lpgn/Carbon-Mini/BOM/screws.pdf

Sheet1

ITEM NO. | PART NUMBER | QTY
49 | Hexagon Flange Nut ISO - 4161 - M5 - N | 100
6 | Hexagon Thin Nut ISO - 4035 - M3 - N | 600
15 | Hexagon Thin Nut ISO - 4035 - M5 - N | 200
30 | ISO 4027 - M2 x 3-N | 100
52 | ISO 4762 – M3 x 12 --- 12N | 100
45 | ISO 7045 - M2 x 10 - Z --- 10N | 100
58 | ISO 7045 - M3 x 10 - Z --- 10N | 200
78 | ISO 7045 - M3 x 16 - Z --- 16N | 200
38 | ISO 7045 - M3 x 20 - Z --- 20N | 100
5 | ISO 7045 - M3 x 25 - Z --- 25N | 200
47 | ISO 7045 - M3 x 6 - Z --- 6N | 100
67 | ISO 7045 - M3 x 8 - Z --- 8N | 100
26 | ISO 7045 - M4 x 12 - Z --- 12N | 100
14 | ISO 7045 - M5 x 10 - Z --- 10N | 100
13 | ISO 7045 - M5 x 12 - Z --- 12N | 100
16 | ISO 7045 - M5 x 20 - Z --- 20N | 100
10 | ISO 7046-1 - M3 x 10 - Z --- 10N | 200
4 | ISO 7046-1 - M3 x 12 - Z --- 12N | 100
25 | ISO 7046-1 - M3 x 8 - Z --- 8N | 200
18 | ISO 7046-1 - M5 x 12 - Z --- 12N | 100
8 | ISO 7380 - M3 x 10 --- 10N | 100
42 | washer (M3 – 0.8mm – 7mm) 10673 type snl_iso | 100
24 | washer (M4 – 0.75mm – 9mm) | 100
