lpgn/Carbon-Mini/BOM/Complete Bom.ods

Sheet: BOM_review
 | ORDER | DESCRIPTION | QTY |  | ORDER | DESCRIPTION | QTY |  | DESCRIPTION | QTY
BAG F |  |  |  | BAG X3 |  |  |  | BAG Y1
 |  | Carbon fiber Z frame's connecting bar | 1 |  | 2 | X-axis Track slider unit (with embedded 3 nuts,172mm) | 1 | BAG Y1A
 | 1 | Carbon fiber main Z frame | 1 | BAG X3 A |  |  |  |  | Carbon fiber Y-axis support | 1
BAG F1 |  |  |  |  | 1 | Round head M3 x 8mm | 3 | BAG Y1B
 |  | M3 nuts | 2 |  |  |  |  |  | Stepper Motor (42HD0401-24 34mm) + 45.5mm wire + Molex 4P | 1
 |  | Round head M3 x 12mm | 2 |  |  |  |  |  | Mini End-stop 45.5mm black thin wire + Molex 3P | 1
BAG F2 |  |  |  |  | 1 | M3 Nut | 3 |  | M2 x 10mm | 2
 | 1 | Carbon fiber Small foot with double face tape and cushion | 4 | BAG X3 B |  |  |  |  | wire Black organizer 38mm | 1
 | 2 | Carbon fiber foot | 2 |  | 3 | Zip ties | 4 |  | zip ties Small | 1
 | 3 | L shaped connector | 4 |  | 4 | MXL Belt (455mm) | 1 |  | Timing Gear 15 tooth MXL | 1
 | 3 | L shaped connector (needs to be drilled to 6mm) | 1 |  | 5 | Round head M3 x 12mm | 1 | BAG Y1C
 | 4 | M5 nuts | 7 |  | 5 | Plastic 5mm washer | 1 |  | Bearings | 4
 | 4 | Round head M5 x 10mm | 1 |  | 6 | M3 Nut | 2 |  | M3 washers | 4
 | 4 | Round head M5 x 12mm | 6 |  | 7 | Printed Extruder's adapter (Rail to tracks) thinken 1mm | 1 |  | Round head M3 x 20mm | 2
BAG F3 |  |  |  |  | 8 | Flat head M3 x 8mm | 4 | BAG Y1D
 | 5 | Precision height Adjuster | 3 | BAG X3 C |  |  |  |  | Round head M3 x 40mm (NUT SCREWED GLUED 25.8) | 2
 | 5 | Magnet - (12x3.79mm) | 3 |  | 9 | Short Track with Slider unit (auto calibration) | 1 |  | M3 nuts | 2
 | 5 | washer 6mm inside | 1 |  | 10 | Round head M3 x 6mm | 2 |  | M3 washers | 2
BAG F4 |  |  |  |  | 11 | Binder clip spring | 1 | BAG Y1E
 |  | Steeper Motor 34mm with 135mm screw 260mm wire Molex P4 | 1 | 1 - BAG E2 – independent |  |  |  |  | Printed Y motor Bracket | 1
 |  | wire Black organizer 255mm | 1 |  |  | Teflon tube 575 mm | 1 |  | M3 nuts | 4
BAG F4 A |  |  |  |  |  |  |  |  | Flat head M3 x10mm | 4
 |  | Printed Z Motor mount NEED TO CHANGE FILE | 1 |  |  |  |  | BAG Y1F
 |  | M3 nuts | 2 |  |  | wire Black organizer 550mm | 1 |  | Printed Magnet spacer | 2
 |  | Round head M3 x 30mm | 2 |  |  | Mini End-stop 58mm black thin wire + Molex 3P | 1 |  | Magnet + (12x3.79mm) | 3
 |  | Flat head M3 x 8mm | 4 |  |  | Assembled hot end unit (with resistor and thermistor) | 1 |  | Flat head M3 x12mm | 1
BAG X1 |  |  |  |  |  | Carbon fiber Hot-end bracket | 1 |  | Flat head M3 x10mm | 2
 | 5 | Carbon fiber X Bridge | 1 |  |  | Round head M3 x 20mm | 2 |  | M3 nuts | 3
BAG X1 A |  |  |  |  |  | Round head M2 x 10mm | 2 | BAG Y2
 | 6 | Round head M3 x 12mm (screwed to the carbon fiber bar and z track) | 2 |  |  | Printed Fan duct mount (Hot-end) | 1 |  | Y-axis Track with slider unit 190mm | 2
 | 6 | Round head M3 x 8mm (screwed to the carbon fiber bar) | 4 |  |  | Big Fan 30mm (Hot-end) + 710 wire with molex 4P and 2p power connector | 1 |  | Acrylic bed | 1
 | 6 | Z-axis Track slider unit (with embedded 3x M3 nuts) | 2 |  |  | Small Fan 26mm (Hot-end) + 650 wire with molex 2P | 2 | BAG Y2 A (OLD B)
 | 2 | Round head M3 x 8mm | 6 |  |  | Round head M2 x 12mm | 8 |  | Round head M3 x 6mm | 8
 | 3 | Round head M3 x 10mm | 2 |  |  | Round head M2 x 20mm | 4 |  | Round head M3 x 6mm | 6
 | 3 | M3 Washers .83mm | 2 |  |  | Small zip tie | 2 | BAG Y4 B (OLD C)
 | 4.5 | Coper nut for motor treaded bar |  | BAG E4 (Extruder Cold end) |  |  |  |  | MXL Belt (300mm) | 1
 | 4 | Printed attachment (X Bridge to Z threaded flange)edit file to compensate washer | 1 |  | 1 | Stepper Motor (42HD0401-24 34mm) + 35mm wire + Molex 4P | 1 |  | Round head M3 x 16mm | 3
 | 1 | Round head M3 x 24mm (attaches the Printed attachment to z special nut) | 3 |  | 2 | Carbon fiber extruder motor spacer | 1 |  | Round head M3 x 20mm | 1
 | 1 | M3 nut | 3 |  | 3 | Extruder Gear | 1 |  | M3 Nut | 4
BAG X2 |  |  |  |  | 4 | Printed Extruder Bracket | 1 |  | spacer 5mm white | 1
 |  | Stepper Motor (42HD0401-24 34mm) + 355mm wire + Molex 4P | 1 | BAG E4 A |  |  |  |  | Printed Belt atachment | 2
BAG X2 A |  |  |  |  | 4 | Teflon quick release adapter | 2 |  | Carbon Fiber Belt atachment | 2
 |  | Printed X Motor attachment | 1 |  | 5 | Flat head M3x 16mm | 1 | BAG P1
 |  | M3 nut | 1 |  | 6 | Bearing for Filament ATTACHED TO LEVER | 1 |  | M3 nut | 4
 |  | Flat head M3 x 8mm | 1 |  | 6 | Printed Extruder Lever (IMPROVE SPACE FOR BEARING) | 1 |  | M3 x 12 --- 12N | 4
 |  | Flat head M3 x 10mm | 1 |  | 6 | M4 Washers | 2 |  | Printer board | 1
 |  | Round head M3 x 8mm (small) | 1 |  | 6 | Round head M4 x 12mm | 1 |  | Plastic 5mm washer | 4
 |  | Timing Gear 15 tooth MXL | 1 |  | 6 | Teflon tube 25mm | 1 |  | Printed printrboard case | 1
BAG X2 B |  |  |  |  | 6 | Teflon quick release adapter | 2 |  | Display
 |  | Round head M3 x 25 - Z --- 25N | 2 |  | 7 | spring 30x15x7.5 | 1 |  | Display cable
 |  | Printed X-axis Bridge spacer | 1 |  | 8 | Round head M3 x 25mm | 1
 |  | Printed X-axis Bridge spacer for end-stop needs to change. To small | 1 |  | 9 | Round head M3 x 30mm | 3
 |  | Mini End-stop 34.5mm black thin wire + Molex 3P | 1
BAG X2 C
 |  | Round head M3 x 20mm | 1
 |  | M3 washer (Dia 7mm) small washer | 1
 |  | Bearings | 2
 |  | M3 nut | 1

Sheet: Parts_Bom
ITEM NO. | PART NUMBER | DESCRIPTION | QTY.
1 | Z Frame | Bag F | 1
2 | Steeper Motor 34mm (42HD0401-135L) | Bag F1 | 1
3 | Z Motor mount | Bag F1 | 1
7 | Z TRACK (MGN9 142.08mm) | Bag F2 | 2
9 | Magnet (12x3.79mm) | Bag F3 (1X) Bag F6 (2X) Bag Y3 (2x) Bag B1 (5x) Bag B2 (4x) | 14
11 | L shaped connector | Bag F4 | 4
12 | Small foot | Bag F4 | 2
17 | Hinge 20x20l | Bag Y4 (1x) | 1
20 | Knurl Adjuster | Bag F6 | 2
21 | Extruder Gear | Bag F7 | 1
22 | Tube (bushings) | Bag F7 | 1
23 | Bearing for Filament (U694) | Bag F7 | 1
27 | Extruder Lever (mirrored) | Bag F7 | 1
28 | Extruder Bracket (mirrored) | Bag F7 | 1
29 | Extruder Stepper Motor (needs reference)2 | Bag F7 | 1
31 | Bed Support | Bag Y | 1
32 | Stepper Motor (42HD0401-24 34mm) | Bag Y1 (1x) Bag X1 (1x) | 2
33 | Timing Gear 15 tooth MXL | Bag Y1 (1x) Bag X1 (1x) | 2
34 | Y Belt (MXL 6mm) Length: ? Mm | Bag Y1 | 1
35 | Y motor Bracket | Bag Y1 | 1
46 | Rail MGN9 | Bag Y3 (2x) Bag X4 (x1) | 5
50 | Printrboard | Bag P1 | 1
51 | Plastic 5mm washer | Bag P1 (4x) Bag B1 (1x) | 5
53 | Y Track (MGN9 190mm) | Bag Y3 (2x) | 2
54 | Y Tracks connection | Bag B1 | 2
57 | BED SPACER | Bag B1 | 2
60 | Glass-bed | Bag B2 | 1
61 | Extruder's adapter (Rail to tracks) | Bag E1 | 1
62 | Rail (MGN9) (for extruder with tracks) | Bag E1 | 1
63 | spring | Bag E1 | 1
64 | Extruder stopper2 | Bag E1 | 1
66 | Auto-calibration Track (MGN9 39mm) | Bag E1 | 1
69 | Hot-end bracket | Bag E1 | 1
70 | End-stop (HT-010-1A-250VAC) | Bag E1 (1x) Bag (1x) Y2 Bag X1 (1x) | 3
73 | Heat Breaker (Hot-end) | Bag E2 | 1
74 | Heat-sink (Hot-end) | Bag E2 | 1
75 | Heat Block (hot-end) | Bag E2 | 1
76 | Nozzle (0.4) (Hot-end) | Bag E2 | 1
79 | FAN for Heat Sink (Hot-end) | Bag E3 | 1
80 | Fan duct hacked (Hot-end) | Bag E3 | 1
81 | Small Fan Mockup (hot-end) | Bag E3 | 2
82 | X Bridge | Bag X | 1
85 | X Motor attachment mirrored | Bag X1 | 1
86 | X Bridge spacer for end-stop | Bag X1 | 1
89 | X Bridge spacer | Bag X1 | 1
90 | X Belt (MXL 6mm) Length: ? Mm | Bag X1 | 1
92 | X Track (MGN9 172mm) | Bag X4 | 1
93 | socket head cap screw_iso2 | Bag X2 | 3
94 | F603HZZ_SOLID_1 | Bag X3 (2x) Bag Y1 (4x) | 6
99 | Threaded Rod Female Special Nut | Bag X4 | 1
100 | Z nut attachment to X Bridge | Bag X4 | 1
 |  |  | 93

Sheet: Screws
ITEM NO. | PART NUMBER | DESCRIPTION | QTY. | times kits (15)
49 | Hexagon Flange Nut ISO - 4161 - M5 - N | Bag Y4 | 2 | 30 | 100
6 | Hexagon Thin Nut ISO - 4035 - M3 - N | Bag F1 (2x) Bag F2 (6x) Bag F3 (1x) Bag Y1 (4x) Bag B1 (13x) Bag X1 (1x) Bag X2 (4x) Bag X3 (1x) Bag X4 (1x) Bag P1 (4x) Bag E1 (2x) | 39 | 585 | 600
15 | Hexagon Thin Nut ISO - 4035 - M5 - N | Bag F4 (6X) Bag F5 (2X) | 8 | 120 | 200
30 | ISO 4027 - M2 x 3-N | Bag F7 | 1 | 15 | 100
52 | ISO 4762 M3 x 12 --- 12N | Bag P1 (4x) Bag B1 (1x) | 5 | 75 | 100
45 | ISO 7045 - M2 x 10 - Z --- 10N | Bag Y2 (2x) Bag E1 (2x) | 4 | 60 | 100
58 | ISO 7045 - M3 x 10 - Z --- 10N | Bag B1 (8x) Bag X4 (3x) Bag X1 (x1) Bag E2 (1x) | 13 | 195 | 200
78 | ISO 7045 - M3 x 16 - Z --- 16N | Bag E3 | 12 | 180 | 200
38 | ISO 7045 - M3 x 20 - Z --- 20N | Bag Y1 (2x) Bag E1 (2x) Bag X3 (1x) | 5 | 75 | 100
5 | ISO 7045 - M3 x 25 - Z --- 25N | Bag F1 (2x) Bag F7 (3X) Bag X1 (2x) Bag Y1 (2) | 7 | 105 | 200
47 | ISO 7045 - M3 x 6 - Z --- 6N | Bag Y3 | 6 | 90 | 100
67 | ISO 7045 - M3 x 8 - Z --- 8N | Bag X1 (1x) Bag E1 (4x) | 5 | 75 | 100
26 | ISO 7045 - M4 x 12 - Z --- 12N | Bag F7 (1x) Bag X1 (1x) Bag X4 (8) | 1 | 15 | 100
14 | ISO 7045 - M5 x 10 - Z --- 10N | Bag F4 | 4 | 60 | 100
13 | ISO 7045 - M5 x 12 - Z --- 12N | Bag F4 | 2 | 30 | 100
16 | ISO 7045 - M5 x 20 - Z --- 20N | Bag F4 | 2 | 30 | 100
10 | ISO 7046-1 - M3 x 10 - Z --- 10N | Bag F3 (1X) Bag Y1 (4x) Bag Y3 (2x) Bag B1 (x1) | 7 | 105 | 200
4 | ISO 7046-1 - M3 x 12 - Z --- 12N | Bag F1 (6x) Bag F6 (2x) | 6 | 90 | 100
25 | ISO 7046-1 - M3 x 8 - Z --- 8N | Bag F7 (1x) Bag E1 (4x) Bag B1 (4x) | 9 | 135 | 200
18 | ISO 7046-1 - M5 x 12 - Z --- 12N | Bag F5 (2x) Bag Y4 (2x) | 2 | 30 | 100
8 | ISO 7380 - M3 x 10 --- 10N | Bag F2 | 6 | 90 | 100
42 | washer (M3 .8mm Dia 7mm) 10673 type snl_iso | Bag Y1 (2x) Bag X3 (1x) | 3 | 45 | 100
24 | washer m4 .75mm diam 9mm | Bag F7 | 2 | 30 | 100
 |  |  | 151

Sheet: Sheet4
BAG B1 |  |  |  | BAG F3 |  |  | BAG Y3
6 | Hexagon Thin Nut ISO - 4035 - M3 - N |  | 13 | 9 | Magnet (12x3.79mm) | 1 | 47 | ISO 7045 - M3 x 6 - Z --- 6N | 6
52 | ISO 4762 M3 x 12 --- 12N |  | 1 | 6 | Hexagon Thin Nut ISO - 4035 - M3 - N | 1 | 10 | ISO 7046-1 - M3 x 10 - Z --- 10N | 2
25 | ISO 7046-1 - M3 x 8 - Z --- 8N |  | 4 | 10 | ISO 7046-1 - M3 x 10 - Z --- 10N | 1 | 9 | Magnet (12x3.79mm) | 2
58 | ISO 7045 - M3 x 10 - Z --- 10N |  | 8 | BAG F4 |  |  | 46 | Rail MGN9 | 2
10 | ISO 7046-1 - M3 x 10 - Z --- 10N |  | 1 | 11 | L shaped connector | 4 | 53 | Y Track (MGN9 190mm) | 2
54 | Y Tracks connection |  | 2 | 12 | Small foot | 2 | BAG Y4
57 | BED SPACER |  | 2 | 14 | ISO 7045 - M5 x 10 - Z --- 10N | 4 | 17 | Hinge 20x20l | 1
51 | Plastic 5mm washer |  | 1 | 13 | ISO 7045 - M5 x 12 - Z --- 12N | 2 | 49 | Hexagon Flange Nut ISO - 4161 - M5 - N | 2
9 | Magnet (12x3.79mm) |  | 5 | 16 | ISO 7045 - M5 x 20 - Z --- 20N | 2 | 18 | ISO 7046-1 - M5 x 12 - Z --- 12N | 2
BAG B2 |  |  |  | 15 | Hexagon Thin Nut ISO - 4035 - M5 - N | 6
60 | Glass-bed |  | 1 | BAG F5 |  |  | BAG P1
9 | Magnet (12x3.79mm) |  | 4 | 15 | Hexagon Thin Nut ISO - 4035 - M5 - N | 2 | 6 | Hexagon Thin Nut ISO - 4035 - M3 - N | 4
BAG E1 |  |  |  | 18 | ISO 7046-1 - M5 x 12 - Z --- 12N | 2 | 52 | ISO 4762 M3 x 12 --- 12N | 4
6 | Hexagon Thin Nut ISO - 4035 - M3 - N |  | 2 | BAG F6 |  |  | 50 | Printrboard | 1
45 | ISO 7045 - M2 x 10 - Z --- 10N |  | 2 | 20 | Knurl Adjuster | 2 | 51 | Plastic 5mm washer | 4
38 | ISO 7045 - M3 x 20 - Z --- 20N |  | 4 | 9 | Magnet (12x3.79mm) | 2
67 | ISO 7045 - M3 x 8 - Z --- 8N |  | 4 | 4 | ISO 7046-1 - M3 x 12 - Z --- 12N | 2 | BAG X1
25 | ISO 7046-1 - M3 x 8 - Z --- 8N |  | 4 |  |  |  | 82 | X Bridge | 1
61 | Extruder's adapter (Rail to tracks) |  | 1 | BAG F7
62 | Rail (MGN9) (for extruder with tracks) |  | 1 | 21 | Extruder Gear | 1 | BAG X1
63 | spring |  | 1 | 22 | Tube (bushings) | 1 | 6 | Hexagon Thin Nut ISO - 4035 - M3 - N | 1
64 | Extruder stopper2 |  | 1 | 23 | Bearing for Filament (U694) | 1 | 58 | ISO 7045 - M3 x 10 - Z --- 10N | 1
66 | Auto-calibration Track (MGN9 39mm) |  | 1 | 27 | Extruder Lever (mirrored) | 1 | 67 | ISO 7045 - M3 x 8 - Z --- 8N | 1
69 | Hot-end bracket |  | 1 | 28 | Extruder Bracket (mirrored) | 1 | 26 | ISO 7045 - M4 x 12 - Z --- 12N | 1
70 | End-stop (HT-010-1A-250VAC) |  | 1 | 29 | Extruder Stepper Motor (needs reference)2 | 1 | 5 | ISO 7045 - M3 x 25 - Z --- 25N | 2
BAG E2 |  |  |  | 30 | ISO 4027 - M2 x 3-N | 1 | 85 | X Motor attachment mirrored | 1
58 | ISO 7045 - M3 x 10 - Z --- 10N |  | 1 | 24 | washer m4 .75mm diam 9mm | 2 | 86 | X Bridge spacer for end-stop | 1
73 | Heat Breaker (Hot-end) |  | 1 | 26 | ISO 7045 - M4 x 12 - Z --- 12N | 1 | 89 | X Bridge spacer | 1
74 | Heat-sink (Hot-end) |  | 1 | 25 | ISO 7046-1 - M3 x 8 - Z --- 8N | 1 | 90 | X Belt (MXL 6mm) Length: ? Mm | 1
75 | Heat Block (hot-end) | v | 1 | 5 | ISO 7045 - M3 x 25 - Z --- 25N | 3 | 32 | Stepper Motor (42HD0401-24 34mm) | 1
76 | Nozzle (0.4) (Hot-end) | v | 1 | BAG Y |  |  | 33 | Timing Gear 15 tooth MXL | 1
BAG E3 |  |  |  | 31 | Bed Support | 1 | 70 | End-stop (HT-010-1A-250VAC) | 1
78 | ISO 7045 - M3 x 16 - Z --- 16N | v | 6 | BAG Y1
79 | FAN for Heat Sink (Hot-end) | v | 1 | 34 | Y Belt (MXL 6mm) Length: ? Mm | 1 | BAG X2
80 | Fan duct hacked (Hot-end) | v | 1 | 35 | Y motor Bracket | 1 | 6 | Hexagon Thin Nut ISO - 4035 - M3 - N | 4
81 | Small Fan Mockup (hot-end) | v | 2 | 32 | Stepper Motor (42HD0401-24 34mm) | 1 | 93 | socket head cap screw_iso2 | 3
82 | Small zip tie |  | 1 | 33 | Timing Gear 15 tooth MXL | 1
BAG F |  |  |  | 94 | F603HZZ_SOLID_1 | 4 | BAG X3
1 | Z Frame |  | 1 | 5 | ISO 7045 - M3 x 25 - Z --- 25N | 2 | 6 | Hexagon Thin Nut ISO - 4035 - M3 - N | 1
BAG F1 |  |  |  | 38 | ISO 7045 - M3 x 20 - Z --- 20N | 2 | 38 | ISO 7045 - M3 x 20 - Z --- 20N | 1
2 | Steeper Motor 34mm (42HD0401-135L) |  | 1 | 42 | washer (M3 .8mm Dia 7mm) 10673 type snl_iso | 2 | 42 | washer (M3 .8mm Dia 7mm) 10673 type snl_iso | 1
3 | Z Motor mount |  | 1 | 6 | Hexagon Thin Nut ISO - 4035 - M3 - N | 4 | 94 | F603HZZ_SOLID_1 | 2
6 | Hexagon Thin Nut ISO - 4035 - M3 - N |  | 2 | 10 | ISO 7046-1 - M3 x 10 - Z --- 10N | 4
5 | ISO 7045 - M3 x 25 - Z --- 25N |  | 2 | BAG Y2 |  |  | BAG X4
4 | ISO 7046-1 - M3 x 12 - Z --- 12N |  | 6 | 70 | End-stop (HT-010-1A-250VAC) | 1 | 6 | Hexagon Thin Nut ISO - 4035 - M3 - N | 1
BAG F2 |  |  |  | 45 | ISO 7045 - M2 x 10 - Z --- 10N | 2 | 58 | ISO 7045 - M3 x 10 - Z --- 10N | 3
7 | Z TRACK (MGN9 142.08mm) |  | 2 |  |  |  | 26 | ISO 7045 - M4 x 12 - Z --- 12N | 8
8 | ISO 7380 - M3 x 10 --- 10N |  | 6 |  |  |  | 92 | X Track (MGN9 172mm) | 1
6 | Hexagon Thin Nut ISO - 4035 - M3 - N |  | 6 |  |  |  | 99 | Threaded Rod Female Special Nut | 1
 |  |  |  |  |  |  | 100 | Z nut attachment to X Bridge | 1
 |  |  |  |  |  |  | 46 | Rail MGN9 | 1

Sheet: to_buy
ITEM NO. | PART NUMBER | QTY
49 | Hexagon Flange Nut ISO - 4161 - M5 - N | 100
6 | Hexagon Thin Nut ISO - 4035 - M3 - N | 600
15 | Hexagon Thin Nut ISO - 4035 - M5 - N | 200
30 | ISO 4027 - M2 x 3-N | 100
52 | ISO 4762 – M3 x 12 --- 12N | 100
45 | ISO 7045 - M2 x 10 - Z --- 10N | 100
58 | ISO 7045 - M3 x 10 - Z --- 10N | 200
78 | ISO 7045 - M3 x 16 - Z --- 16N | 200
38 | ISO 7045 - M3 x 20 - Z --- 20N | 100
5 | ISO 7045 - M3 x 25 - Z --- 25N | 200
47 | ISO 7045 - M3 x 6 - Z --- 6N | 100
67 | ISO 7045 - M3 x 8 - Z --- 8N | 100
26 | ISO 7045 - M4 x 12 - Z --- 12N | 100
14 | ISO 7045 - M5 x 10 - Z --- 10N | 100
13 | ISO 7045 - M5 x 12 - Z --- 12N | 100
16 | ISO 7045 - M5 x 20 - Z --- 20N | 100
10 | ISO 7046-1 - M3 x 10 - Z --- 10N | 200
4 | ISO 7046-1 - M3 x 12 - Z --- 12N | 100
25 | ISO 7046-1 - M3 x 8 - Z --- 8N | 200
18 | ISO 7046-1 - M5 x 12 - Z --- 12N | 100
8 | ISO 7380 - M3 x 10 --- 10N | 100
42 | washer (M3 – 0.8mm – 7mm) 10673 type snl_iso | 100
24 | washer (M4 – 0.75mm – 9mm) | 100

Sheet: BOM_extra
Bag C
 | Z endstop (750mm) + molex 3P + 2 molex metal conector + 2 silver tubes + 2 smal heat shrink tube | 1
 | Fan 1 (750mm) + molex P2 + 2 molex metal conector + 2 silver tubes + 2 smal heat shrink tube | 1
 | Fan 2 (750mm) + 2 silver tubes + 2 smal heat shrink tube | 1
 | Thermistor (840mm) + molex 2P + 2 molex metal conector + 2 silver tubes + 2 smal heat shrink tube | 1
 | Heater (840mm) + molex 4P + 4 molex metal conector + 2 mediun heat shrink tube | 1
 | X endstop (520mm) + molex 3P + 2 molex metal conector + 2 silver tubes + 2 smal heat shrink tube | 1
 | Y endstop (650mm) + molex 3P + 2 molex metal conector + 2 silver tubes + 2 smal heat shrink tube | 1
60 | Glass-bed 160x160mm | 1
