lpgn/Carbon-Mini/Laser/diode.SLDASM

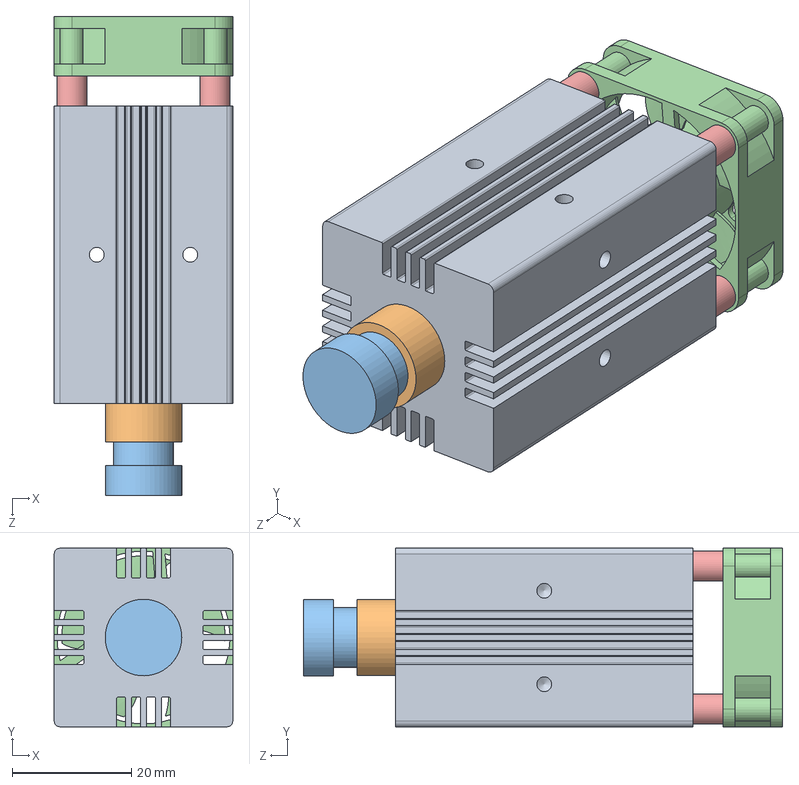
[picture p1: CAD file, 2021-10-29]
Laser/diode.SLDASM
30.0 x 30.0 x 80.4 mm
Heatsink
Diode
Lens
FAN for Heat Sink (Hotend)
Part2^diode x 4
