lpgn/Carbon-Mini/Panel/Panel 2/Panel.SLDASM

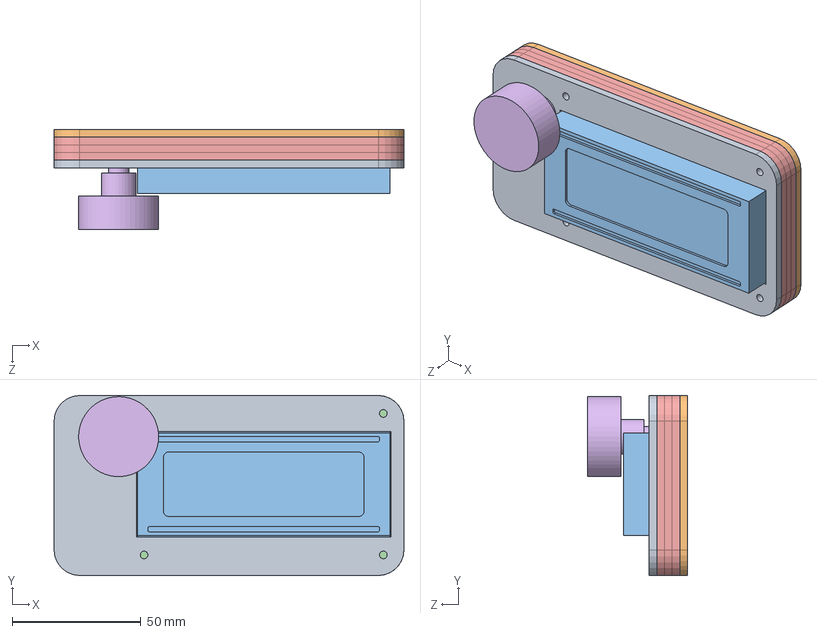
[picture p2: CAD file, 2021-10-29]
Panel/Panel 2/Panel.SLDASM
136.1 x 70.0 x 39.0 mm
Panel
Panel back
lcd
Part2^Panel
Part1^Panel x 3
Part3^Panel
