lpgn/Carbon-Mini/Panel/Panel/Panel.SLDASM

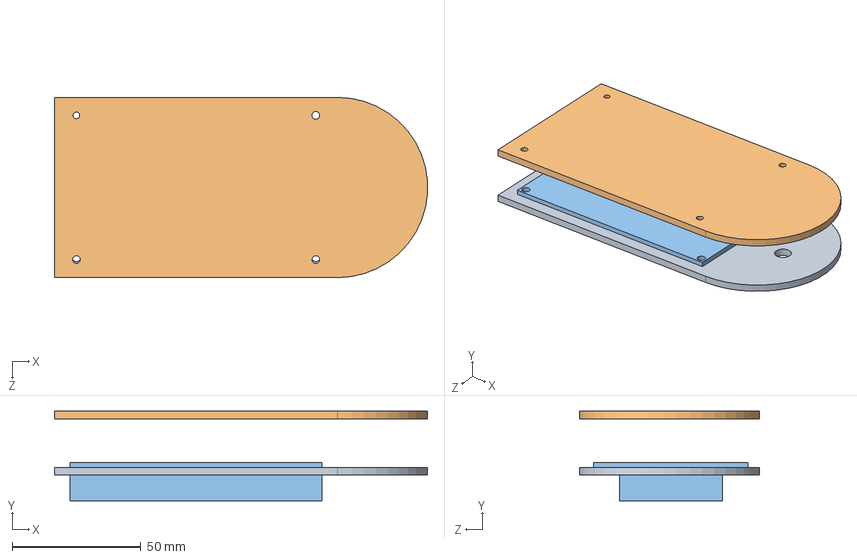
[picture p3: CAD file, 2021-10-29]
Panel/Panel/Panel.SLDASM
144.9 x 34.9 x 70.0 mm
Panel
Panel back
lcd
