lpgn/Carbon-Mini/TO CNC/X FRAME.SLDASM

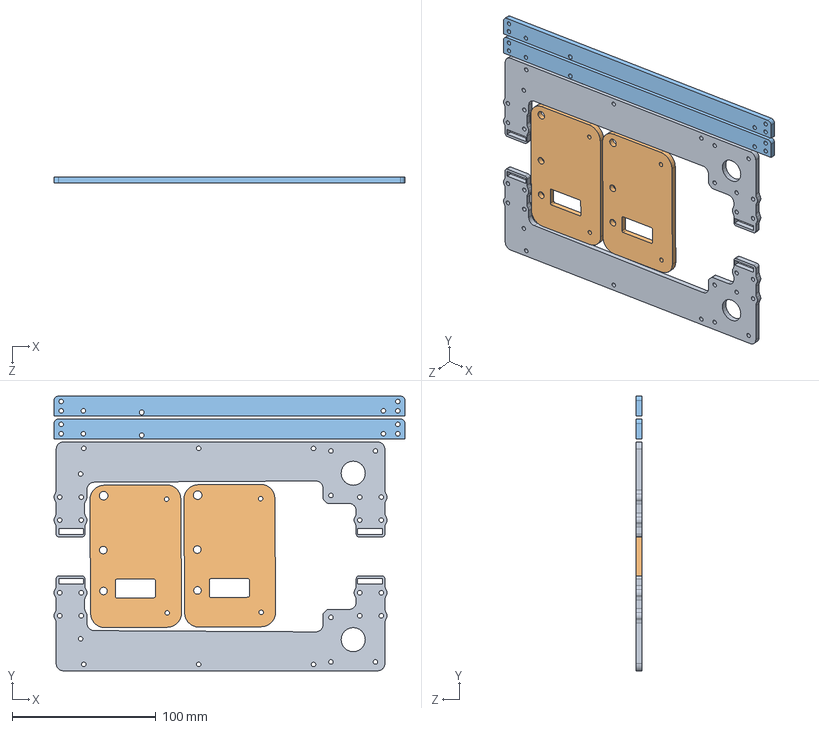
[picture p4: CAD file, 2021-10-29]
TO CNC/X FRAME.SLDASM
244.5 x 191.4 x 4.00 mm
X Bridge 4 x 2
Small foot2 x 2
Handle x 2
