lpgn/Carbon-Mini/TO CNC/To CNC Complete.SLDASM

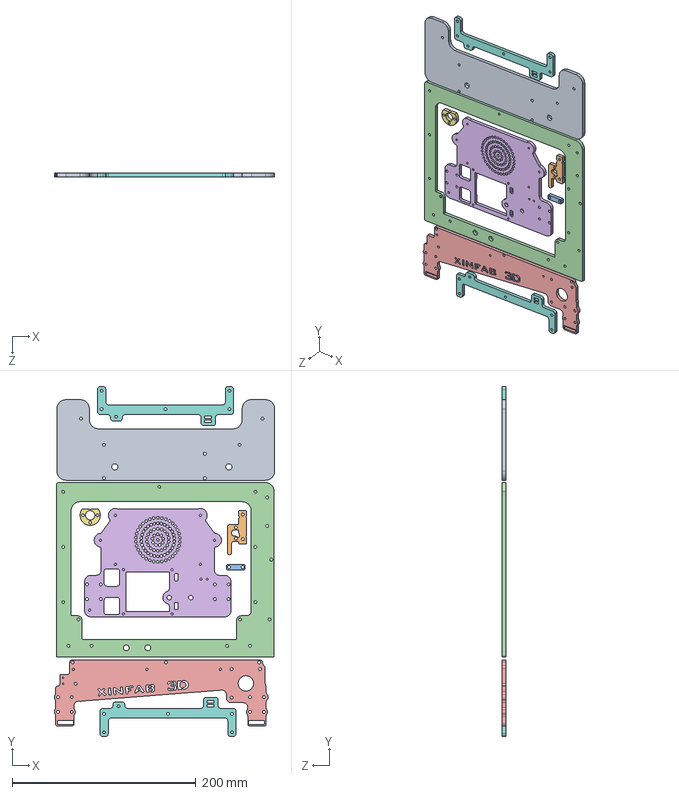
[picture p5: CAD file, 2021-10-29]
TO CNC/To CNC Complete.SLDASM
239.8 x 380.7 x 4.00 mm
FOOT
Extruder stopper2
Hotend bracket
Mini CF Main Frame external3
Mini CF X Bridge 4
Mini CF Y table support.SLDASM1
Mini CF Z nut atachment
TABLE2 x 2
