lpgn/Carbon-Mini/Bed Assembly/Bed Assembly unifyed.SLDASM

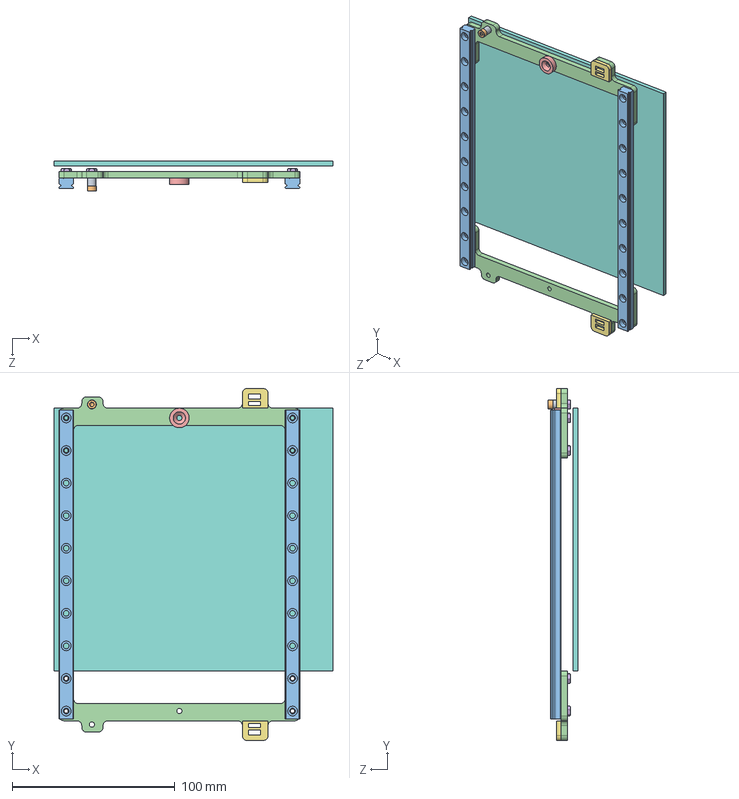
[picture p6: CAD file, 2021-10-29]
Bed Assembly/Bed Assembly unifyed.SLDASM
171.3 x 216.2 x 18.6 mm
Mini CF200x300WP1 TF4 Acrilyc 5mm washer^TF4 x axis
socket head cap screw_iso
Mini CF200x300WP1 TF4 Y Track x 2
TABLE2 x 2
Magnet (12x3.79mm)
hex thin nut chamfered gradeab_iso x 9
BED SPACER x 2
Copy of glassbed
