lpgn/Carbon-Mini/Xbridge/X Stepper Assembly.SLDASM

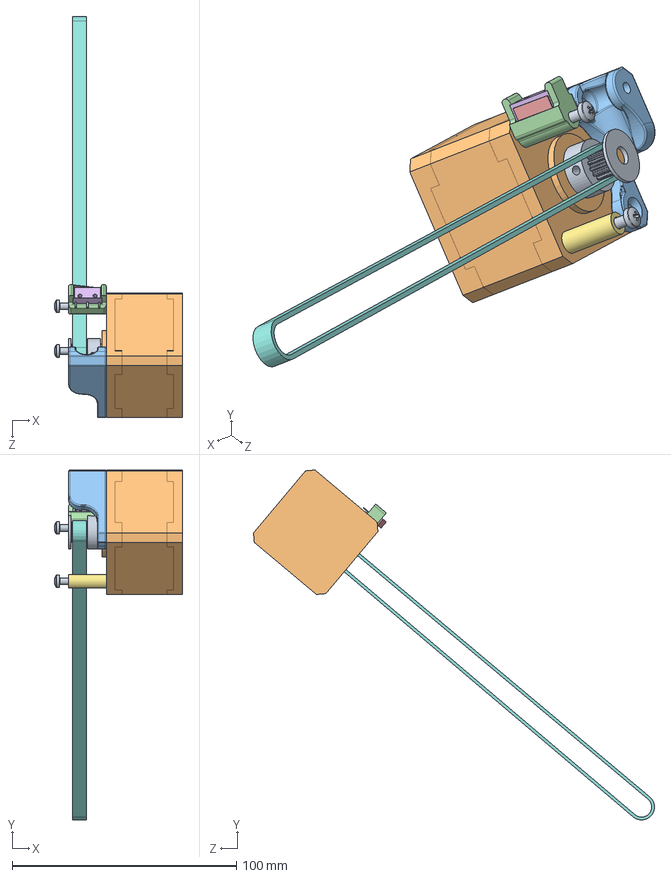
[picture p7: CAD file, 2021-10-29]
Xbridge/X Stepper Assembly.SLDASM
57.1 x 155.9 x 178.7 mm
Timing Gear 15 touth MXL MP
Steper Motor 34mm
X Motor atachment mirror3
X Bridge spacer for endstop
Endstop Actuator 1
Enstop Base 1
X Bridge spacer
X Belt (MXL)
pan head cross recess screw_iso1 x 2
