lpgn/Carbon-Mini/Extruder with tracks revised/Fan Duct Assembly-surface.SLDASM

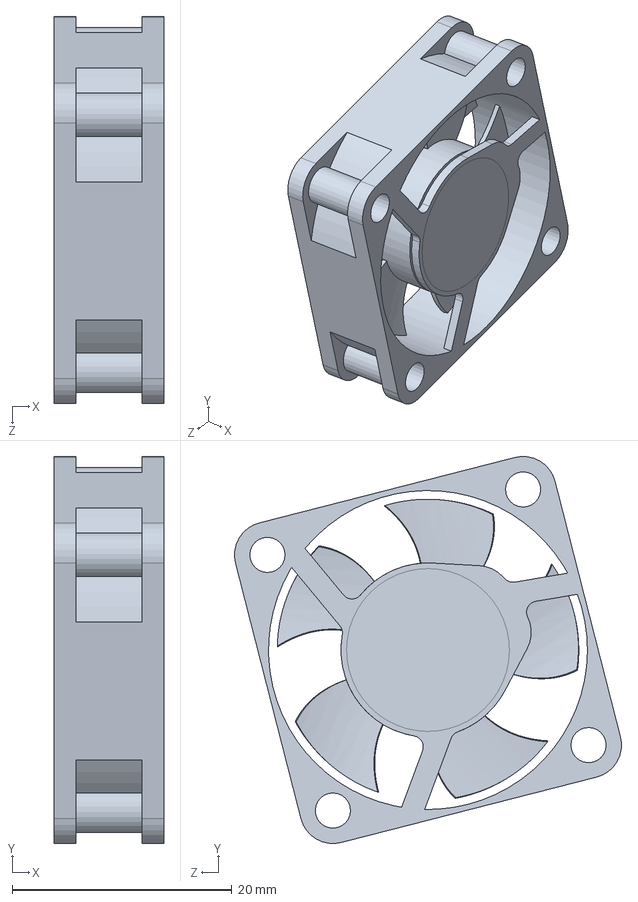
[picture p8: CAD file, 2021-10-29]
Extruder with tracks revised/Fan Duct Assembly-surface.SLDASM
10.0 x 35.2 x 35.2 mm
