lpgn/Carbon-Mini/Frame Assembly/Prescision tool/bed calibration device.SLDASM

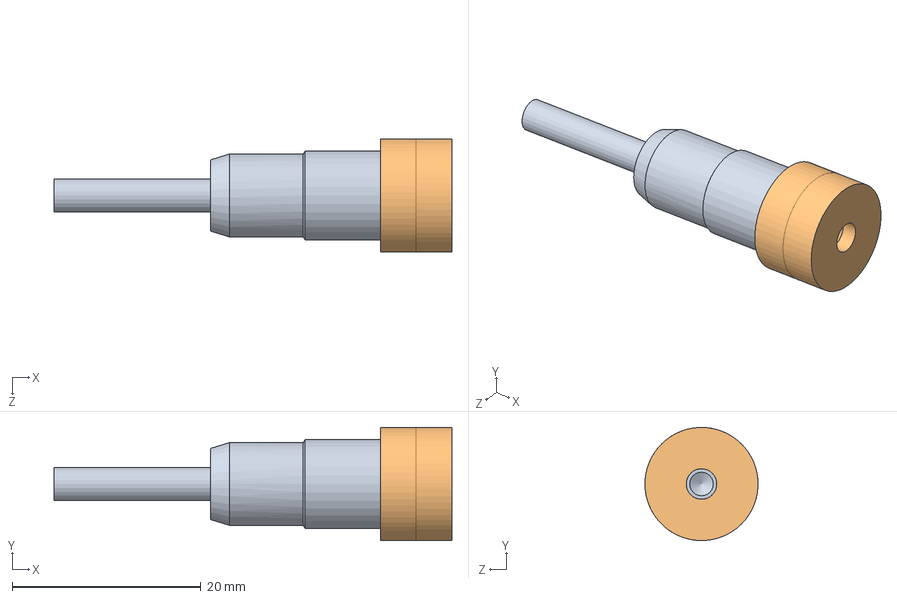
[picture p9: CAD file, 2021-10-29]
Frame Assembly/Prescision tool/bed calibration device.SLDASM
42.2 x 12.0 x 12.0 mm
metal knurl
Magnet (12x3.79mm) x 2
