lpgn/Carbon-Mini/TO CNC/Z AND Y FRAME PLUS SMALL ONES2.SLDASM

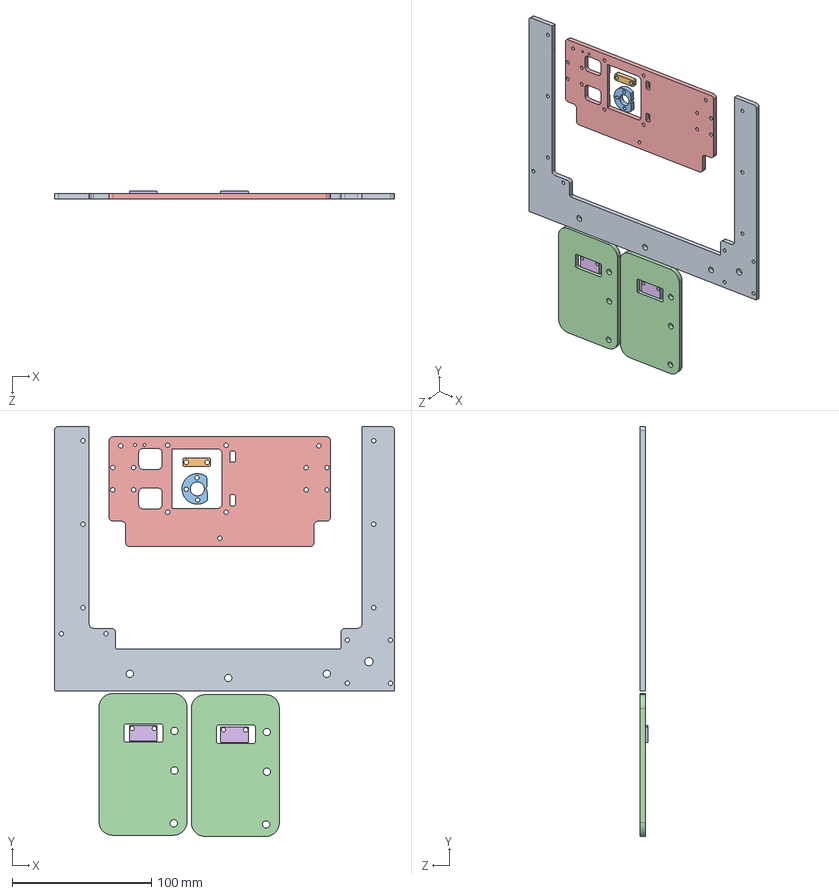
[picture p10: CAD file, 2021-10-29]
TO CNC/Z AND Y FRAME PLUS SMALL ONES2.SLDASM
244.5 x 294.7 x 6.00 mm
Z Frame
Hotend bracket
Z nut atachment to X Bridge
Small foot2 x 2
Bed Support2
BELT HOLDER x 2
