lpgn/Carbon-Mini/Extruder with tracks revised/new fast connect.SLDASM

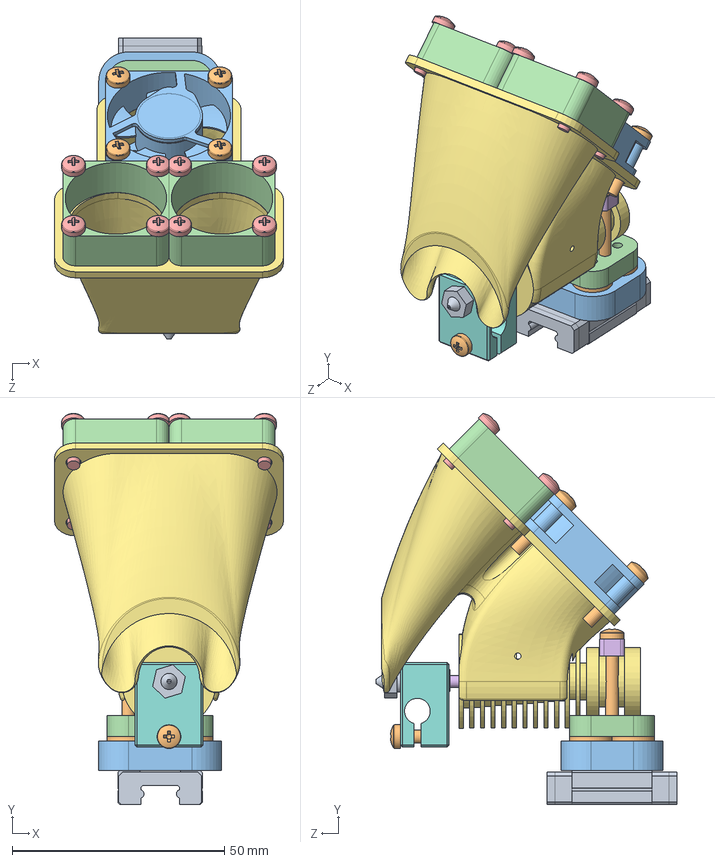
[picture p11: CAD file, 2021-10-29]
Extruder with tracks revised/new fast connect.SLDASM
54.0 x 92.1 x 70.9 mm
Rail (MGN9) (for extruder with tracks)
Magnet 10mm^new fast connect x 8
Part6^new fast connect
Part7^new fast connect
flat head screw_am1 x 4
Heat Breaker (Hotend)
Heatsink (Hotend)
Heat Block (hotend)
Nozzle (0.4) (Hotend)
pan head cross recess screw_iso1 x 7
FAN for Heat Sink (Hotend)
Small Fan Mockup (hotend) x 2
pan cross head_am1 x 8
Hotend bracket
officialE3DV6fanduct
hex nut style 1_am1 x 2
