lpgn/Carbon-Mini/Frame Assembly/Zmotor.sldasm

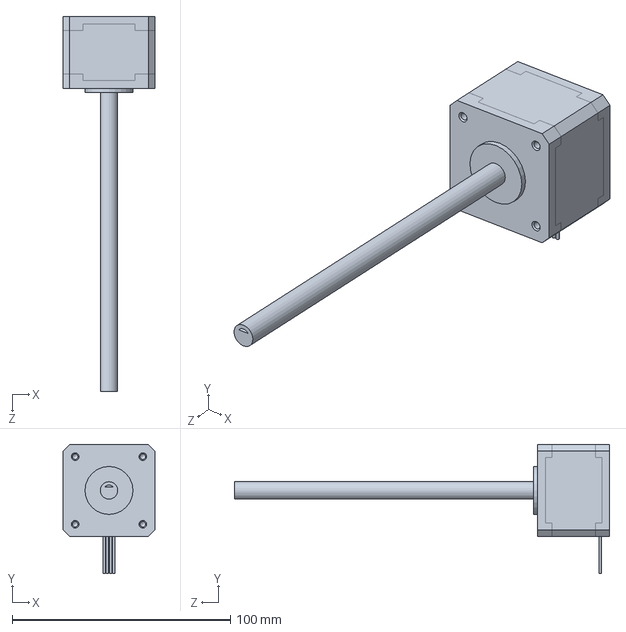
[picture p12: CAD file, 2021-10-29]
Frame Assembly/Zmotor.sldasm
42.1 x 59.1 x 172.0 mm
