lpgn/Carbon-Mini/Y table support Assembly/F603HZZ.SLDASM

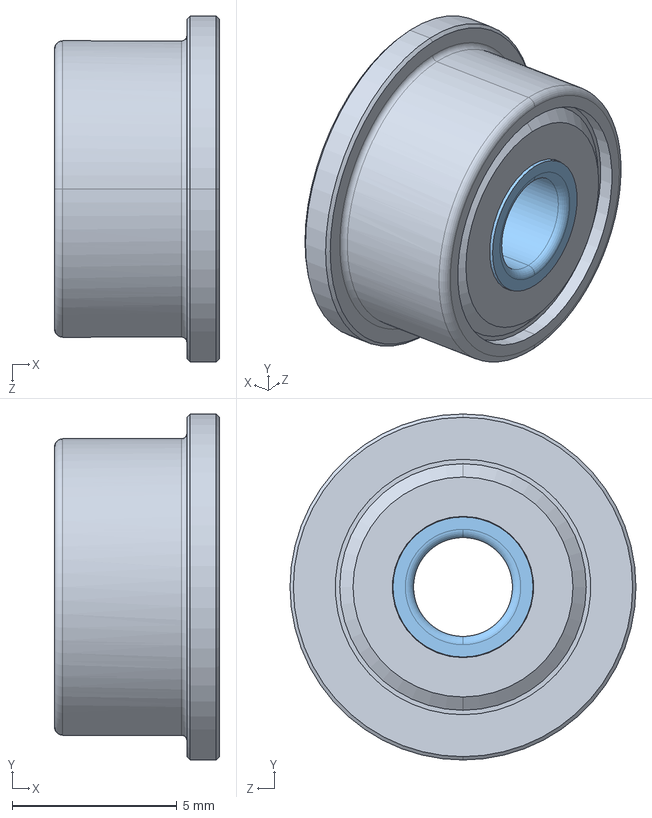
[picture p13: CAD file, 2021-10-29]
Y table support Assembly/F603HZZ.SLDASM
5.00 x 10.5 x 10.5 mm
F603HZZ_SOLID_1
F603HZZ_SOLID_2
F603HZZ_SOLID_3
