lpgn/Carbon-Mini/Extruder cold end/bearing assembly for cold end2.SLDASM

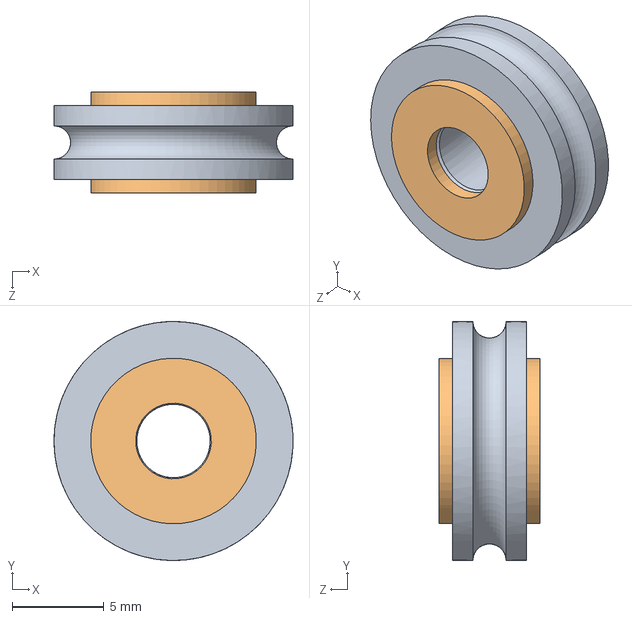
[picture p14: CAD file, 2021-10-29]
Extruder cold end/bearing assembly for cold end2.SLDASM
13.0 x 13.0 x 5.50 mm
Bearing for Filament (U694)
washer m4 .75mm x 2
