lpgn/Carbon-Mini/Y table support Assembly/Bearing assembly1-surface.sldasm

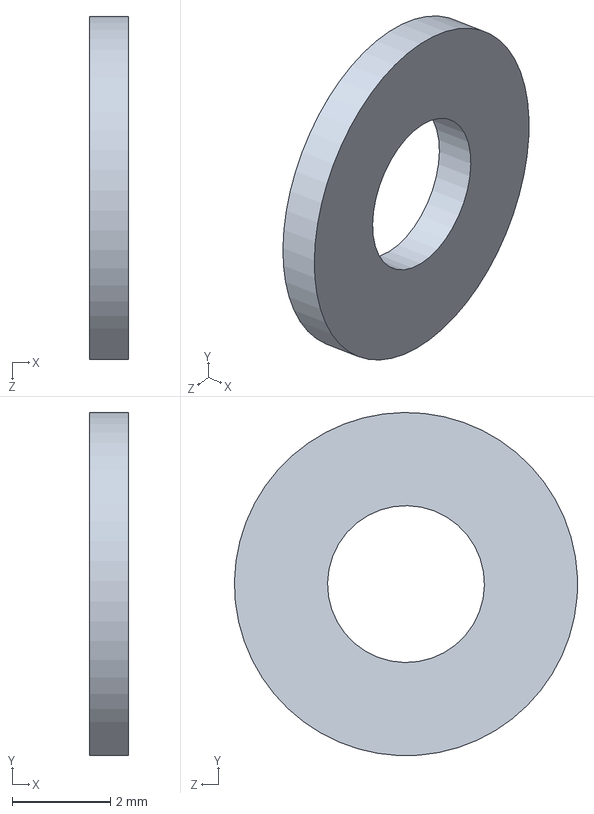
[picture p15: CAD file, 2021-10-29]
Y table support Assembly/Bearing assembly1-surface.sldasm
0.8 x 7.00 x 7.00 mm
