lpgn/Carbon-Mini/Panel/Panel 2/New Panel Box.SLDASM

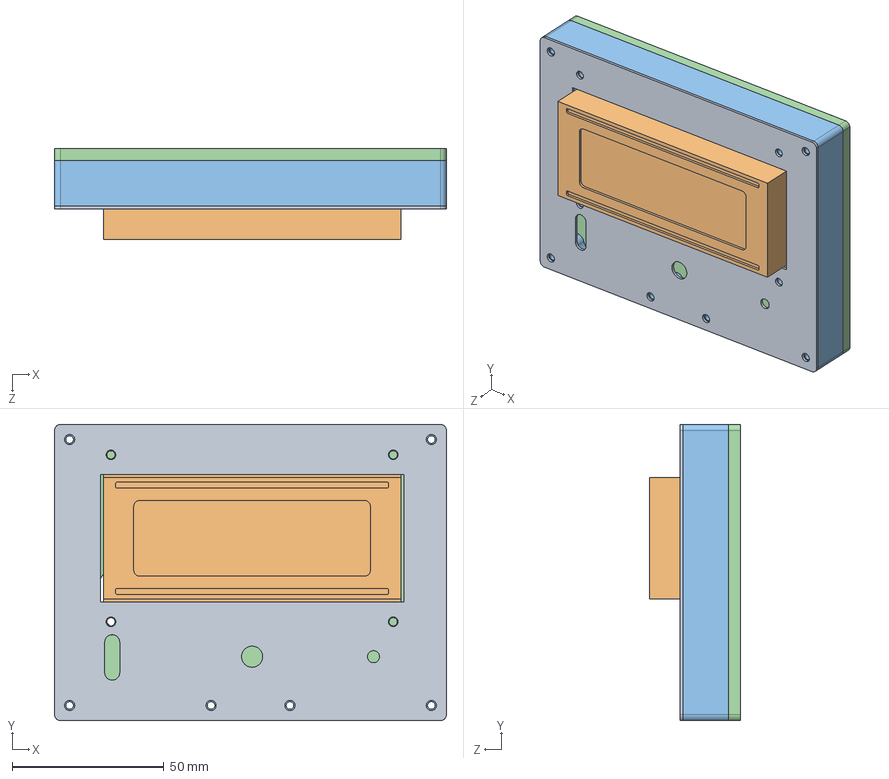
[picture p16: CAD file, 2021-10-29]
Panel/Panel 2/New Panel Box.SLDASM
129.2 x 97.6 x 30.0 mm
P0ANEL
lcd
panel case printed2
back cover
