lpgn/Carbon-Mini/TO CNC/BED THING.SLDASM

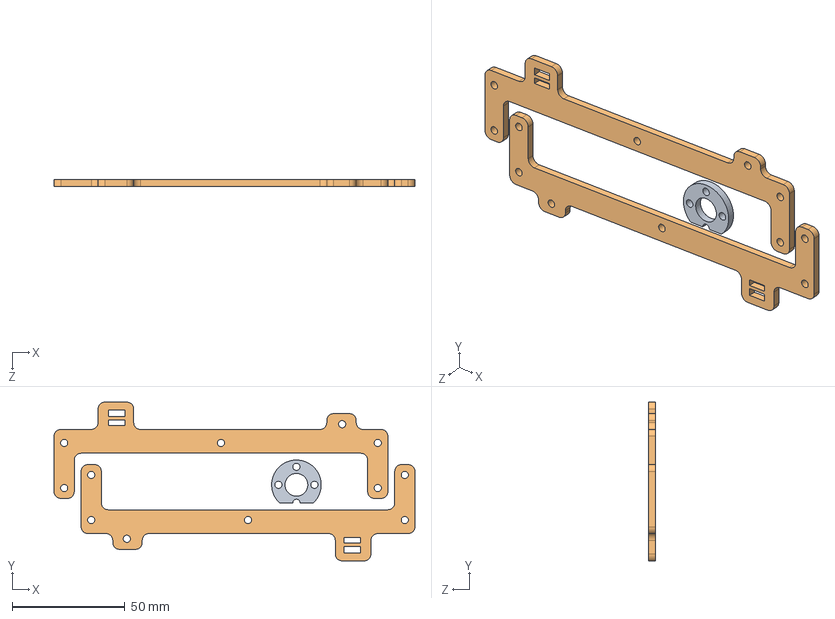
[picture p17: CAD file, 2021-10-29]
TO CNC/BED THING.SLDASM
160.0 x 70.4 x 3.00 mm
Mini CF Z nut atachment
TABLE2 x 2
