lpgn/Carbon-Mini/Extruder cold end/Modified extruder cold end.SLDASM

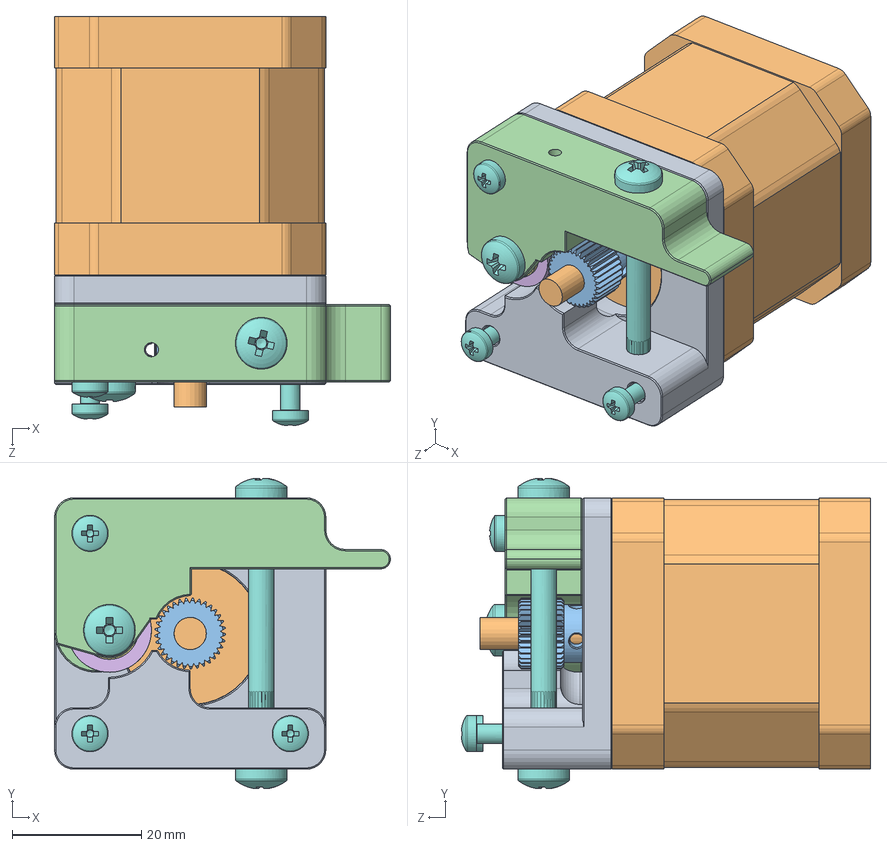
[picture p18: CAD file, 2021-10-29]
Extruder cold end/Modified extruder cold end.SLDASM
52.0 x 48.0 x 63.4 mm
motor_bracket
Stepper Motor - Extruder
gear
clip
bush
special_bearing
washer m4 .75mm x 2
pan head cross recess screw_iso x 6
countersunk flat head cross recess screw_iso x 2
