lpgn/Carbon-Mini/TO CNC/Z AND Y FRAME PLUS SMALL ONES.SLDASM

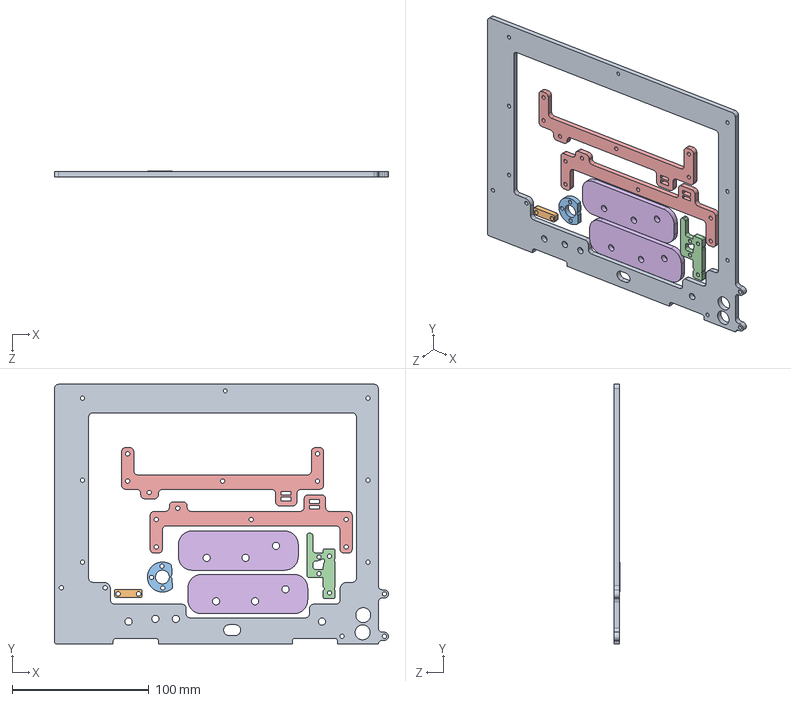
[picture p19: CAD file, 2021-10-29]
TO CNC/Z AND Y FRAME PLUS SMALL ONES.SLDASM
244.5 x 190.0 x 4.20 mm
Mini CF Main Frame external3
Copy (2) of Part4
Mini CF Z nut atachment
Extruder stopper2
TABLE2 x 2
Small foot x 2
