lpgn/Carbon-Mini/Y table support Assembly/Rail Assembly.SLDASM

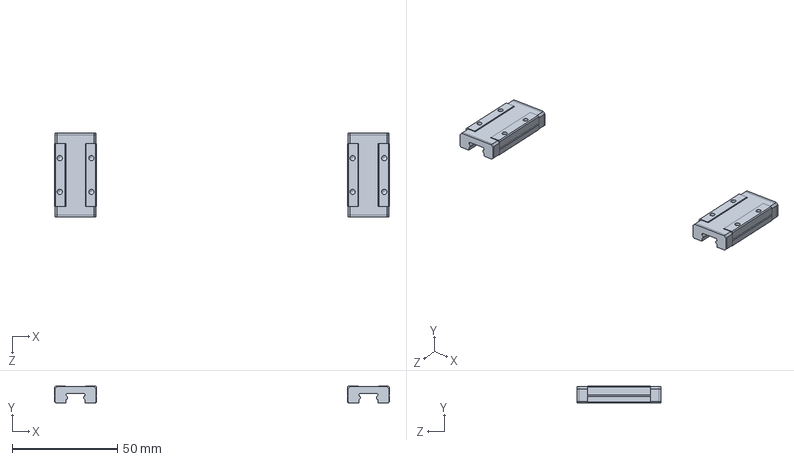
[picture p20: CAD file, 2021-10-29]
Y table support Assembly/Rail Assembly.SLDASM
159.0 x 8.00 x 39.9 mm
Rail MGN9 x 2
