lpgn/Carbon-Mini/TO CNC/FOOR AND X.SLDASM

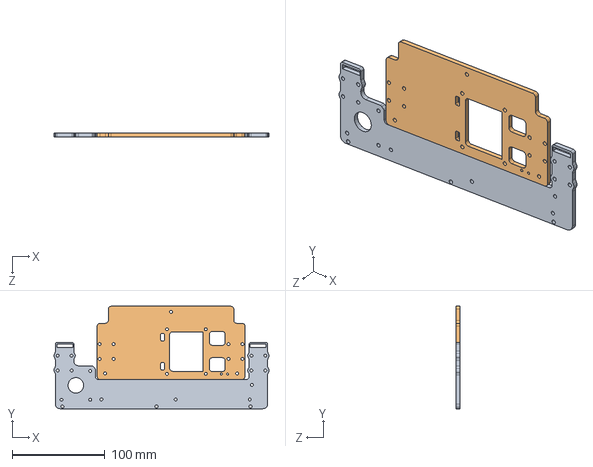
[picture p21: CAD file, 2021-10-29]
TO CNC/FOOR AND X.SLDASM
231.9 x 110.6 x 4.00 mm
X Bridge 4
Bed Support2
