lpgn/Carbon-Mini/Extruder with tracks revised/Fan Duct Assembly.SLDASM

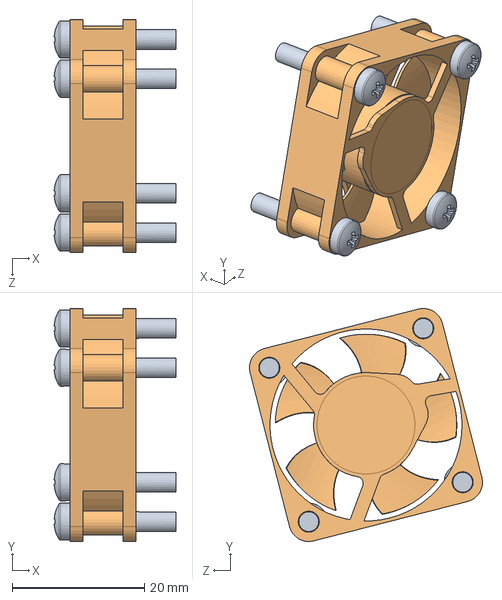
[picture p22: CAD file, 2021-10-29]
Extruder with tracks revised/Fan Duct Assembly.SLDASM
18.4 x 35.2 x 35.2 mm
pan head cross recess screw_iso1 x 4
FAN for Heat Sink (Hotend)
