lpgn/Carbon-Mini/TO CNC/Z AND Y FRAME PLUS SMALL ONES3 incomplete.SLDASM

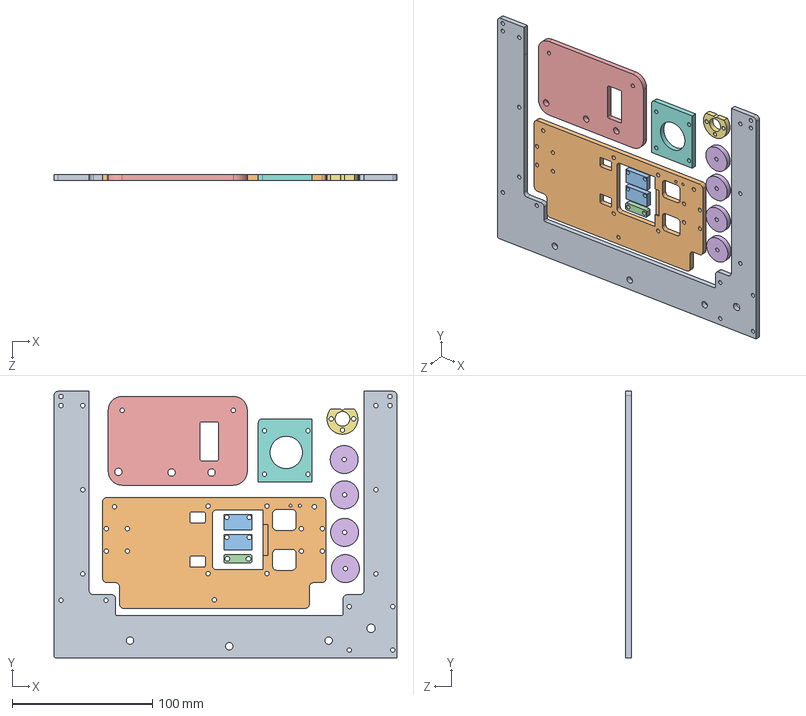
[picture p23: CAD file, 2021-10-29]
TO CNC/Z AND Y FRAME PLUS SMALL ONES3 incomplete.SLDASM
244.5 x 190.0 x 4.00 mm
Z Frame
Bed Support2
BELT HOLDER x 2
Hotend bracket
Small foot2
foot x 4
Z nut atachment to X Bridge
motor spacer
