lpgn/Carbon-Mini/Bed Assembly/Bed Assembly.SLDASM

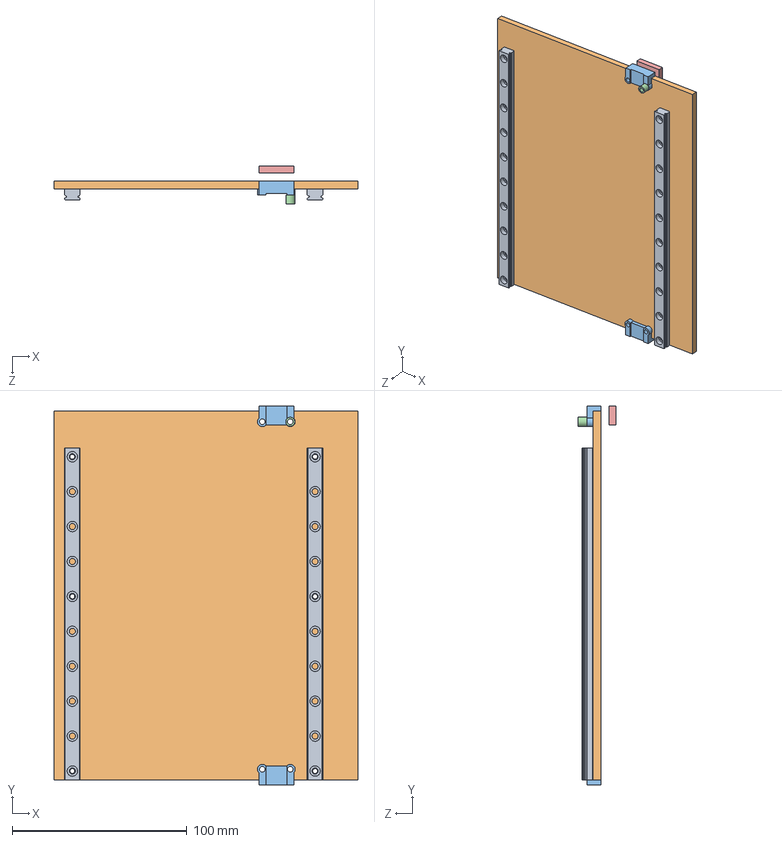
[picture p24: CAD file, 2021-10-29]
Bed Assembly/Bed Assembly.SLDASM
174.1 x 217.0 x 21.6 mm
Y Track (MGN9 190mm) x 2
Glassbed2
belt hoder2 x 2
Mini CF200x300WP1 TF4 Acrilyc 5mm washer^TF4 x axis
BELT HOLDER
