lpgn/Carbon-Mini/Panel/Panel 2/Panel1.SLDASM

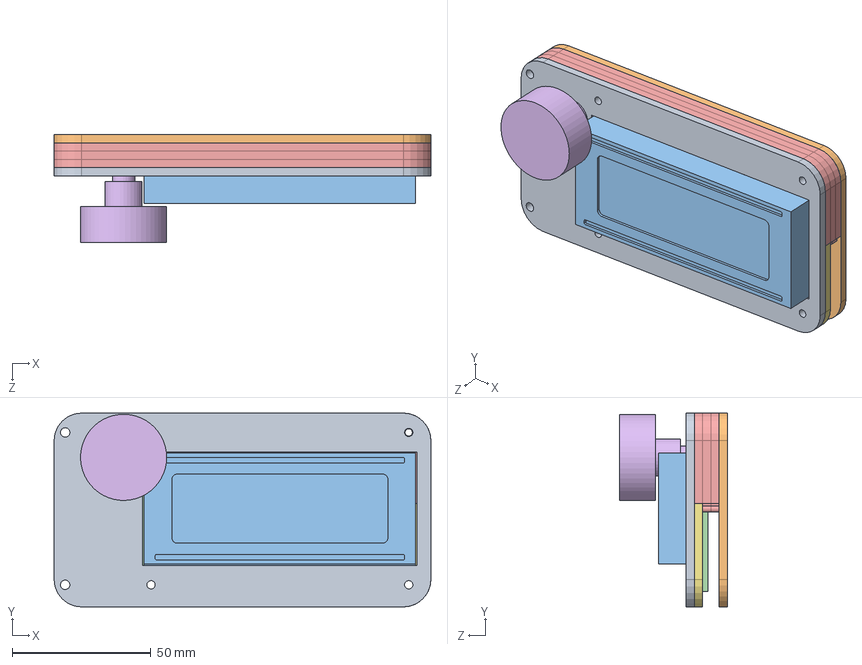
[picture p25: CAD file, 2021-10-29]
Panel/Panel 2/Panel1.SLDASM
136.1 x 70.0 x 39.0 mm
Panel
Panel back
lcd
Part2^Panel
Part1^Panel2 x 3
Part3^Panel1
Part1^Pane3
