lpgn/Carbon-Mini/Bed Assembly/Glassbed Assembly.SLDASM

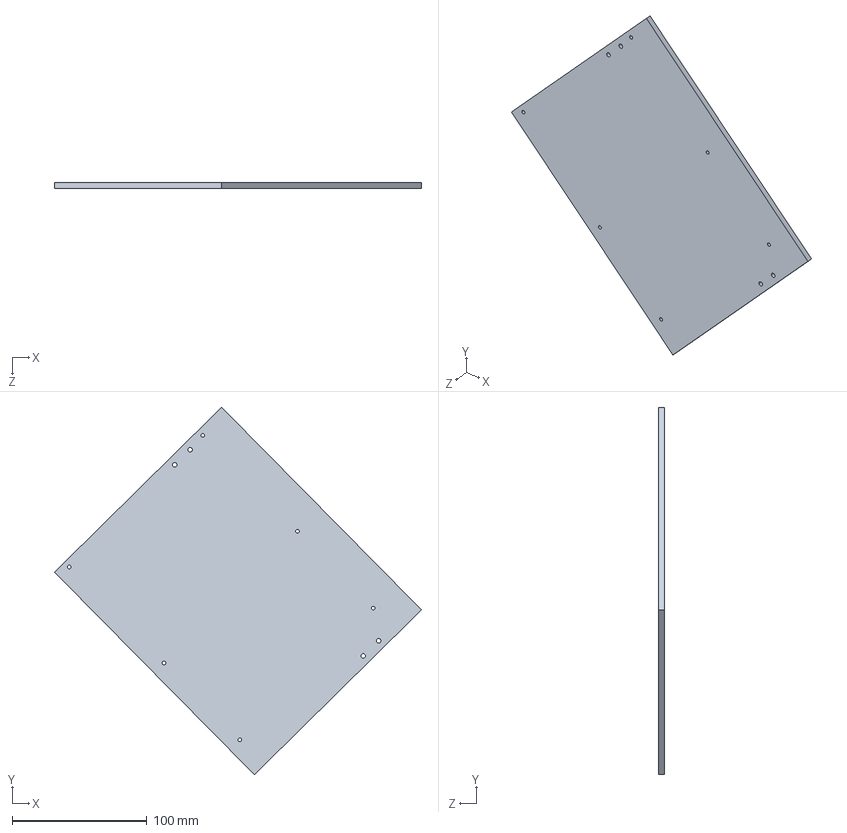
[picture p26: CAD file, 2021-10-29]
Bed Assembly/Glassbed Assembly.SLDASM
272.1 x 272.5 x 4.40 mm
