lpgn/Carbon-Mini/Frame Assembly/Frame assembly.sldasm

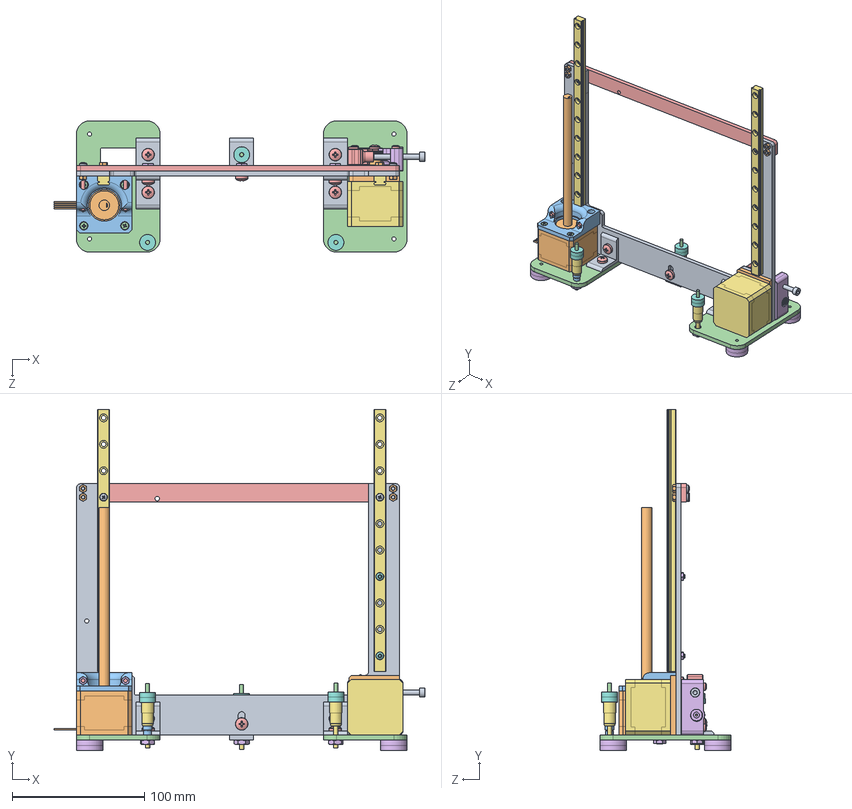
[picture p28: CAD file, 2021-10-29]
Frame Assembly/Frame assembly.sldasm
280.6 x 258.3 x 99.2 mm
Z Frame2
Steper Motor 34mm (42HD0401-135L)
Z Motor mount5
countersunk flat head cross recess screw_iso1 x 11
pan head cross recess screw_iso1 x 13
hex thin nut chamfered gradeab_iso1 x 15
Z TRACK (MGN9 Length 142.08mm) x 2
socket button head screw_iso1 x 3
L shaped conector x 5
Extruder Gear
Bearing for Filament (U694)
washer m4 .75mm x 2
Extruder Lever (mirrored) 4
Extruder Bracket (mirrored)hacked for no bolden
Extruder Steper Motor (needs reference)2
socket set screw cone point_iso1
socket head cap screw_iso1
motor spacer
metal intrnal measurement nut
Small foot2 x 2
Handle
circle foot x 8
metal knurl x 3
Magnet (12x3.79mm) x 6
pan cross head_am1 x 6
hex nut style 1_am1 x 6
