lpgn/Carbon-Mini/Extruder with tracks revised/Extruders Rail Assembly-surface.SLDASM

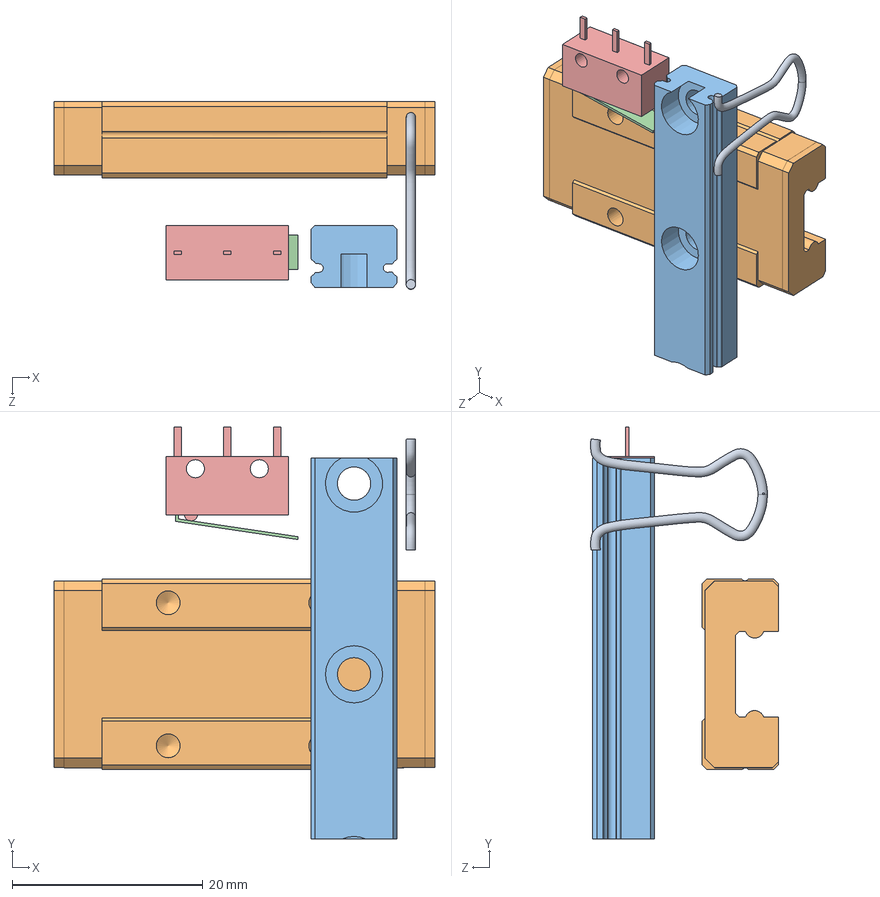
[picture p29: CAD file, 2021-10-29]
Extruder with tracks revised/Extruders Rail Assembly-surface.SLDASM
39.9 x 43.2 x 19.7 mm
spring
Rail (MGN-9) (for extruder)
Track Autocalibration
Endstop Actuator
Mini Enstop Base
