lpgn/Carbon-Mini/Frame Assembly/Knurl Adjuster's assembly2.SLDASM

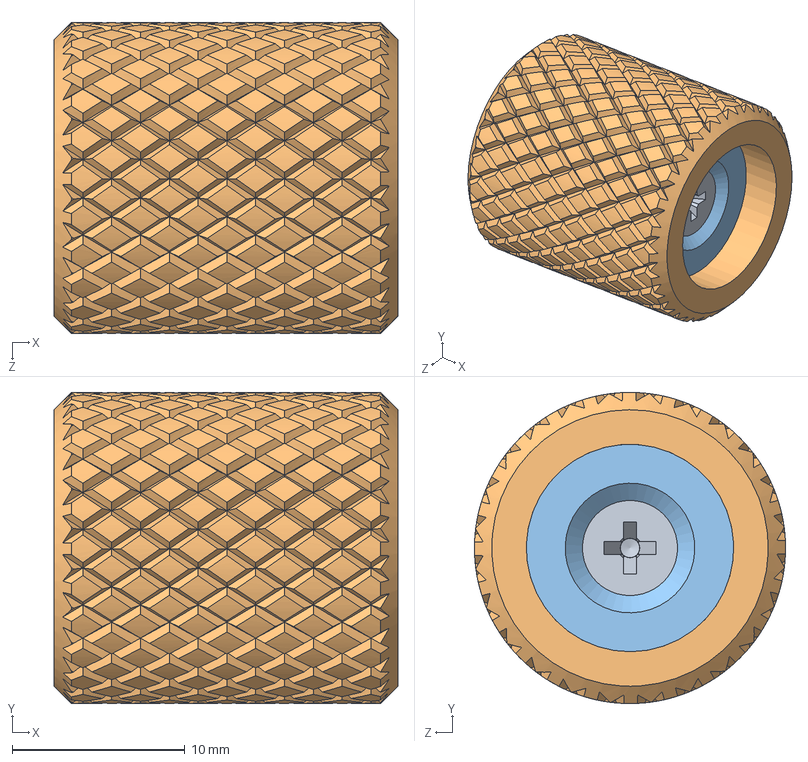
[picture p30: CAD file, 2021-10-29]
Frame Assembly/Knurl Adjuster's assembly2.SLDASM
19.9 x 18.0 x 18.0 mm
ISO 7046-1 - M3 x 10 - Z --- 10N
Knurl Adjuster
Magnet (12x3.79mm)
