lpgn/Carbon-Mini/Frame Assembly/Base Assembly.SLDASM

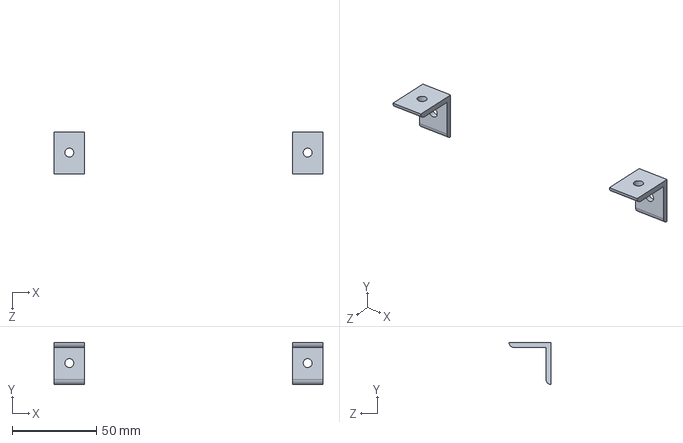
[picture p31: CAD file, 2021-10-29]
Frame Assembly/Base Assembly.SLDASM
159.8 x 25.0 x 25.0 mm
L shaped conector x 2
