lpgn/Carbon-Mini/Y table support Assembly/Endstop assembly.sldasm

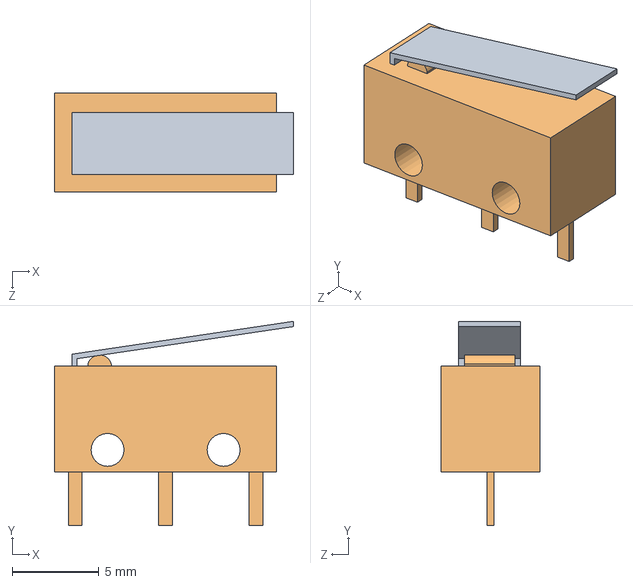
[picture p32: CAD file, 2021-10-29]
Y table support Assembly/Endstop assembly.sldasm
13.8 x 11.8 x 5.72 mm
Endstop Actuator (HT-010-1A-250VAC)
Enstop Base (HT-010-1A-250VAC)
