lpgn/Carbon-Mini/Xbridge/X Bridge assembly mirror2.SLDASM

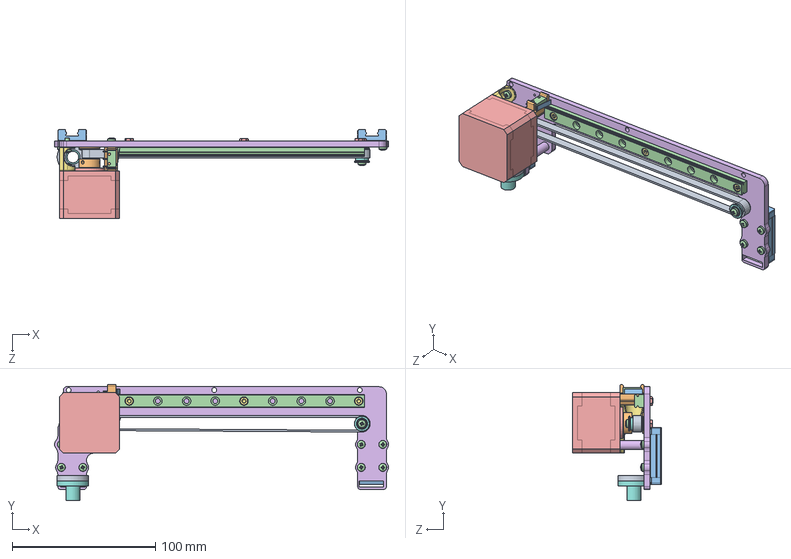
[picture p33: CAD file, 2021-10-29]
Xbridge/X Bridge assembly mirror2.SLDASM
232.8 x 80.9 x 61.7 mm
Mini CF X Belt (MXL)
Timing Gear 15 touth MXL
Rail MGN9 x 2
Mini CF TRACK
Steper Motor (42HD0401-24, 34mm)
Mini CF X Bridge spacer
ISO 4762 M3 x 10 --- 10N x 3
F603HZZ_SOLID_1 x 2
F603HZZ_SOLID_2 x 2
F603HZZ_SOLID_3 x 2
plain washer 10673 type snl_iso
ISO 7045 - M3 x 20 - Z --- 20N x 14
hex thin nut chamfered gradeab_iso x 4
Mini CF X Bridge 4
Mini CF X Motor atachment mirror
Mini CF Z Treaded Rod Female Special Nut
Mini CF Z nut atachment
Mini CF X Bridge spacer FOR ENDSTOP
Endstop Actuator (HT-010-1A-250VAC)
Enstop Base (HT-010-1A-250VAC)
