lpgn/Carbon-Mini/Extruder with tracks revised/new fast connect-surface.SLDASM

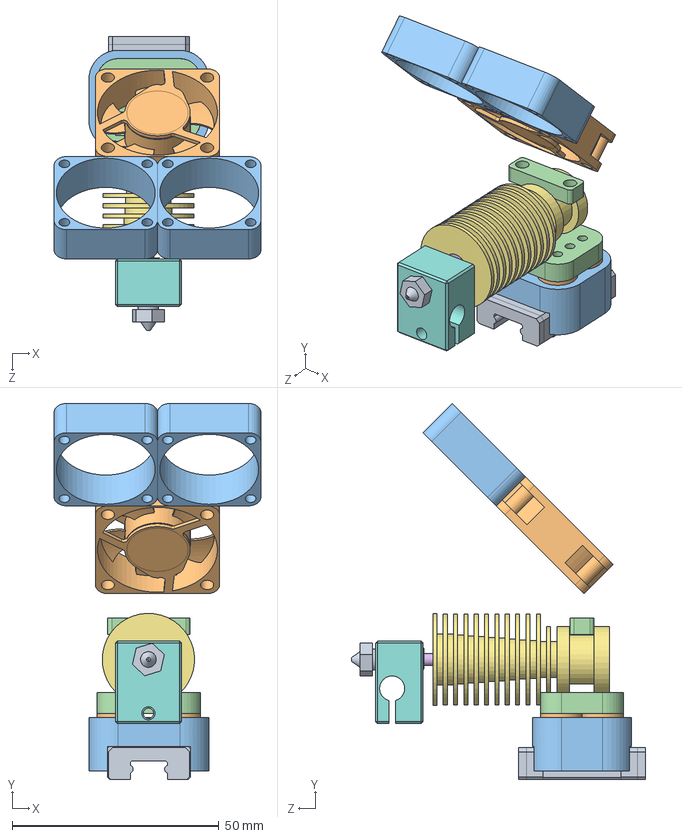
[picture p34: CAD file, 2021-10-29]
Extruder with tracks revised/new fast connect-surface.SLDASM
50.0 x 90.9 x 70.9 mm
Rail (MGN9) (for extruder with tracks)
Magnet 10mm^new fast connect x 8
Part6^new fast connect
Part7^new fast connect
flat head screw_am x 4
Heat Breaker (Hotend)
Heatsink (Hotend)
Heat Block (hotend)
Nozzle (0.4) (Hotend)
FAN for Heat Sink (Hotend)
Small Fan Mockup (hotend) x 2
Hotend bracket
