lpgn/Carbon-Mini/Extruder cold end/bearing assembly for cold end.SLDASM

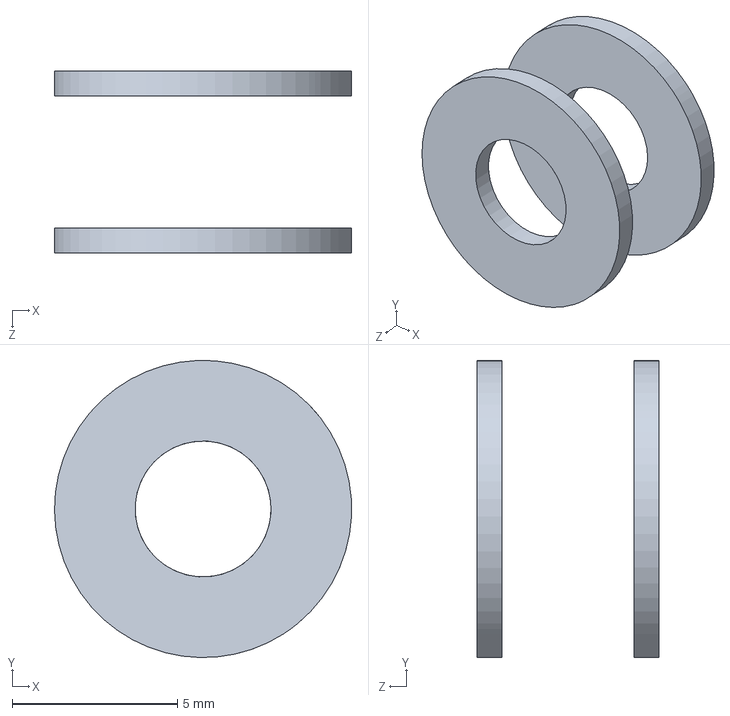
[picture p35: CAD file, 2021-10-29]
Extruder cold end/bearing assembly for cold end.SLDASM
8.99 x 9.00 x 5.50 mm
washer m4 .75mm x 2
