lpgn/Carbon-Mini/Frame Assembly/Zmotor2.SLDASM

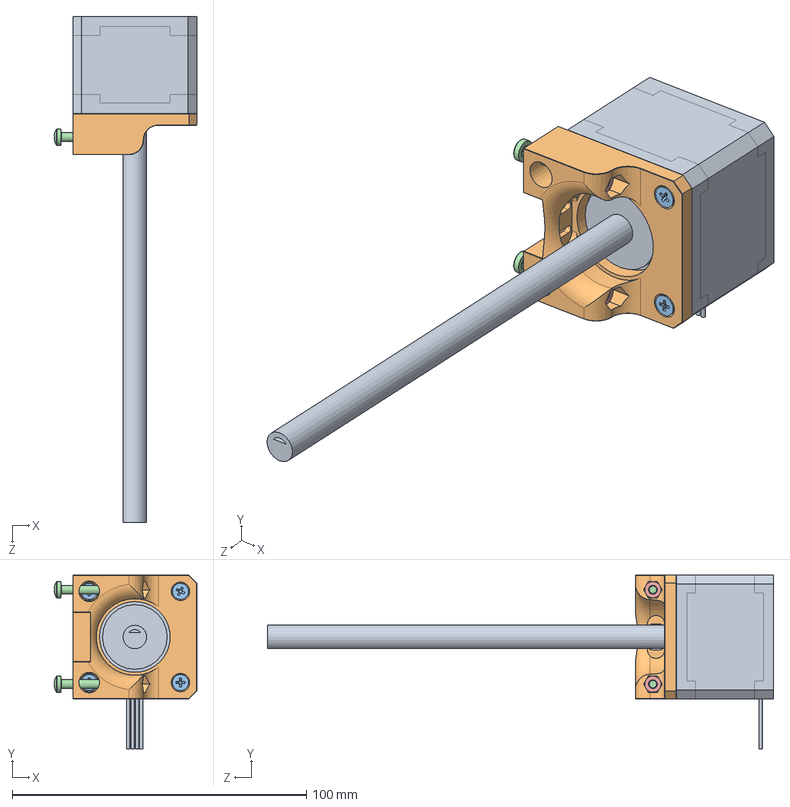
[picture p36: CAD file, 2021-10-29]
Frame Assembly/Zmotor2.SLDASM
48.5 x 59.1 x 172.0 mm
Steper Motor 34mm (42HD0401-135L)
Z Motor mount
ISO 7046-1 - M3 x 10 - Z --- 10N x 4
ISO 7045 - M3 x 20 - Z --- 20N x 2
hex thin nut chamfered gradeab_iso x 2
