lpgn/Carbon-Mini/Frame Assembly/Frame assembly-surface.sldasm

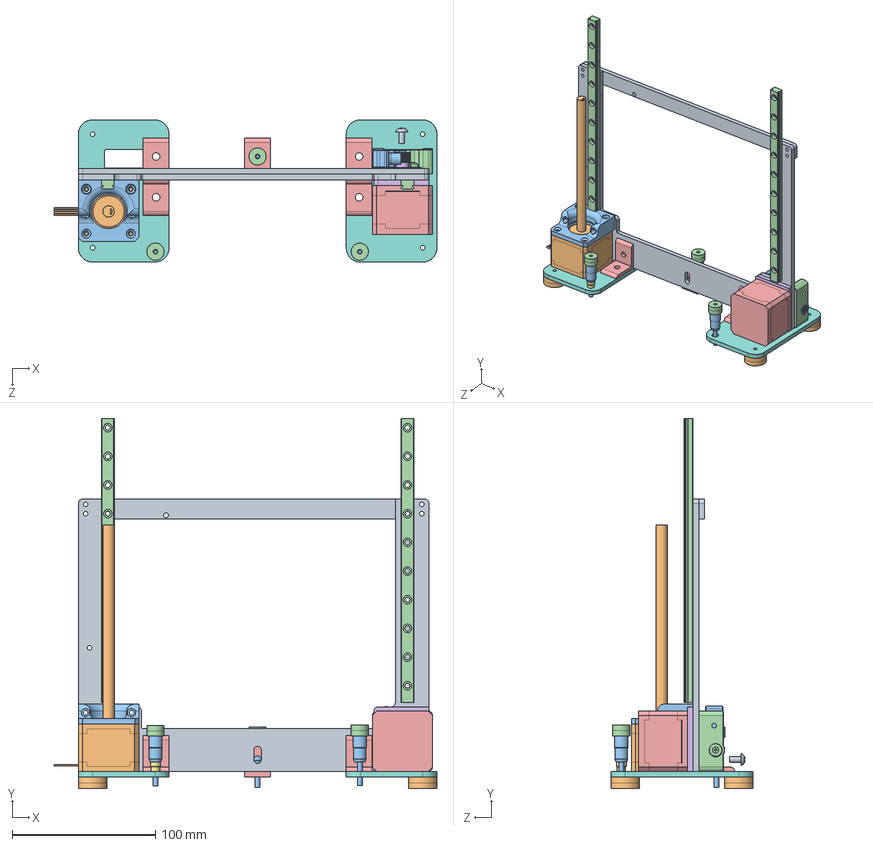
[picture p37: CAD file, 2021-10-29]
Frame Assembly/Frame assembly-surface.sldasm
267.1 x 258.3 x 99.2 mm
Z Frame2
Steper Motor 34mm (42HD0401-135L)
Z Motor mount5
Z TRACK (MGN9 Length 142.08mm) x 2
L shaped conector x 5
Extruder Gear
washer x 2
Bearing for Filament (U694)
screw
washer m4 .75mm x 2
Extruder Lever (mirrored) 4
Extruder Bracket (mirrored)hacked for no bolden
Extruder Steper Motor (needs reference)2
motor spacer
metal intrnal measurement nut
Small foot2 x 2
Handle
circle foot x 8
metal knurl x 3
Magnet (12x3.79mm) x 6
