lpgn/Carbon-Mini/Extruder with tracks revised/Extruder with tracks2.SLDASM

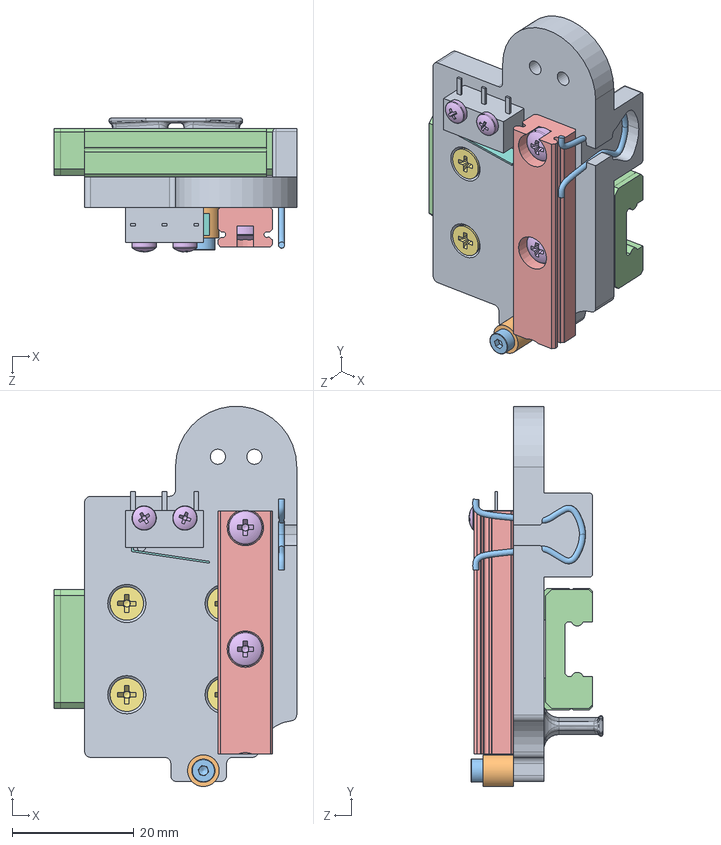
[picture p38: CAD file, 2021-10-29]
Extruder with tracks revised/Extruder with tracks2.SLDASM
39.9 x 62.5 x 22.0 mm
Rail to tracks Extruder's adapter3
hex thin nut chamfered gradeab_iso111 x 2
spring
Rail (MGN-9) (for extruder)
Track Autocalibration
pan head cross recess screw_iso1 x 4
countersunk flat head cross recess screw_iso1 x 4
Endstop Actuator
Mini Enstop Base
Acrilyc 5mm washer
socket head shoulder screw12_iso
