lpgn/Carbon-Mini/Extruder cold end/Modified extruder cold end mirror 2.SLDASM

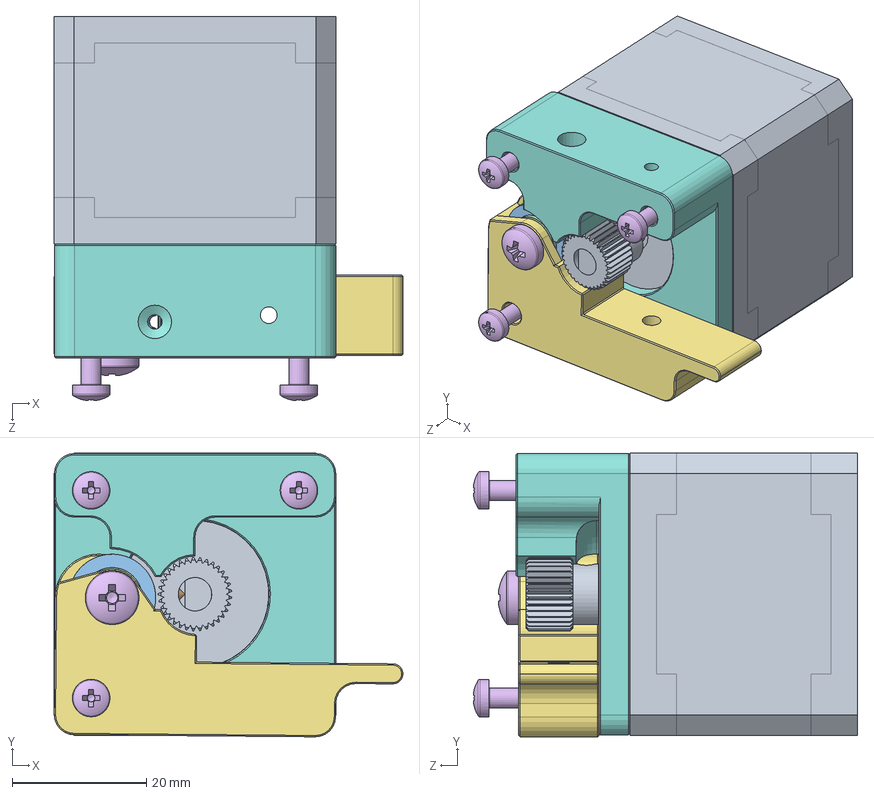
[picture p39: CAD file, 2021-10-29]
Extruder cold end/Modified extruder cold end mirror 2.SLDASM
52.1 x 42.3 x 57.4 mm
Extruder Gear
Tube (bushings)
Bearing for Filament (U694)
washer m4 .75mm x 2
ISO 7046-1 - M3 x 10 - Z --- 10N
ISO 7045 - M3 x 20 - Z --- 20N x 4
Extruder Lever (mirrored)
Extruder Bracket (mirrored)
Extruder Steper Motor (needs reference)
ISO 4027 - M2 x 3-N
