lpgn/Carbon-Mini/Y table support Assembly/Y table support assembly.SLDASM

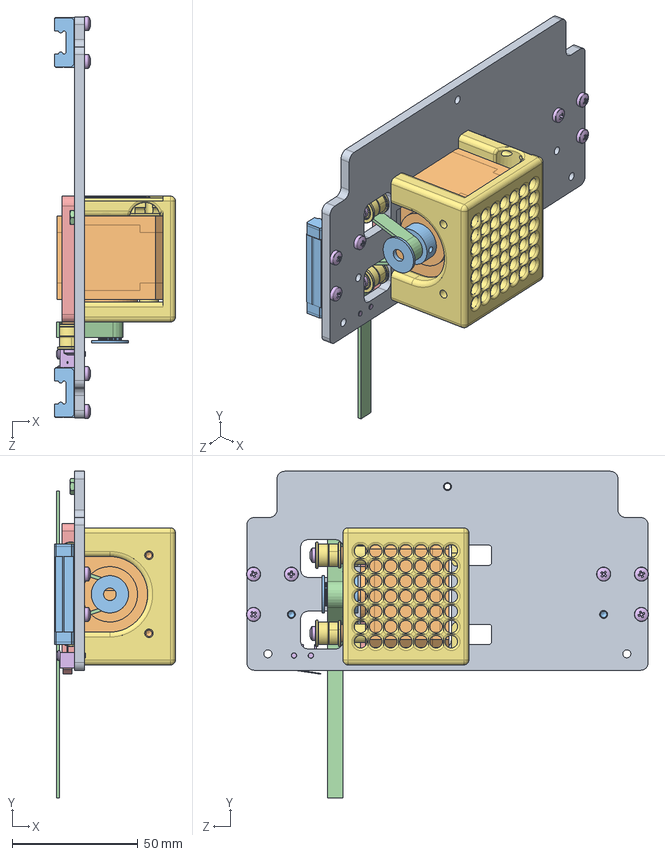
[picture p40: CAD file, 2021-10-29]
Y table support Assembly/Y table support assembly.SLDASM
48.0 x 129.6 x 159.6 mm
Bed Support2
Steper Motor (42HD0401-24, 34mm)
Timing Gear 15 touth MXL
Y Belt (MXL 6mm)
Y motor Bracket
pan head cross recess screw_iso1 x 10
Idler Bearing (F603HZZ) part 1 x 4
Idler Bearing (F603HZZ) part 2 x 4
Idler Bearing (F603HZZ) part 3 x 4
plain washer 10673 type snl_iso1 x 2
Rail MGN9 x 2
hex thin nut chamfered gradeab_iso1
Endstop Actuator (HT-010-1A-250VAC)
Enstop Base (HT-010-1A-250VAC)
motorYsupport^Y table support assembly
