lpgn/Carbon-Mini/Extruder cold end/Modified extruder cold end mirror.SLDASM

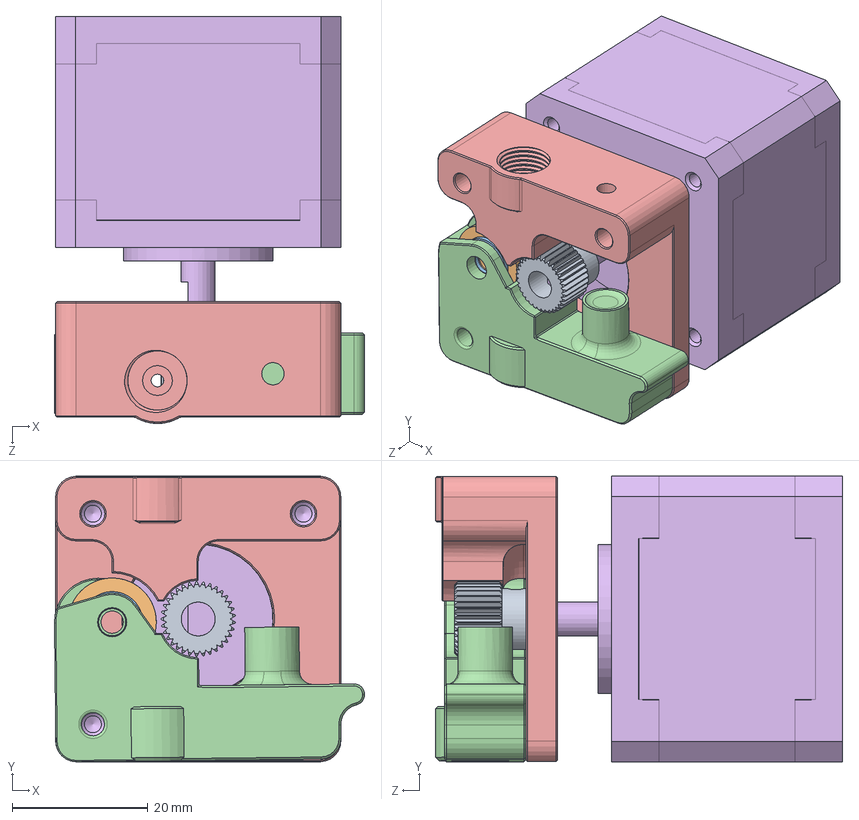
[picture p41: CAD file, 2021-10-29]
Extruder cold end/Modified extruder cold end mirror.SLDASM
45.7 x 42.1 x 59.9 mm
Extruder Gear
Bearing for Filament (U694)
washer m4 .75mm x 2
Extruder Lever (mirrored) 4
Extruder Bracket (mirrored)hacked for no bolden
Extruder Steper Motor (needs reference)2
