lpgn/Carbon-Mini/Frame Assembly/Frame assemblyBKP.sldasm

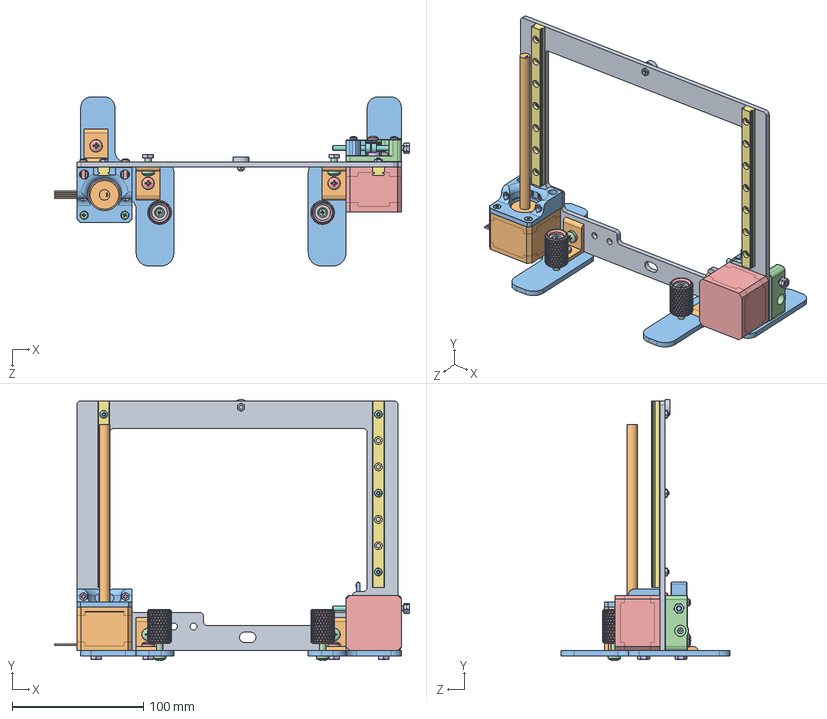
[picture p42: CAD file, 2021-10-29]
Frame Assembly/Frame assemblyBKP.sldasm
270.2 x 198.8 x 128.8 mm
Z Frame
Steper Motor 34mm (42HD0401-135L)
Z Motor mount
ISO 7046-1 - M3 x 12 - Z --- 12N x 7
ISO 7045 - M4 x 12 - Z --- 12N x 6
hex thin nut chamfered gradeab_iso2 x 15
Z TRACK (MGN9 Length 142.08mm) x 2
socket button head screw_iso x 6
Magnet (12x3.79mm) x 3
L shaped conector x 3
Small foot2 x 2
pan head cross recess screw_iso4 x 4
Knurl Adjuster x 2
Extruder Gear
Tube (bushings)
Bearing for Filament (U694)
washer m4 .75mm x 2
countersunk flat head cross recess screw_iso
Extruder Lever (mirrored)
Extruder Bracket (mirrored)
Extruder Steper Motor (needs reference)2
pan head cross recess screw_iso x 3
ISO 4027 - M2 x 3-N
socket head cap screw_iso x 2
hex thin nut chamfered gradeab_iso x 2
