lpgn/Carbon-Mini/Xbridge/X Bridge assembly.SLDASM

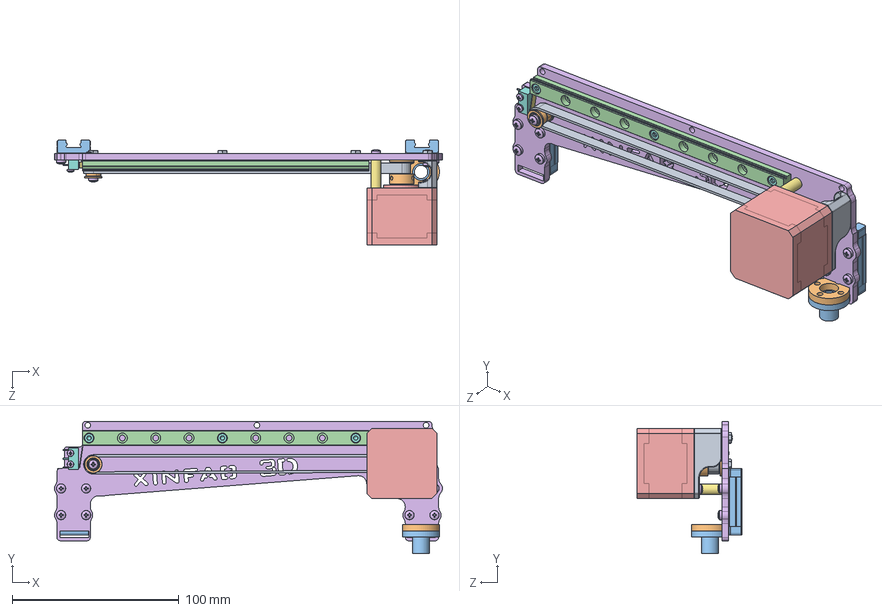
[picture p43: CAD file, 2021-10-29]
Xbridge/X Bridge assembly.SLDASM
232.8 x 79.3 x 62.7 mm
Mini CF X Belt (MXL)
Mini CF Timing Gear 15 touth MXL MP
Mini CF rail mgnr_9_r_600_c__patin_mgn_9_h_zf_c_02 x 2
Mini CF TRACK
Mini CF Steper Motor 34mm
Mini CF X Bridge 4
Mini CF X Bridge spacer x 2
socket head cap screw_iso x 3
Mini CF X Motor atachment
F603HZZ_SOLID_1 x 2
F603HZZ_SOLID_2 x 2
F603HZZ_SOLID_3 x 2
plain washer 10673 type snl_iso
pan head cross recess screw_iso x 16
Mini CFMini CFMini CFMini Endstop Actuator
Mini CFMini CFMini CFMini Enstop Base
hex thin nut chamfered gradeab_iso x 4
Mini CF Z nut atachment
Mini CF Z Treaded Rod Female Special Nut
