lpgn/Carbon-Mini/Y table support Assembly/Mini CF Y table support.SLDASM1.SLDPRT

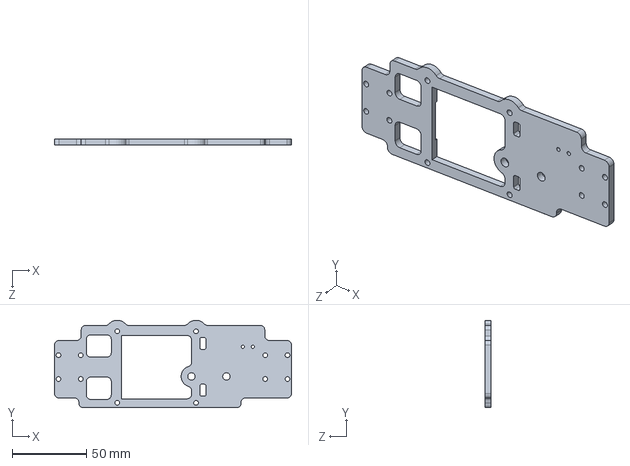
[picture p44: CAD file, 2021-10-29]
Y table support Assembly/Mini CF Y table support.SLDASM1.SLDPRT
159.4 x 58.8 x 4.00 mm
