lpgn/Carbon-Mini/Xbridge/Treaded Rod Female assembly.sldasm

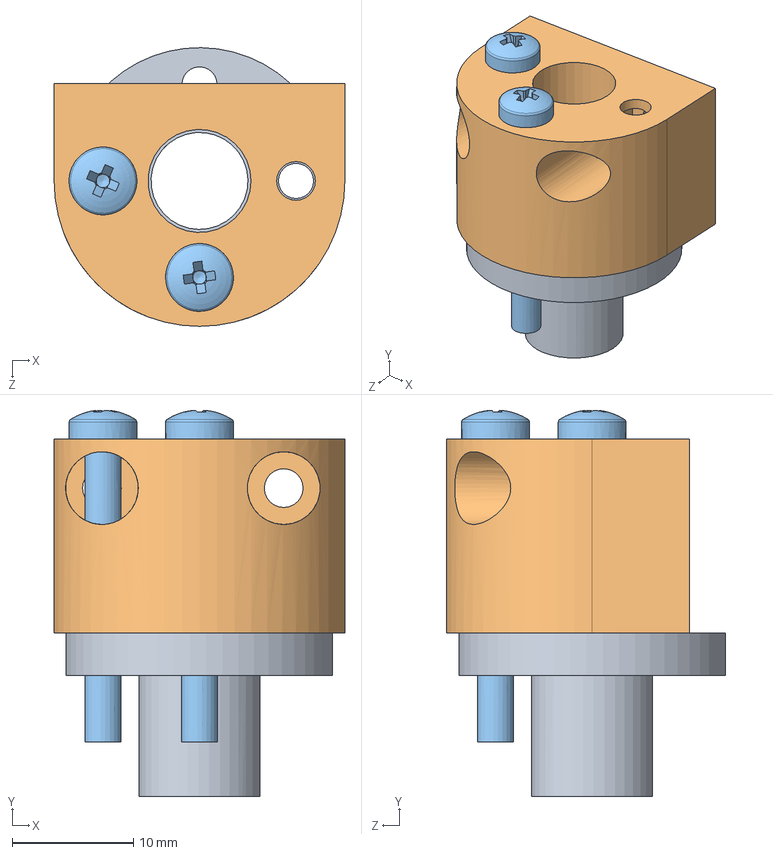
[picture p45: CAD file, 2021-10-29]
Xbridge/Treaded Rod Female assembly.sldasm
24.0 x 31.9 x 23.0 mm
Treaded Rod Female Special Nut
Z nut atachment to X Bridge3
pan head cross recess screw_iso1 x 2
