lpgn/Carbon-Mini/Extruder with tracks revised/Extruder with tracks3c-surface.SLDASM

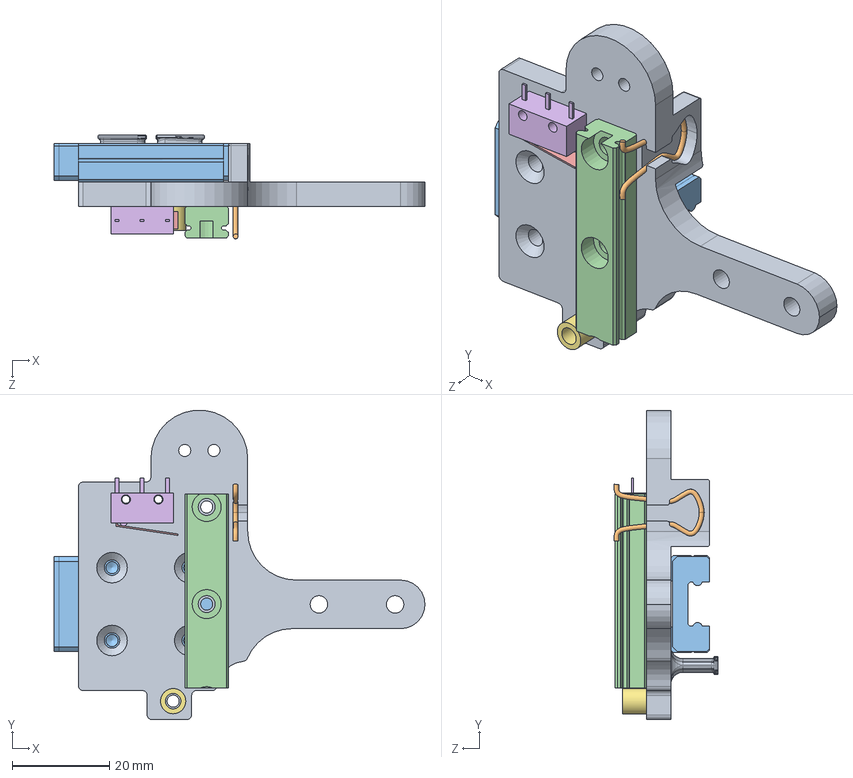
[picture p46: CAD file, 2021-10-29]
Extruder with tracks revised/Extruder with tracks3c-surface.SLDASM
76.4 x 63.7 x 21.4 mm
Rail to tracks Extruder's adapter5
spring
Rail (MGN-9) (for extruder)
Track Autocalibration
Endstop Actuator
Mini Enstop Base
Acrilyc 5mm washer
