lpgn/Carbon-Mini/Frame Assembly/Mini CF Main Frame external3.sldprt

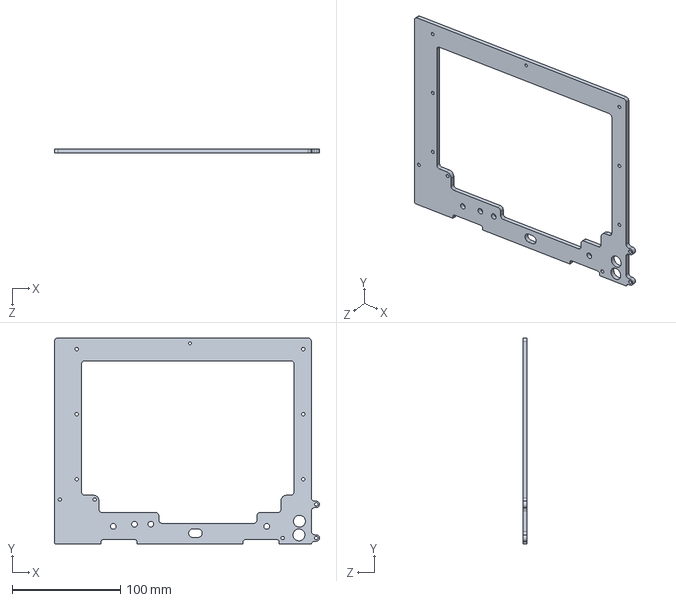
[picture p47: CAD file, 2021-10-29]
Frame Assembly/Mini CF Main Frame external3.sldprt
244.5 x 190.0 x 4.00 mm
