lpgn/Carbon-Mini/Frame Assembly/Frame assembly 2.SLDASM

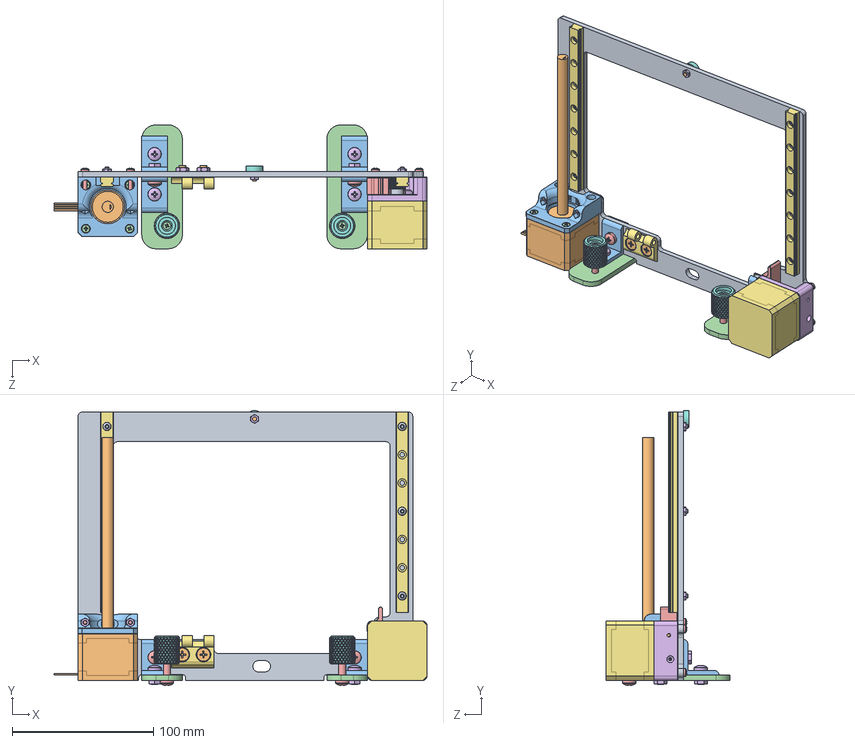
[picture p48: CAD file, 2021-10-29]
Frame Assembly/Frame assembly 2.SLDASM
264.1 x 194.7 x 87.9 mm
Z Frame
Steper Motor 34mm (42HD0401-135L)
Z Motor mount
ISO 7046-1 - M3 x 12 - Z --- 12N x 7
ISO 7045 - M4 x 12 - Z --- 12N x 6
hex thin nut chamfered gradeab_iso x 17
Z TRACK (MGN9 Length 142.08mm) x 2
Magnet (12x3.79mm) x 3
socket button head screw_iso x 6
ISO 7046-1 - M3 x 10 - Z --- 10N x 3
L shaped conector x 4
Small foot x 2
pan head cross recess screw_iso x 4
ISO 7045 - M3 x 20 - Z --- 20N x 4
Hinge 20x20l
Knurl Adjuster x 2
Extruder Gear
Tube (bushings)
Bearing for Filament (U694)
washer m4 .75mm x 2
Extruder Lever (mirrored)
Extruder Bracket (mirrored)
Extruder Steper Motor (needs reference)
ISO 4027 - M2 x 3-N
