lpgn/Carbon-Mini/Extruder with tracks revised/Extruders Rail Assembly.SLDASM

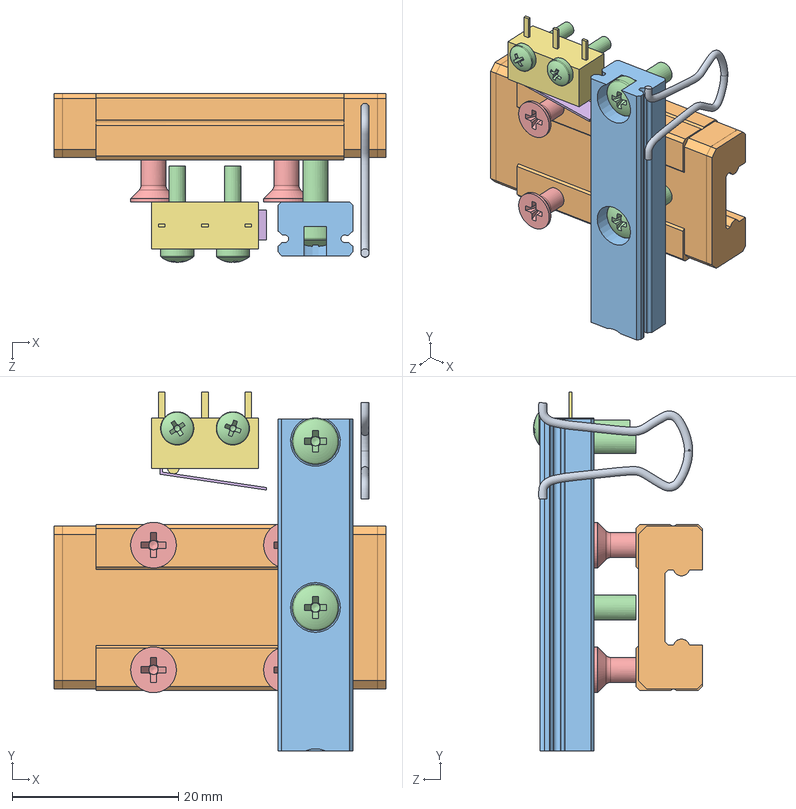
[picture p49: CAD file, 2021-10-29]
Extruder with tracks revised/Extruders Rail Assembly.SLDASM
39.9 x 43.2 x 20.3 mm
spring
Rail (MGN-9) (for extruder)
Track Autocalibration
pan head cross recess screw_iso1 x 4
countersunk flat head cross recess screw_iso1 x 4
Endstop Actuator
Mini Enstop Base
