lpgn/Carbon-Mini/Frame Assembly/Mini CF Frame assembly3.sldasm

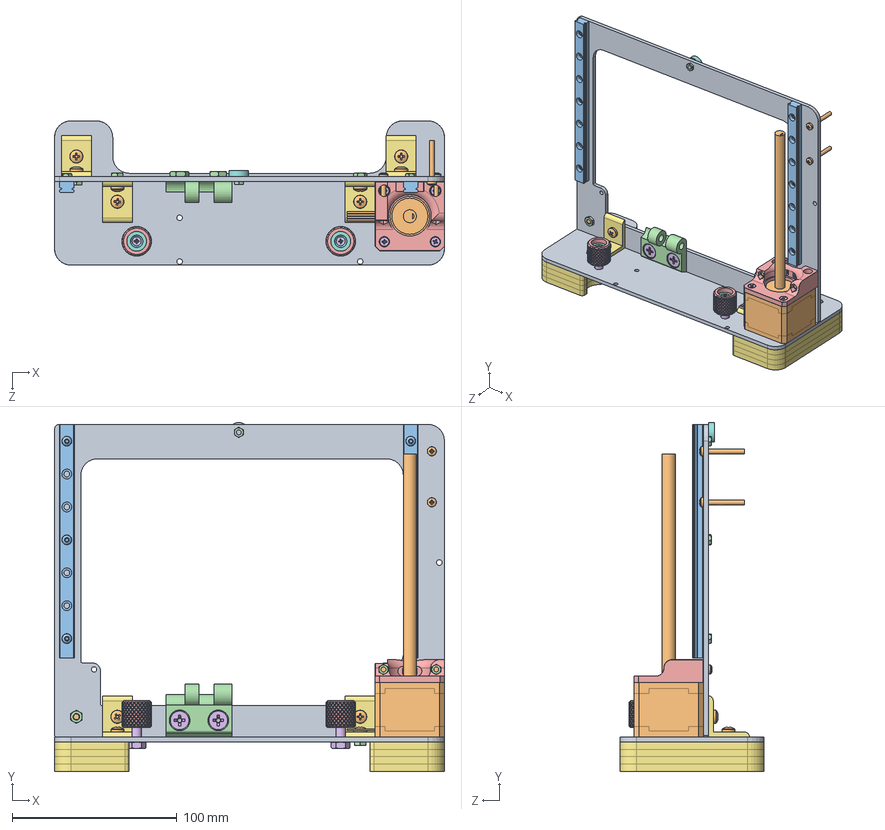
[picture p50: CAD file, 2021-10-29]
Frame Assembly/Mini CF Frame assembly3.sldasm
237.0 x 212.1 x 87.7 mm
Mini CF Main Frame external3
Mini CF200x300CF3DWP1 Steper Motor 34mm
Mini CF200x300CF3DWP1 Z TRACK x 2
Mini CFMini CF200x300CF3DWP1TF4 Hinge
CF Mini Z Motor mount
countersunk flat head cross recess screw_iso x 9
L shaped conector x 4
Mini CF Magnet 12X3.79mm x 3
FOOT
pan head cross recess screw_iso x 12
socket button head screw_iso x 6
hex thin nut chamfered gradeab_iso x 20
Adjustable table mount2-MBP x 2
hex screw gradeab_iso x 2
FOOTEXTRA x 4
