lpgn/Carbon-Mini/Xbridge/Assem2.sldasm

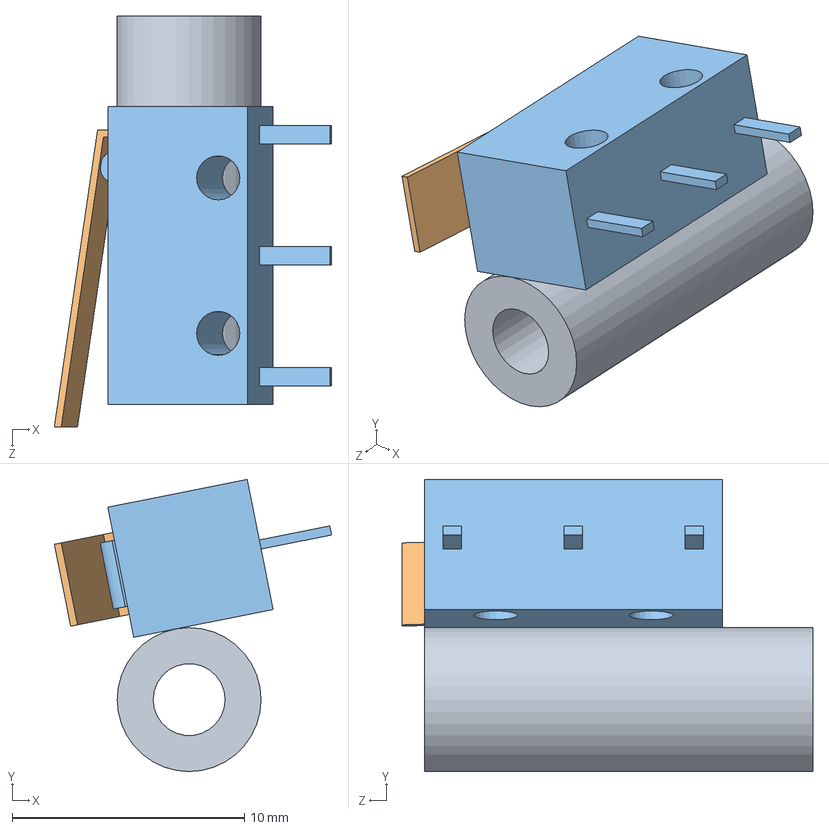
[picture p51: CAD file, 2021-10-29]
Xbridge/Assem2.sldasm
12.0 x 12.6 x 17.7 mm
Mini CF X Bridge spacer FOR ENDSTOP
Mini CFMini CFMini CFMini Endstop Actuator
Mini CFMini CFMini CFMini Enstop Base
