lpgn/Carbon-Mini/Xbridge/Bearing assembly-surface.sldasm

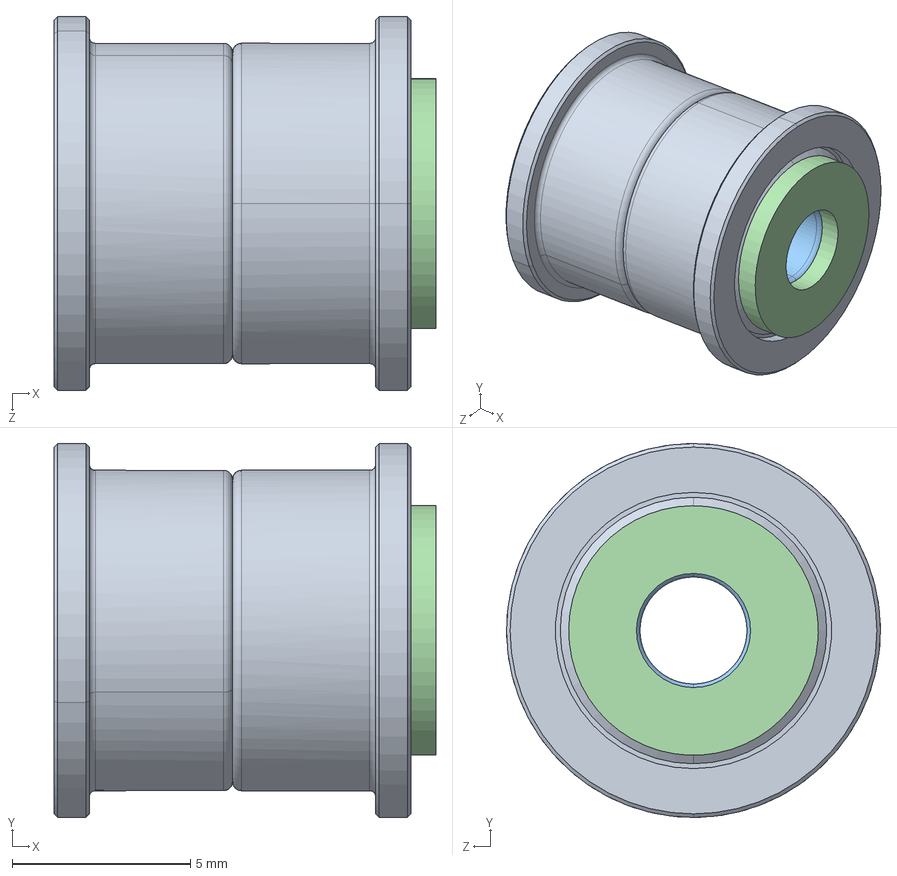
[picture p52: CAD file, 2021-10-29]
Xbridge/Bearing assembly-surface.sldasm
10.7 x 10.5 x 10.5 mm
F603HZZ_SOLID_1 x 2
F603HZZ_SOLID_2 x 2
F603HZZ_SOLID_3 x 2
plain washer 10673 type snl_iso
