lpgn/Carbon-Mini/Extruder with tracks revised/Extruder with tracks3c.SLDASM

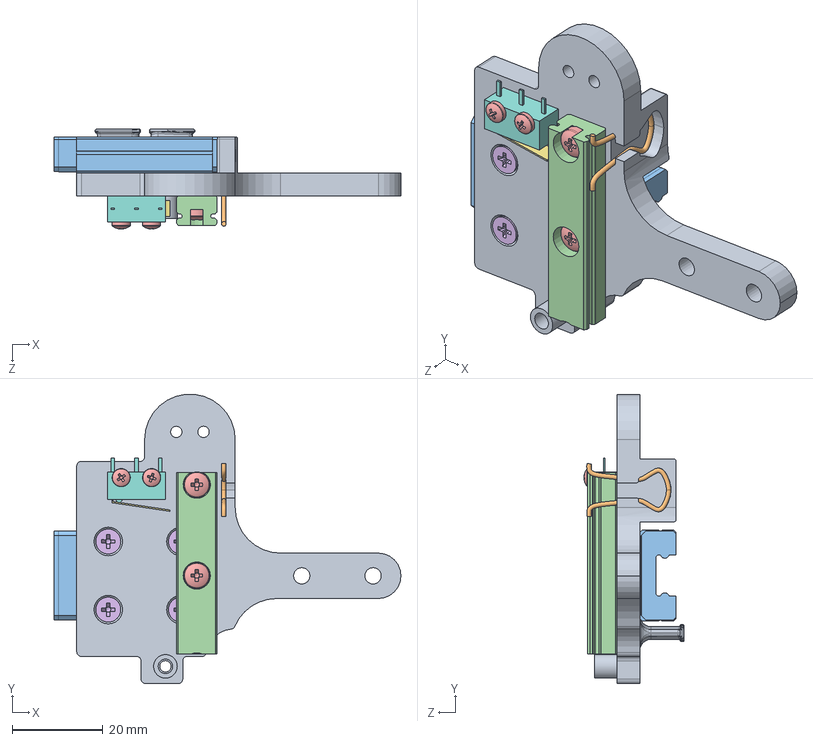
[picture p53: CAD file, 2021-10-29]
Extruder with tracks revised/Extruder with tracks3c.SLDASM
76.4 x 63.7 x 22.0 mm
Rail to tracks Extruder's adapter5
spring
Rail (MGN-9) (for extruder)
Track Autocalibration
pan head cross recess screw_iso1 x 4
countersunk flat head cross recess screw_iso1 x 4
Endstop Actuator
Mini Enstop Base
Acrilyc 5mm washer
