lpgn/Carbon-Mini/Frame Assembly/KNURL ADJUSTER.sldasm

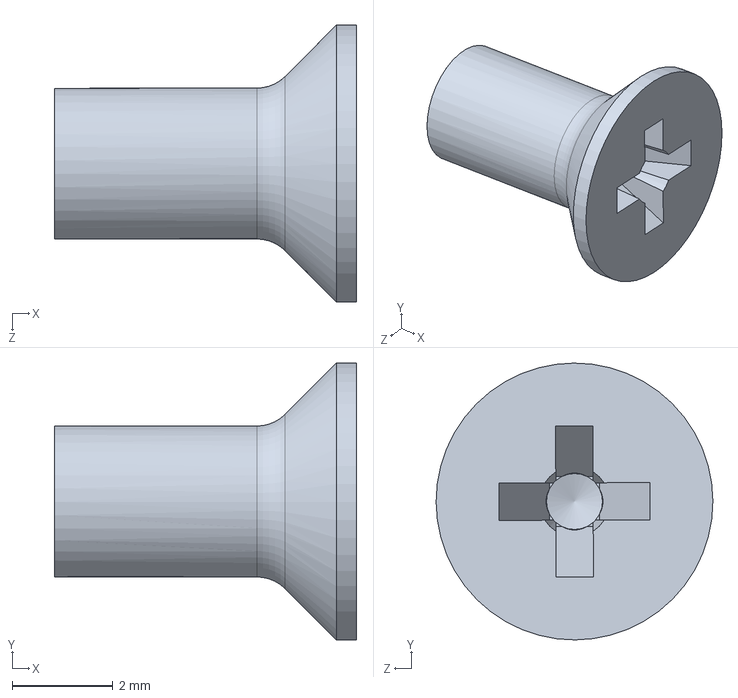
[picture p54: CAD file, 2021-10-29]
Frame Assembly/KNURL ADJUSTER.sldasm
6.00 x 5.50 x 5.50 mm
