lpgn/Carbon-Mini/Xbridge/Bearing assembly.sldasm

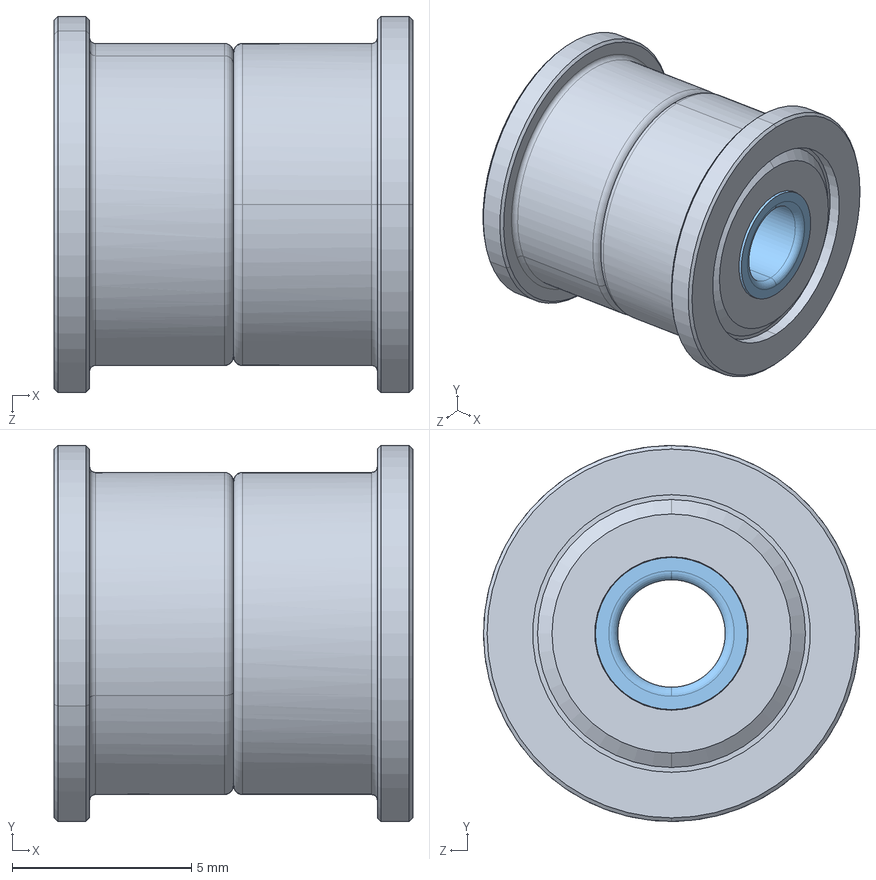
[picture p55: CAD file, 2021-10-29]
Xbridge/Bearing assembly.sldasm
10.0 x 10.5 x 10.5 mm
F603HZZ_SOLID_1 x 2
F603HZZ_SOLID_2 x 2
F603HZZ_SOLID_3 x 2
