lpgn/Carbon-Mini/Xbridge/X Bridge assembly mirror.SLDASM

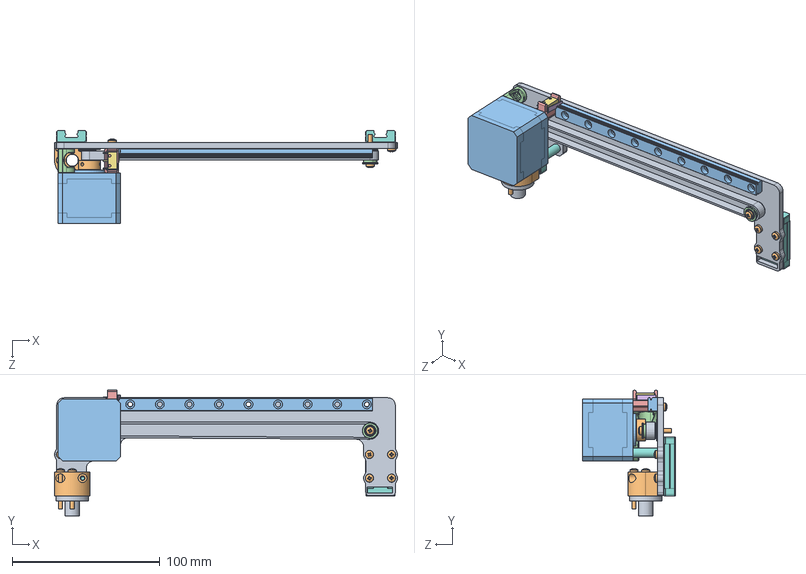
[picture p56: CAD file, 2021-10-29]
Xbridge/X Bridge assembly mirror.SLDASM
231.9 x 84.9 x 62.7 mm
X Bridge 4
Timing Gear 15 touth MXL MP
Steper Motor 34mm
X Motor atachment mirror3
X Bridge spacer for endstop
Endstop Actuator 1
Enstop Base 1
X Bridge spacer
X Belt (MXL)
pan head cross recess screw_iso1 x 11
Track MGN9 172mm
F603HZZ_SOLID_1 x 2
F603HZZ_SOLID_2 x 2
F603HZZ_SOLID_3 x 2
plain washer 10673 type snl_iso1
Rail (MGN-9) (for extruder) x 2
Treaded Rod Female Special Nut
Z nut atachment to X Bridge3
