lpgn/Carbon-Mini/Frame Assembly/Pés.sldasm

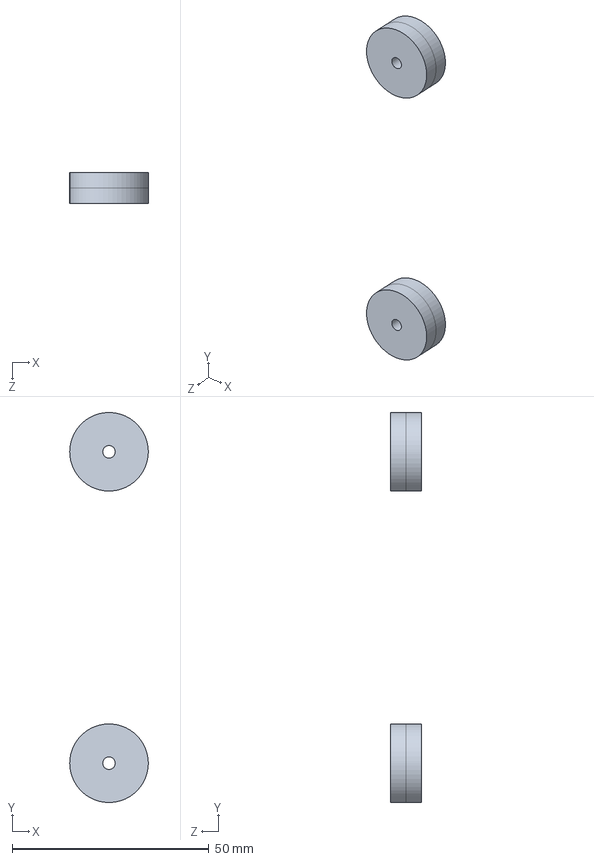
[picture p57: CAD file, 2021-10-29]
Frame Assembly/Pés.sldasm
20.0 x 99.2 x 8.00 mm
circle foot x 4
