lpgn/Carbon-Mini/Extruder with tracks revised/Extruder with tracks.SLDASM

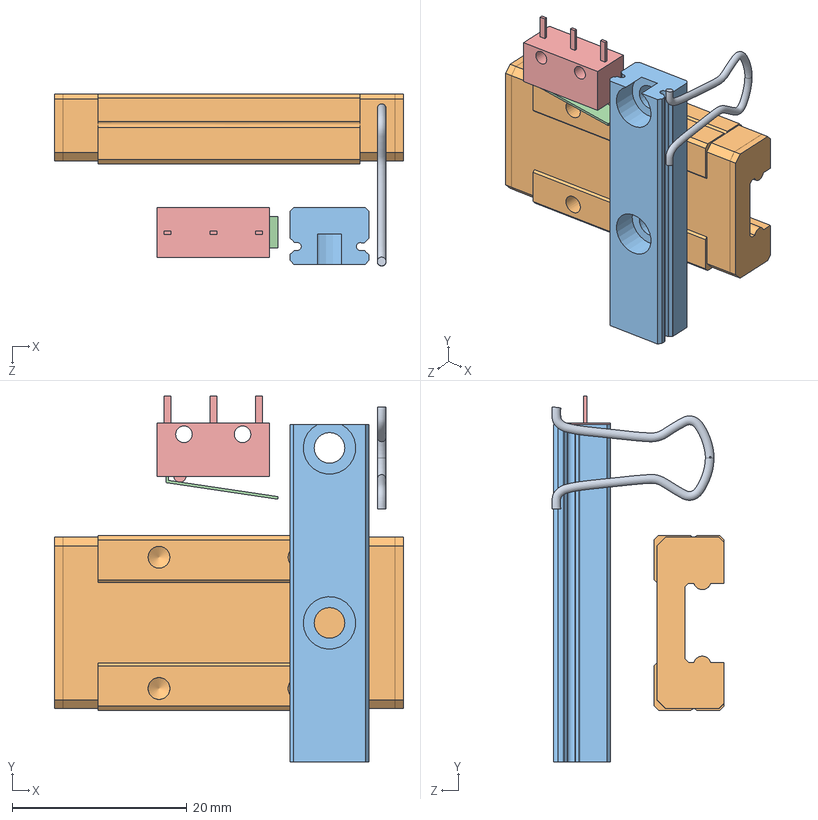
[picture p58: CAD file, 2021-10-29]
Extruder with tracks revised/Extruder with tracks.SLDASM
39.9 x 41.8 x 19.7 mm
spring
Rail (MGN-9) (for extruder)
Track Autocalibration
Endstop Actuator
Mini Enstop Base
