lpgn/Carbon-Mini/Extruder with tracks revised/BBE3D Hotend.SLDASM

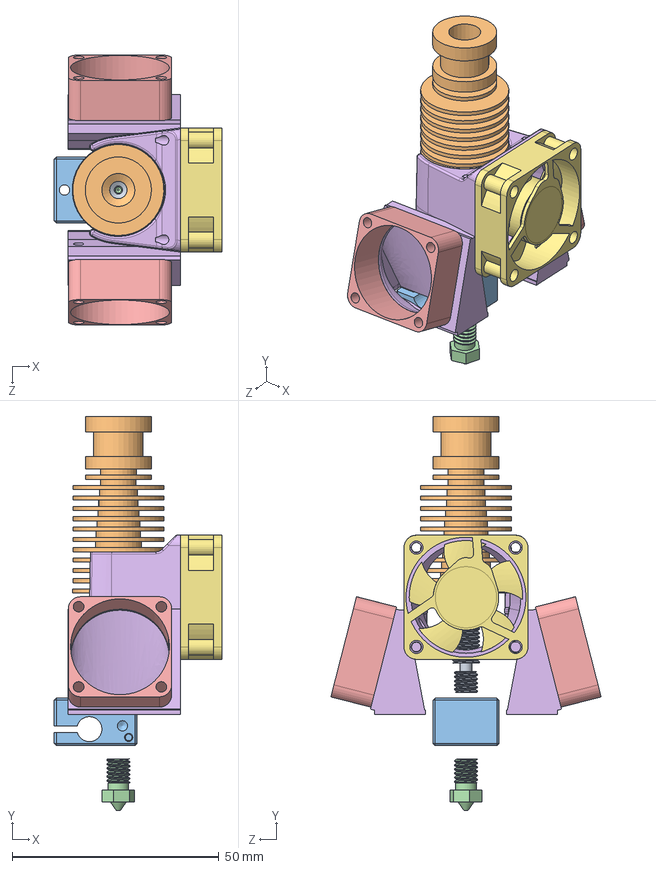
[picture p59: CAD file, 2021-10-29]
Extruder with tracks revised/BBE3D Hotend.SLDASM
40.5 x 95.2 x 65.3 mm
BBE3D Hotend Breaker
BBE3D Hotend heatsink
BBE3D Hotend block
BBE3D Hotend nozzle
Small Fan Mockup x 2
e3d fan duct hacked 3
FAN - Heat Sink
