lpgn/Carbon-Mini/Y table support Assembly/SLEVE AND MAGNET.SLDASM

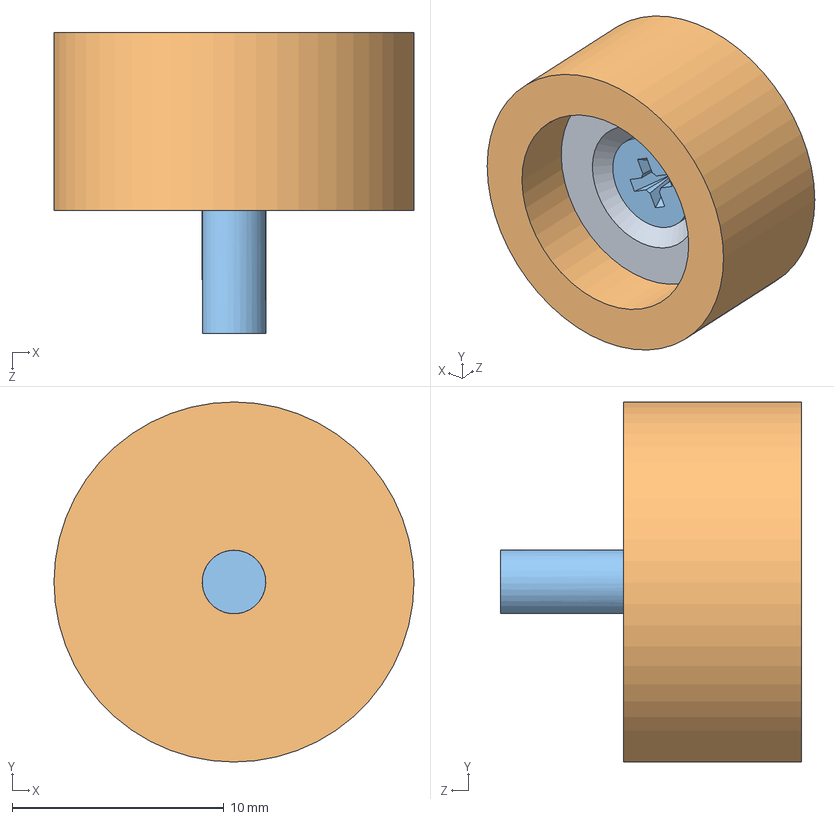
[picture p60: CAD file, 2021-10-29]
Y table support Assembly/SLEVE AND MAGNET.SLDASM
17.0 x 17.0 x 14.2 mm
Magnet (12x3.79mm)
sleve
ISO 7046-1 - M3 x 10 - Z --- 10N
