lpgn/Carbon-Mini/Extruder with tracks revised/hOTEND ASSEMBLY-surface.SLDASM

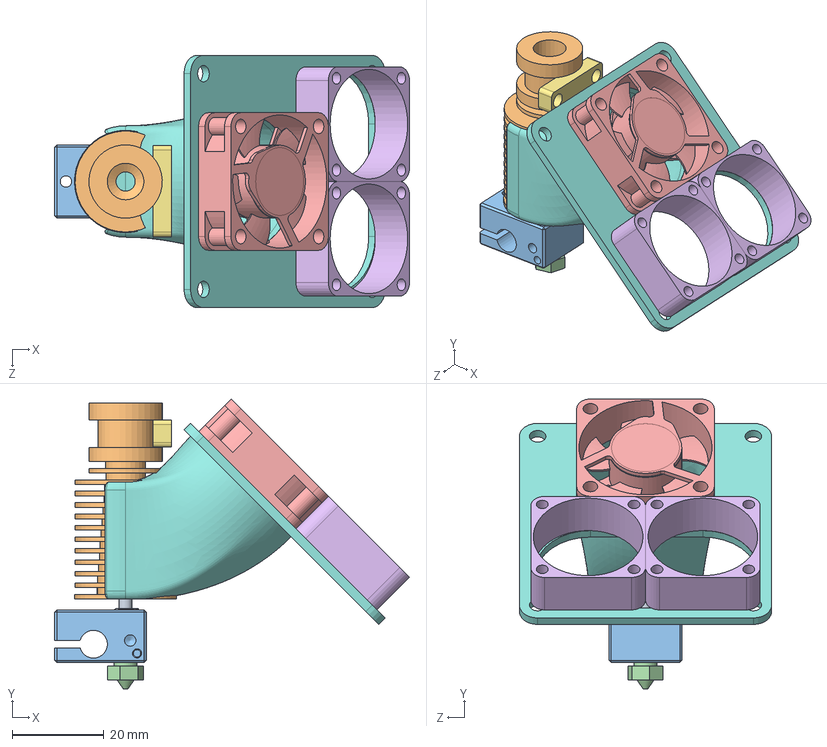
[picture p61: CAD file, 2021-10-29]
Extruder with tracks revised/hOTEND ASSEMBLY-surface.SLDASM
77.4 x 63.2 x 55.0 mm
Heat Breaker (Hotend)
Heatsink (Hotend)
Heat Block (hotend)
Nozzle (0.4) (Hotend)
FAN for Heat Sink (Hotend)
Small Fan Mockup (hotend) x 2
Hotend bracket
officialE3DV6fanduct
