lpgn/Carbon-Mini/Extruder with tracks revised/hOTEND ASSEMBLY.SLDASM

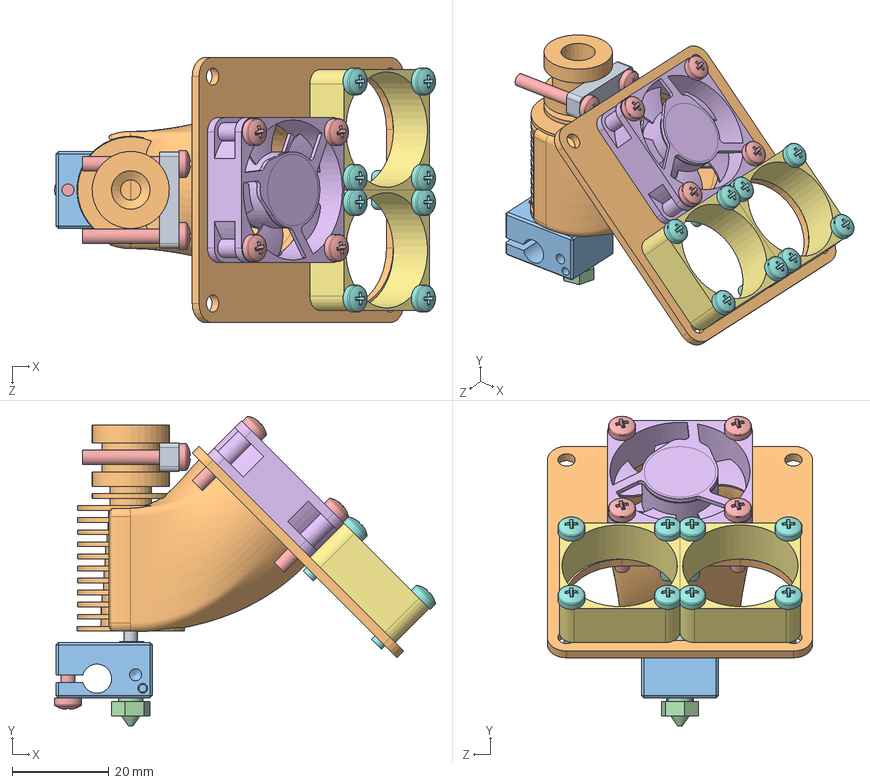
[picture p62: CAD file, 2021-10-29]
Extruder with tracks revised/hOTEND ASSEMBLY.SLDASM
78.9 x 64.1 x 55.0 mm
Heat Breaker (Hotend)
Heatsink (Hotend)
Heat Block (hotend)
Nozzle (0.4) (Hotend)
pan head cross recess screw_iso1 x 7
FAN for Heat Sink (Hotend)
Small Fan Mockup (hotend) x 2
pan cross head_am1 x 8
Hotend bracket
officialE3DV6fanduct
