lpgn/Carbon-Mini/Bed Assembly/Glassbed2.SLDPRT

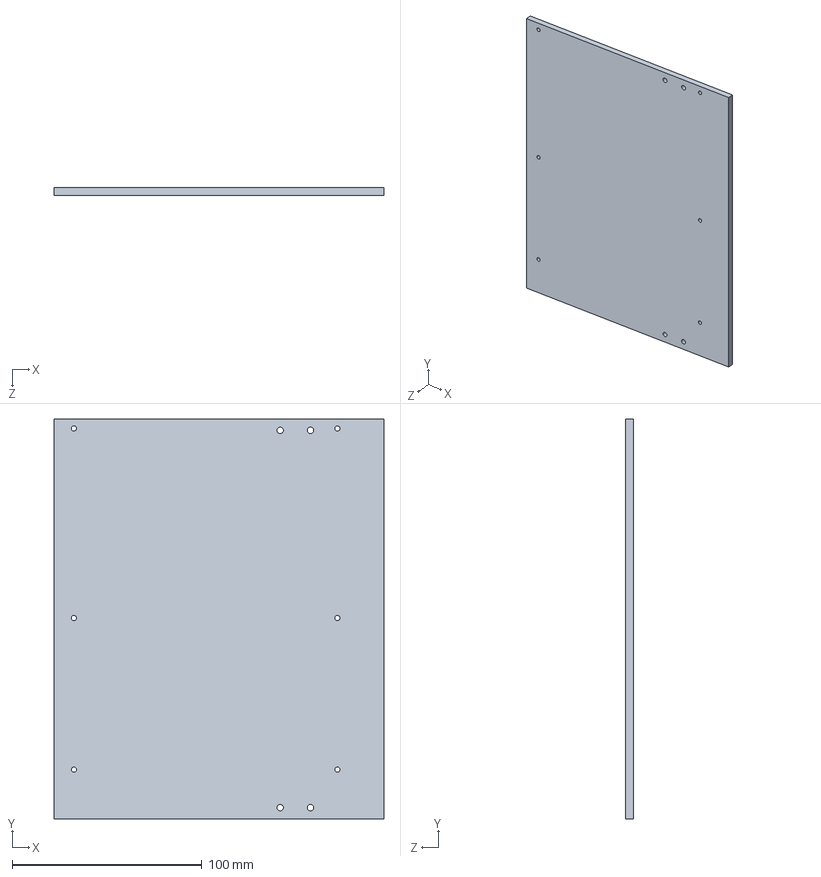
[picture p63: CAD file, 2021-10-29]
Bed Assembly/Glassbed2.SLDPRT
174.1 x 211.0 x 4.40 mm
