lpgn/Carbon-Mini/Extruder with tracks revised/BBE3D Hotend Breaker.SLDPRT

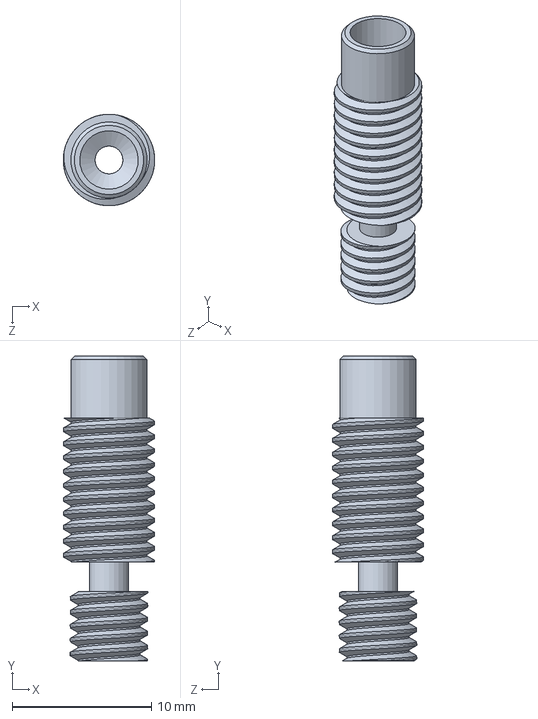
[picture p64: CAD file, 2021-10-29]
Extruder with tracks revised/BBE3D Hotend Breaker.SLDPRT
6.57 x 21.9 x 6.57 mm
