lpgn/Carbon-Mini/Frame Assembly/FOOTEXTRA.SLDPRT

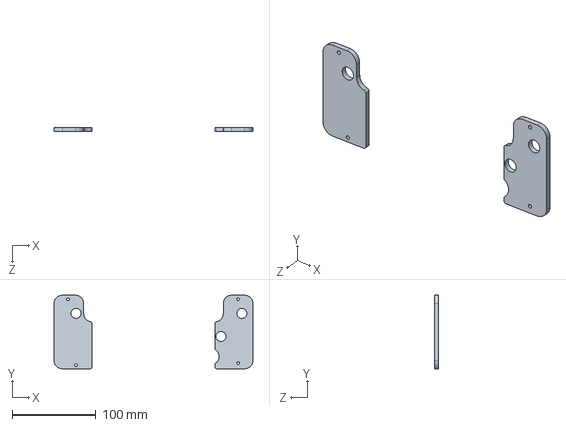
[picture p65: CAD file, 2021-10-29]
Frame Assembly/FOOTEXTRA.SLDPRT
237.0 x 87.7 x 4.50 mm
