lpgn/Carbon-Mini/Frame Assembly/Prescision tool/metal knurl.SLDPRT

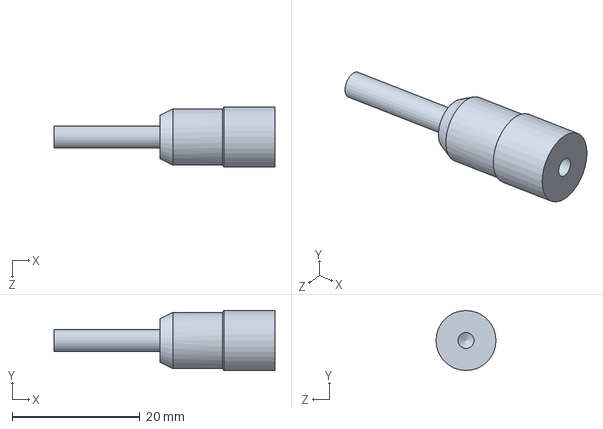
[picture p66: CAD file, 2021-10-29]
Frame Assembly/Prescision tool/metal knurl.SLDPRT
34.6 x 9.40 x 9.40 mm
