lpgn/Carbon-Mini/officialE3DV6fanduct2.STEP

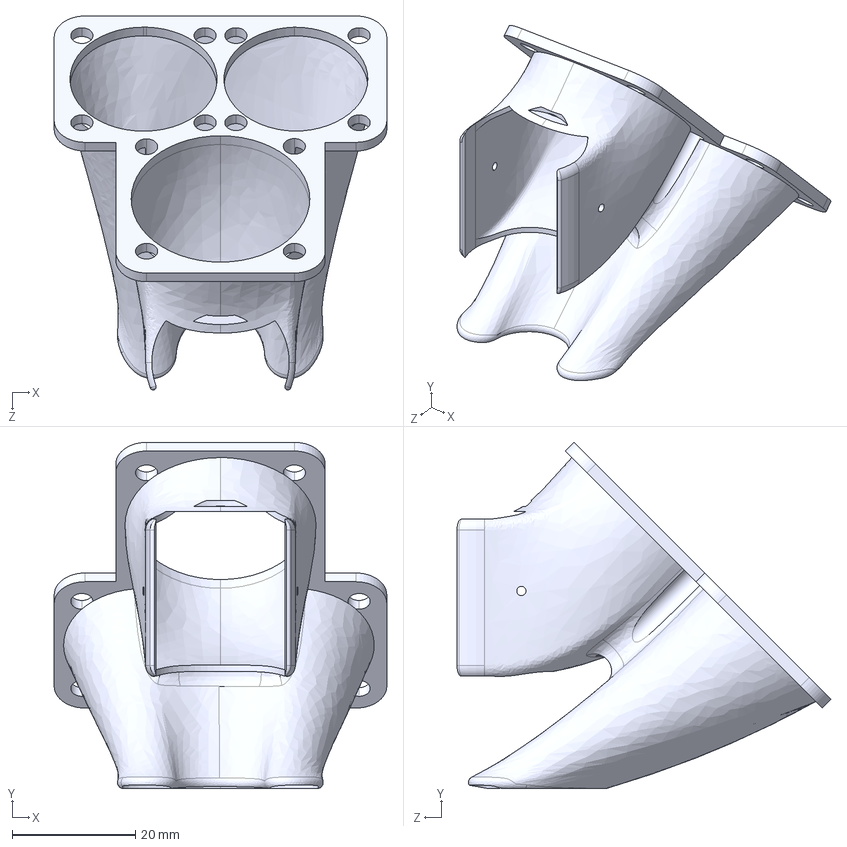
[picture p67: CAD file, 2021-10-29]
officialE3DV6fanduct2.STEP
54.0 x 56.2 x 60.7 mm
