lpgn/Carbon-Mini/STL/Gcode/allparts.amf

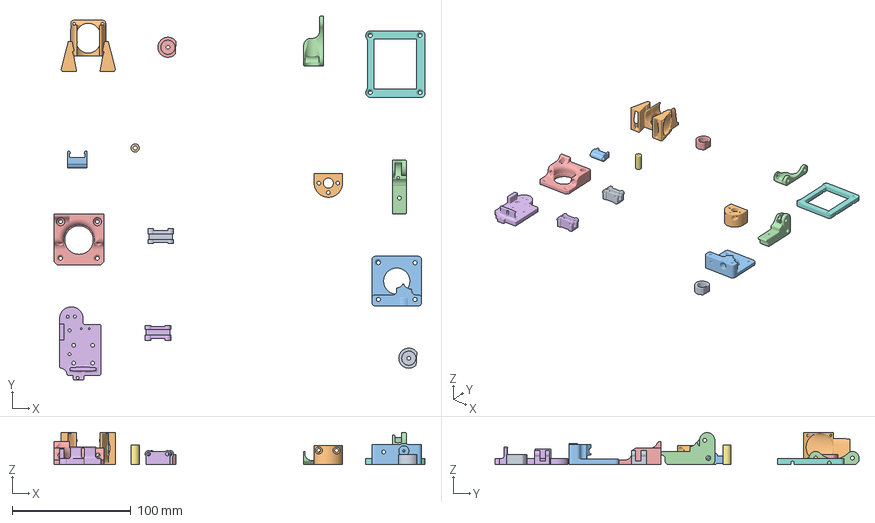
[picture p68: CAD file, 2021-10-29]
STL/Gcode/allparts.amf
312.9 x 307.1 x 27.2 mm
