lpgn/Carbon-Mini/STL/panel case printed2.STL

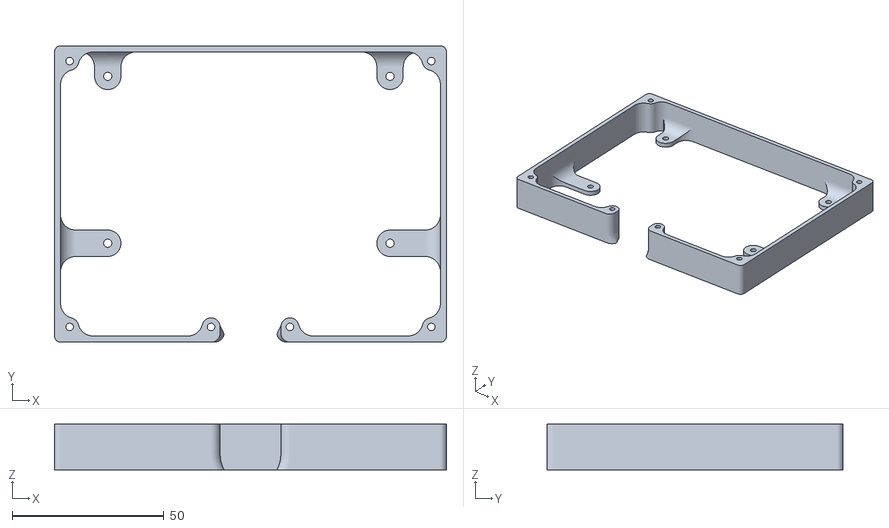
[picture p69: CAD file, 2021-10-29]
STL/panel case printed2.STL
129.2 x 97.6 x 15.0
