lpgn/Carbon-Mini/STP files/Small footA.STEP

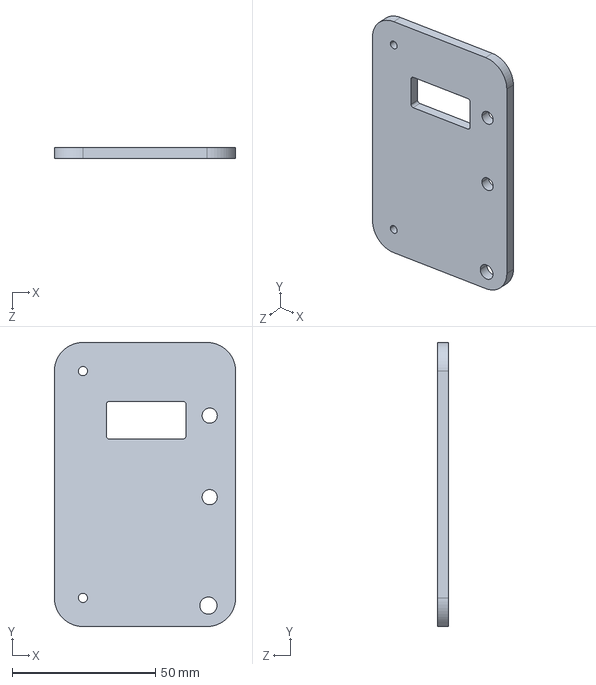
[picture p70: CAD file, 2021-10-29]
STP files/Small footA.STEP
63.4 x 99.2 x 4.00 mm
