lpgn/Carbon-Mini/TO LASER CUT/back cover.DXF

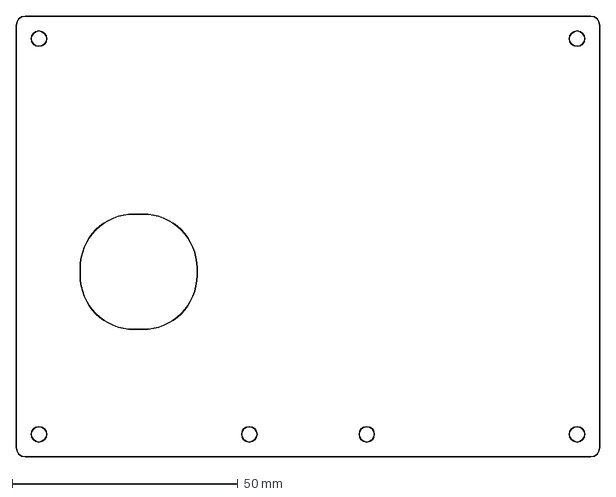
[picture p71: CAD file, 2021-10-29]
TO LASER CUT/back cover.DXF
129.2 x 97.6 mm
