lpgn/Carbon-Mini/Xbridge/X Bridge 4.SLDPRT

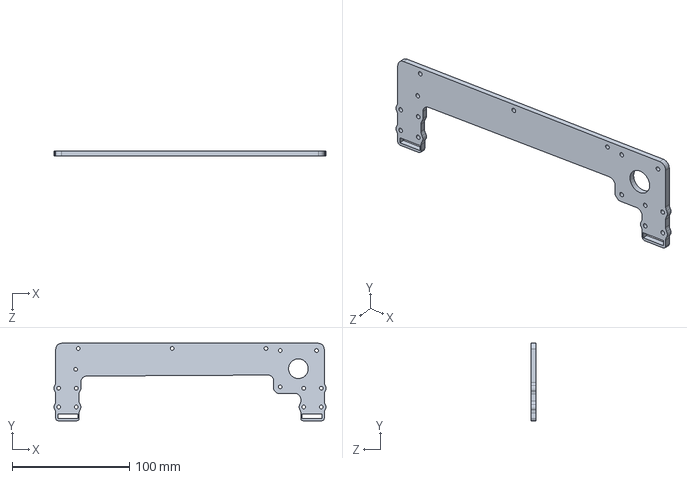
[picture p72: CAD file, 2021-10-29]
Xbridge/X Bridge 4.SLDPRT
231.9 x 66.2 x 4.00 mm
