lpgn/Carbon-Mini/Bed Assembly/BED SPACER.SLDPRT

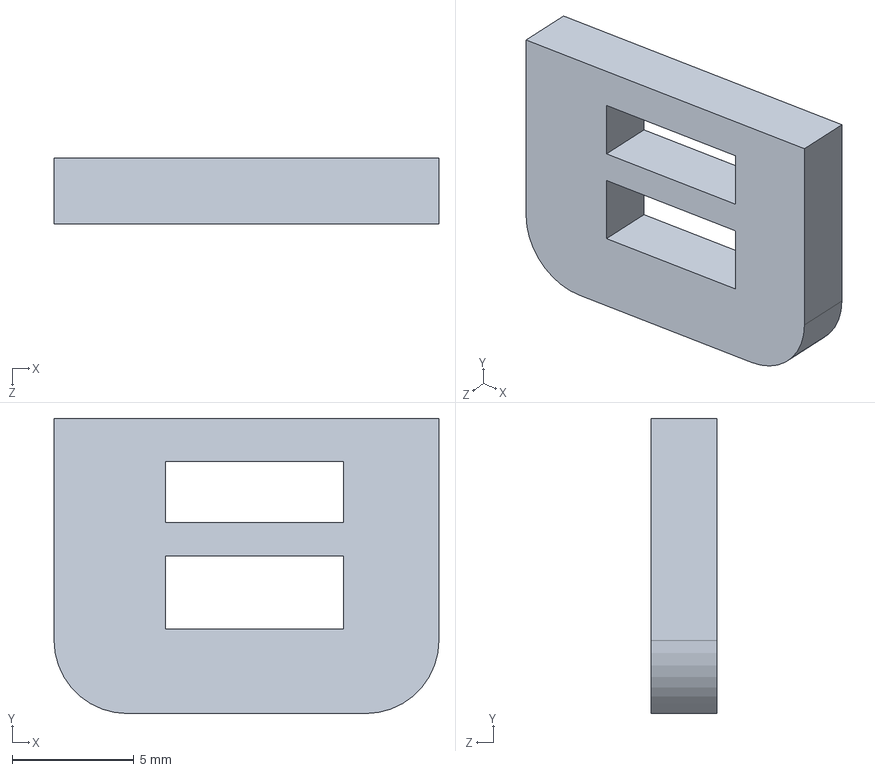
[picture p73: CAD file, 2021-10-29]
Bed Assembly/BED SPACER.SLDPRT
15.8 x 12.1 x 2.72 mm
