lpgn/Carbon-Mini/Extruder cold end/gear.SLDPRT

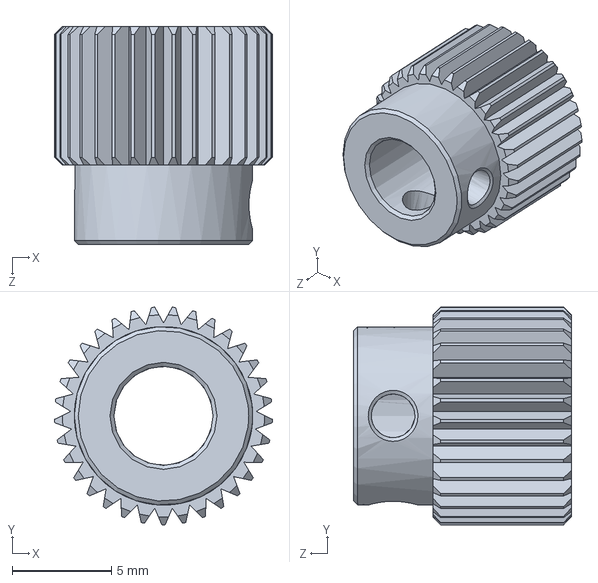
[picture p74: CAD file, 2021-10-29]
Extruder cold end/gear.SLDPRT
11.0 x 11.0 x 11.0 mm
