lpgn/Carbon-Mini/Extruder with tracks revised/FAN for Heat Sink.SLDPRT

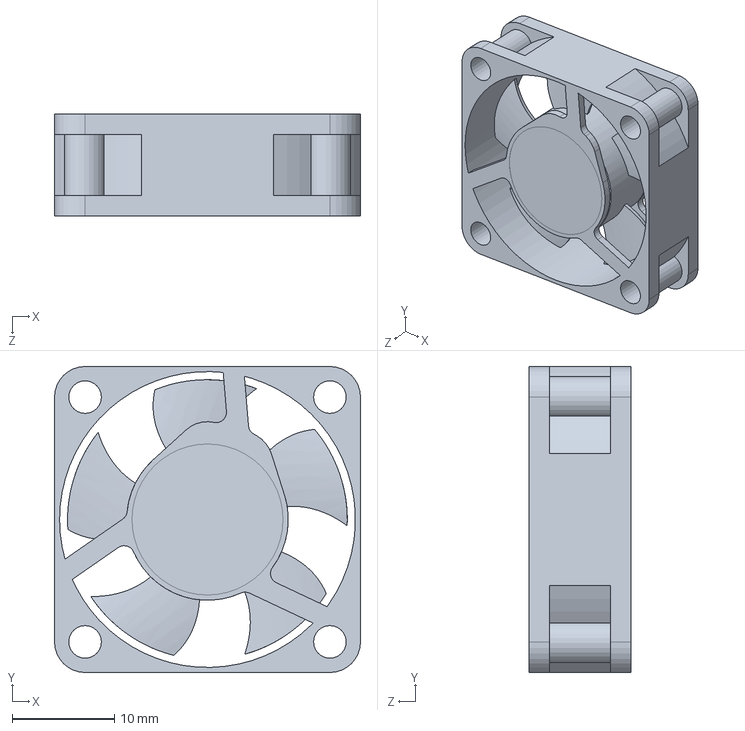
[picture p75: CAD file, 2021-10-29]
Extruder with tracks revised/FAN for Heat Sink.SLDPRT
30.0 x 30.0 x 10.0 mm
