lpgn/Carbon-Mini/Frame Assembly/Z Motor mount4.SLDPRT

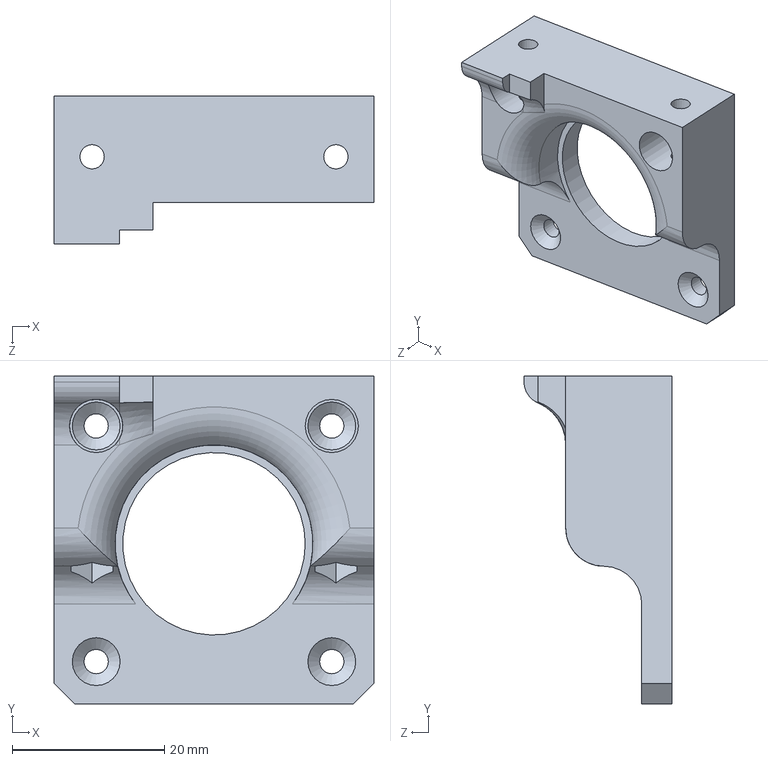
[picture p76: CAD file, 2021-10-29]
Frame Assembly/Z Motor mount4.SLDPRT
42.1 x 43.1 x 19.5 mm
