lpgn/Carbon-Mini/Panel/Panel 2/lcd-surface.SLDPRT

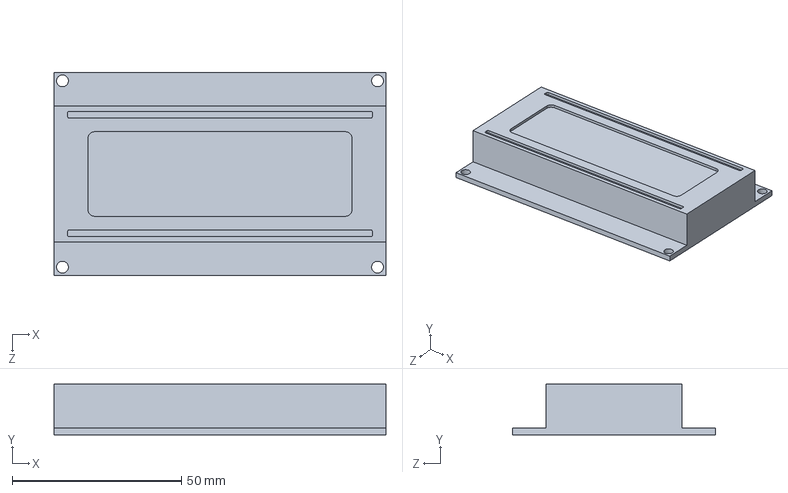
[picture p77: CAD file, 2021-10-29]
Panel/Panel 2/lcd-surface.SLDPRT
98.0 x 15.0 x 60.0 mm
