lpgn/Carbon-Mini/STL/panel case printed.STL

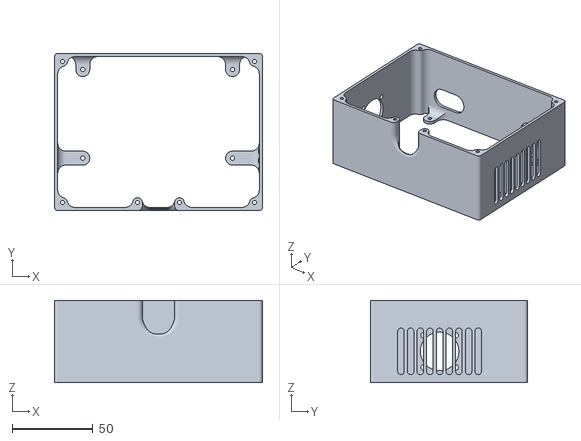
[picture p78: CAD file, 2021-10-29]
STL/panel case printed.STL
129.2 x 97.6 x 51.0
