lpgn/Carbon-Mini/STP files/Bed Support2.STEP

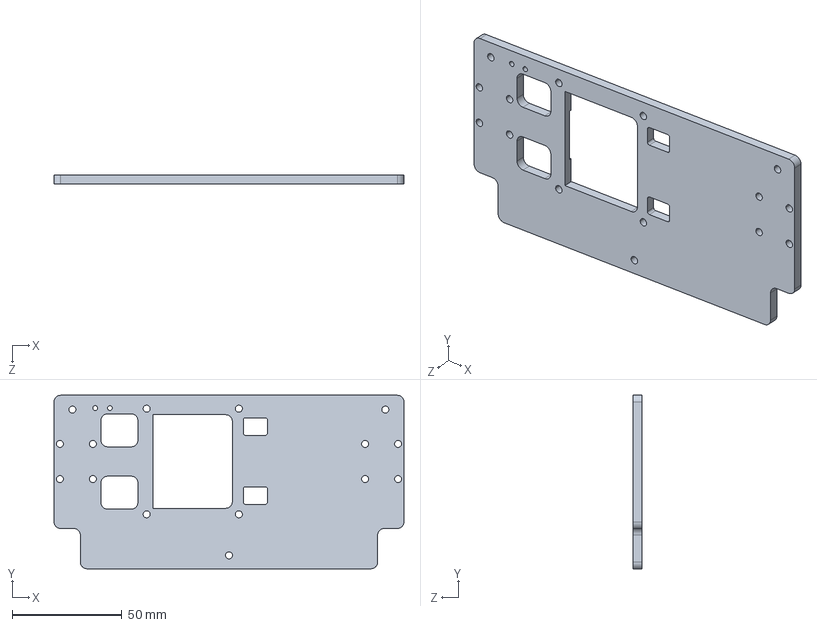
[picture p79: CAD file, 2021-10-29]
STP files/Bed Support2.STEP
159.4 x 79.0 x 4.00 mm
