lpgn/Carbon-Mini/TO LASER CUT/P0ANEL.DXF

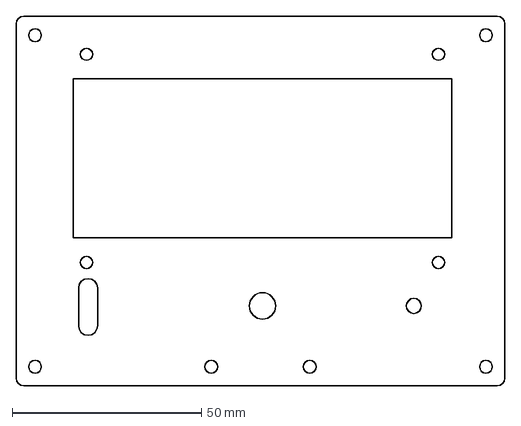
[picture p80: CAD file, 2021-10-29]
TO LASER CUT/P0ANEL.DXF
129.2 x 97.6 mm
