lpgn/Carbon-Mini/Xbridge/X Motor atachment mirror2.SLDPRT

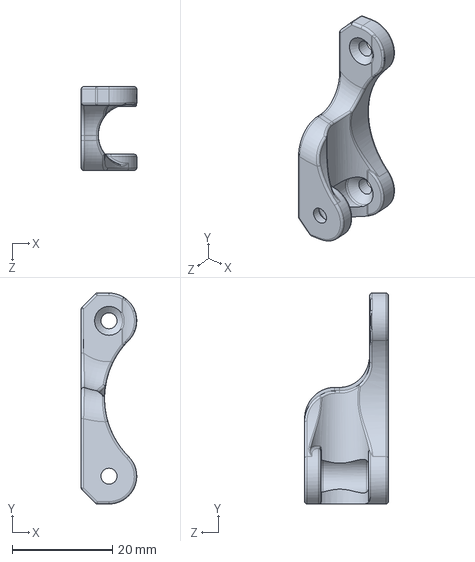
[picture p81: CAD file, 2021-10-29]
Xbridge/X Motor atachment mirror2.SLDPRT
11.1 x 42.1 x 16.7 mm
