lpgn/Carbon-Mini/Extruder cold end/motor_bracket mirror.SLDPRT

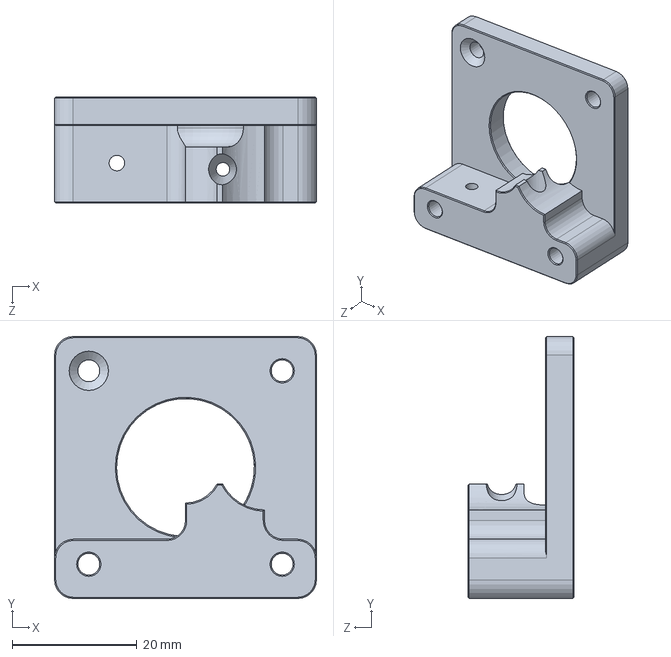
[picture p82: CAD file, 2021-10-29]
Extruder cold end/motor_bracket mirror.SLDPRT
42.0 x 42.0 x 17.0 mm
