lpgn/Carbon-Mini/Extruder with tracks revised/Fan duct hacked (Hotend).SLDPRT

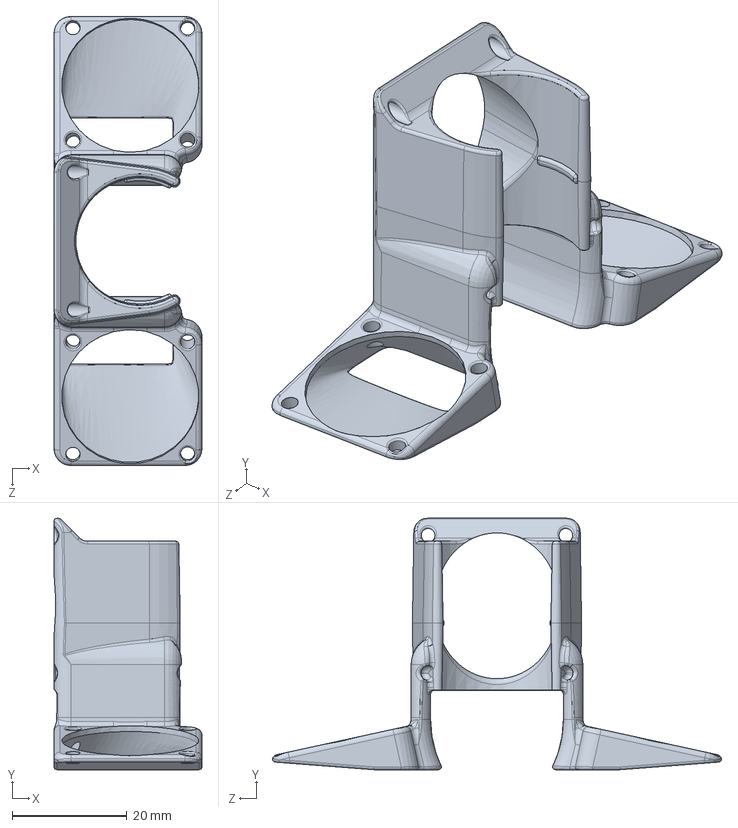
[picture p83: CAD file, 2021-10-29]
Extruder with tracks revised/Fan duct hacked (Hotend).SLDPRT
25.8 x 43.8 x 78.3 mm
