lpgn/Carbon-Mini/Frame Assembly/Z Motor mount.SLDPRT

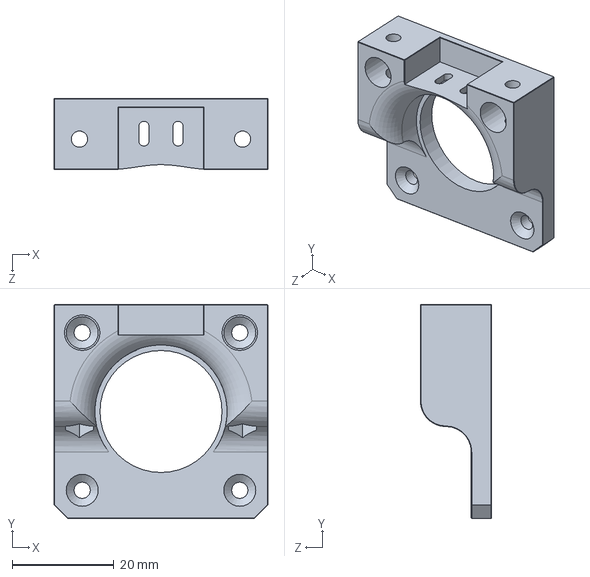
[picture p84: CAD file, 2021-10-29]
Frame Assembly/Z Motor mount.SLDPRT
42.1 x 42.1 x 14.0 mm
