lpgn/Carbon-Mini/Panel/Panel 2/Panel back.SLDPRT

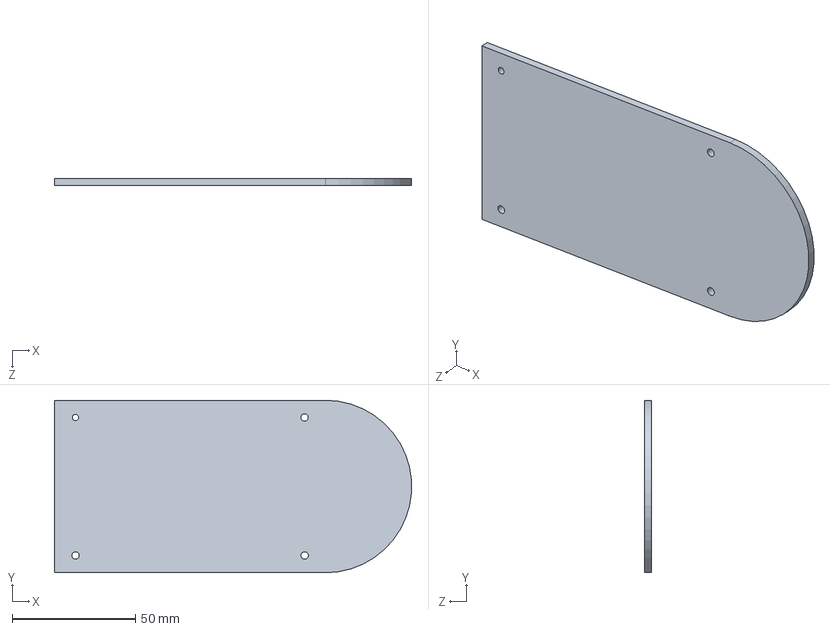
[picture p85: CAD file, 2021-10-29]
Panel/Panel 2/Panel back.SLDPRT
144.9 x 70.0 x 3.00 mm
