lpgn/Carbon-Mini/STL/Rail to tracks Extruder's adapter2.STL

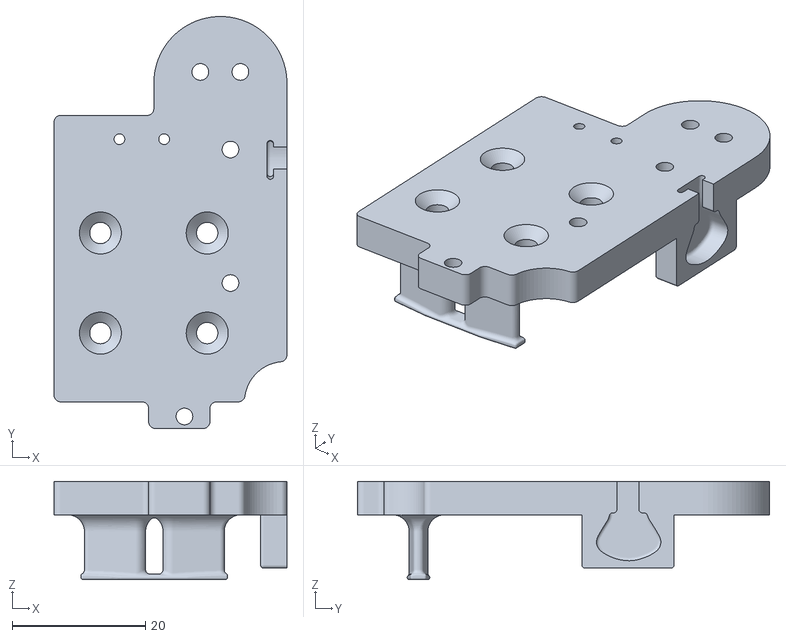
[picture p86: CAD file, 2021-10-29]
STL/Rail to tracks Extruder's adapter2.STL
34.9 x 61.7 x 14.7
