lpgn/Carbon-Mini/TO CNC/CONECTION.SLDPRT

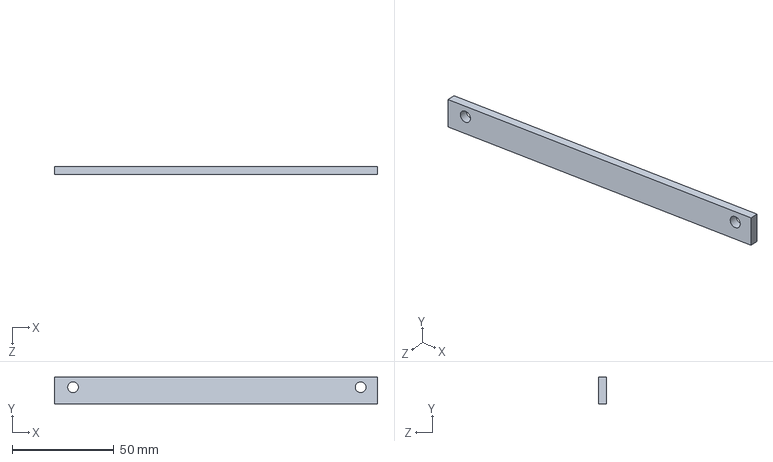
[picture p87: CAD file, 2021-10-29]
TO CNC/CONECTION.SLDPRT
159.0 x 13.1 x 4.00 mm
