lpgn/Carbon-Mini/Bed Assembly/Glassbed.SLDPRT

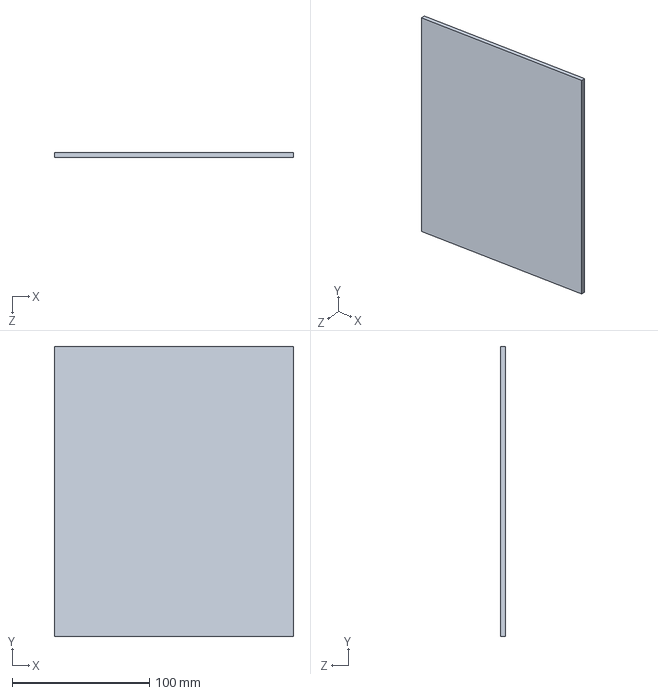
[picture p88: CAD file, 2021-10-29]
Bed Assembly/Glassbed.SLDPRT
174.1 x 211.0 x 4.00 mm
