lpgn/Carbon-Mini/Extruder cold end/Mini CF Steper Motor mm.SLDPRT

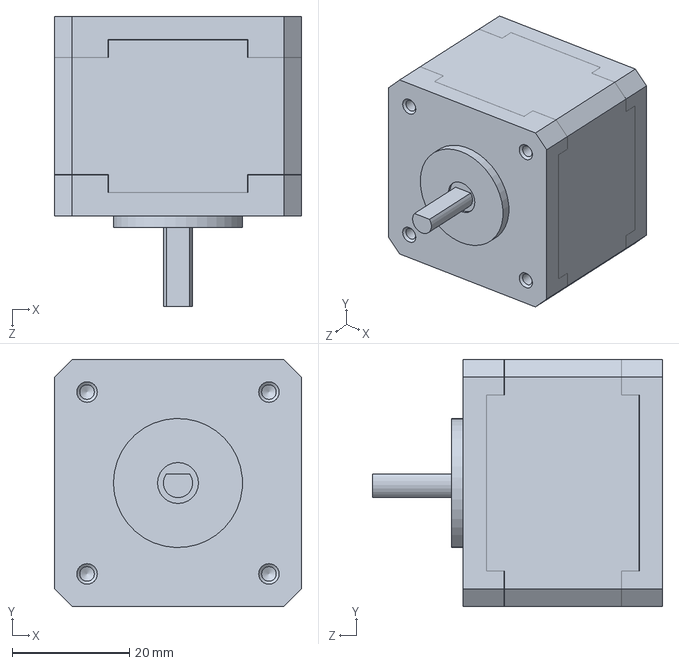
[picture p89: CAD file, 2021-10-29]
Extruder cold end/Mini CF Steper Motor mm.SLDPRT
42.1 x 42.1 x 49.5 mm
