lpgn/Carbon-Mini/officialE3DV6fanduct1.SLDPRT

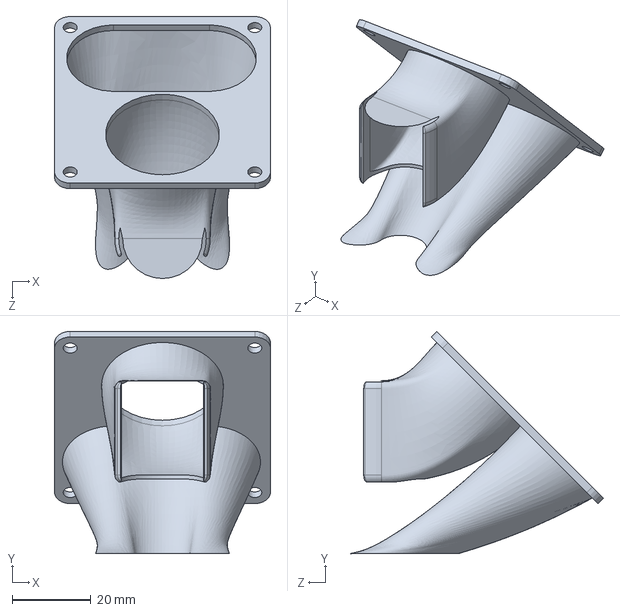
[picture p90: CAD file, 2021-10-29]
officialE3DV6fanduct1.SLDPRT
55.0 x 56.6 x 66.7 mm
