lpgn/Carbon-Mini/STP files/Z Frame2.STEP

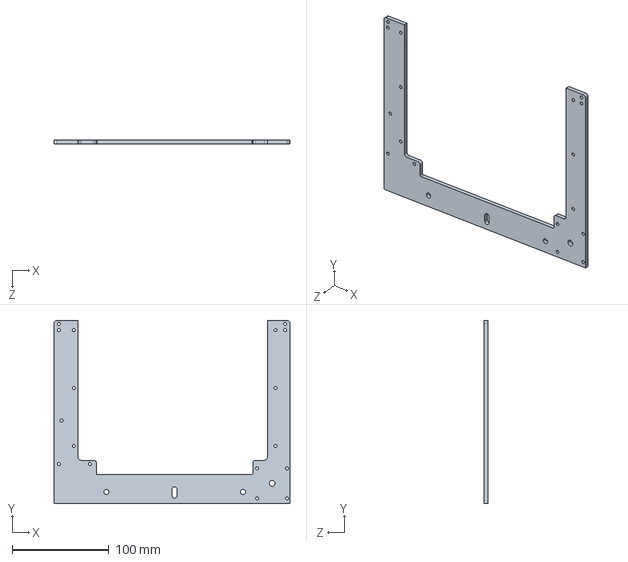
[picture p91: CAD file, 2021-10-29]
STP files/Z Frame2.STEP
244.5 x 190.0 x 4.00 mm
