lpgn/Carbon-Mini/Xbridge/Mini CF X Motor atachment.SLDPRT

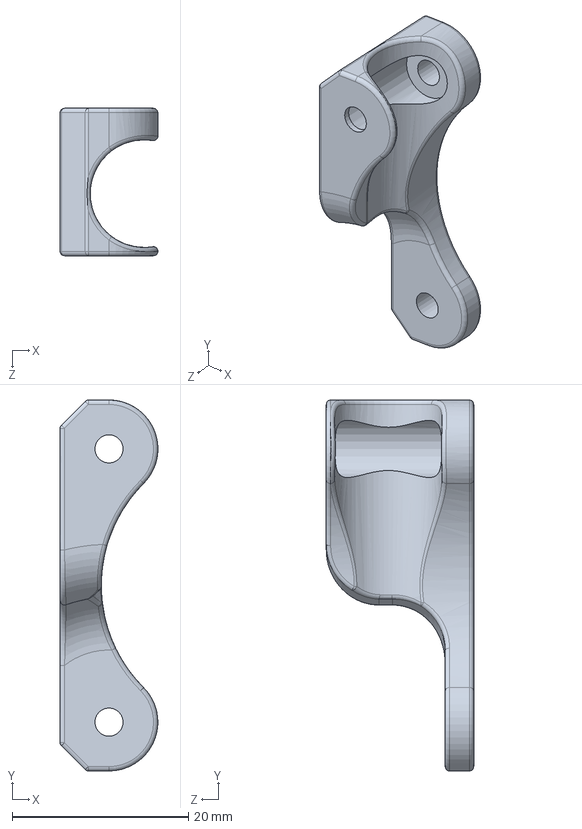
[picture p92: CAD file, 2021-10-29]
Xbridge/Mini CF X Motor atachment.SLDPRT
11.1 x 42.1 x 16.7 mm
