lpgn/Carbon-Mini/Y table support Assembly/Printrboard1.SLDPRT

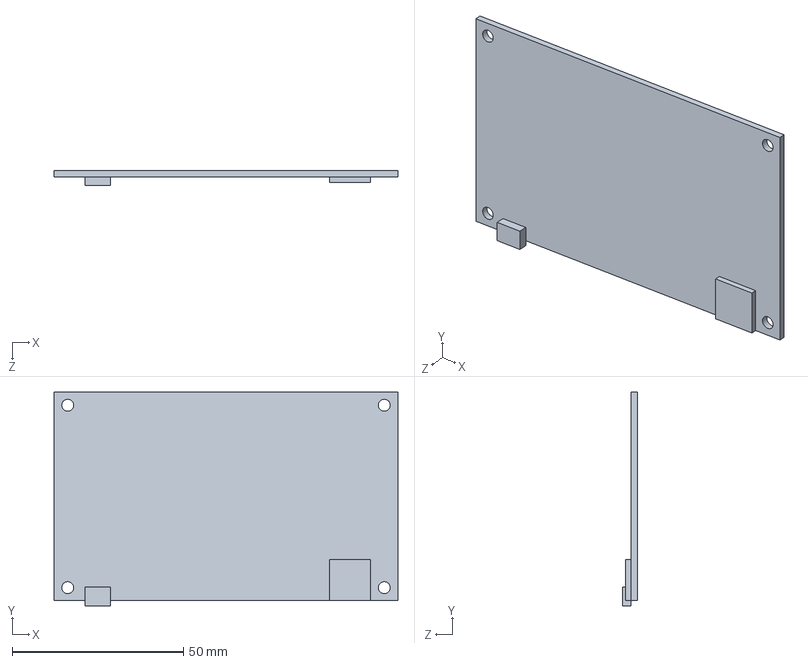
[picture p93: CAD file, 2021-10-29]
Y table support Assembly/Printrboard1.SLDPRT
100.5 x 62.4 x 4.30 mm
