lpgn/Carbon-Mini/Copy of Printrboard Printed case-surface.sldprt

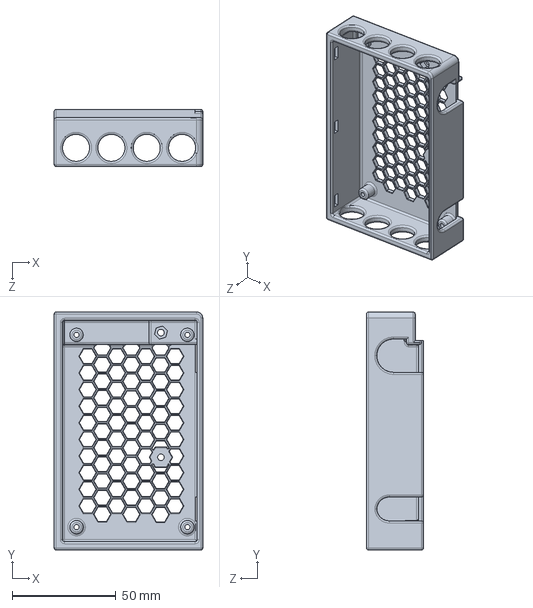
[picture p94: CAD file, 2021-10-29]
Copy of Printrboard Printed case-surface.sldprt
71.6 x 114.5 x 27.5 mm
