lpgn/Carbon-Mini/Laser/Diodea.SLDPRT

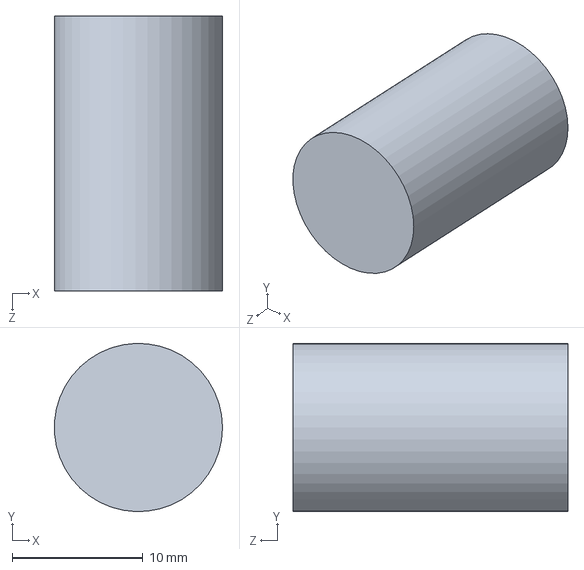
[picture p95: CAD file, 2021-10-29]
Laser/Diodea.SLDPRT
12.8 x 12.8 x 21.0 mm
