lpgn/Carbon-Mini/Xbridge/Endstop Assembly - small.SLDASM

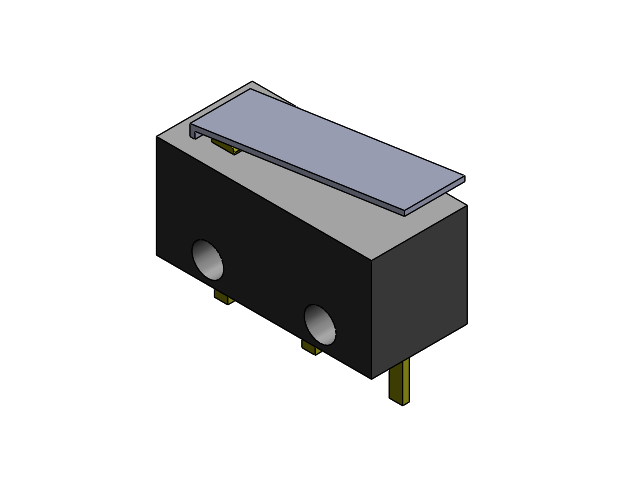
[picture p96: CAD file, 2021-10-29]
Xbridge/Endstop Assembly - small.SLDASM
Endstop Actuator 1
Enstop Base 1
