lpgn/Carbon-Mini/Y table support Assembly/Bearing assembly1.sldasm

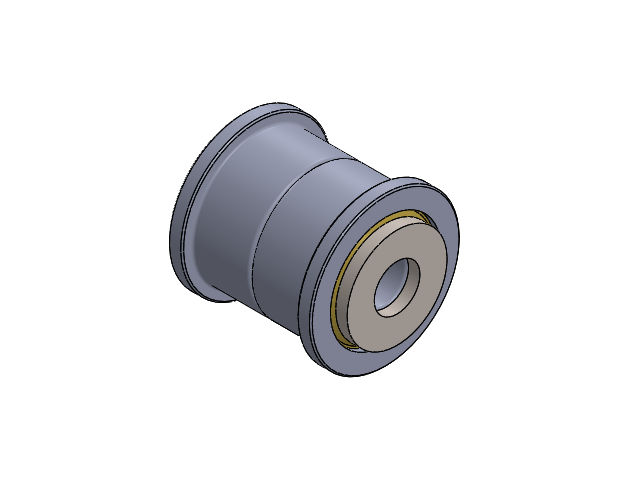
[picture p97: CAD file, 2021-10-29]
Y table support Assembly/Bearing assembly1.sldasm
Idler Bearing (F603HZZ) part 1 x 2
Idler Bearing (F603HZZ) part 2 x 2
Idler Bearing (F603HZZ) part 3 x 2
plain washer 10673 type snl_iso1
