lpgn/Carbon-Mini/Extruder with tracks revised/Hotend (E3D).SLDASM

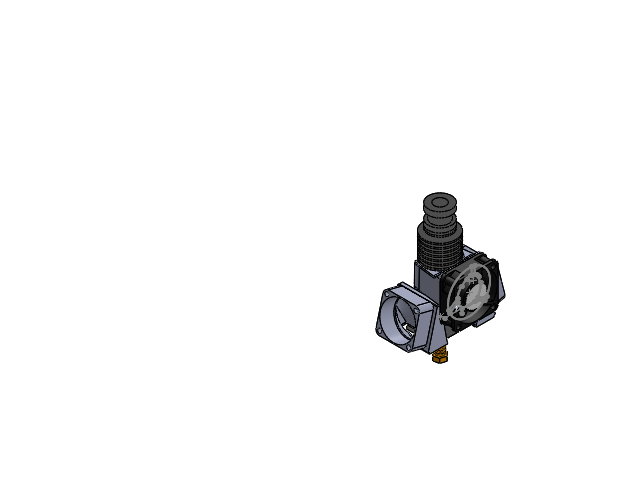
[picture p98: CAD file, 2021-10-29]
Extruder with tracks revised/Hotend (E3D).SLDASM
Heat Breaker (Hotend)
Heatsink (Hotend)
Heat Block (hotend)
Nozzle (0.4) (Hotend)
pan head cross recess screw_iso1
