lpgn/Carbon-Mini/Y table support Assembly/Idler Bearing (F603HZZ) Assembly-surface.SLDASM

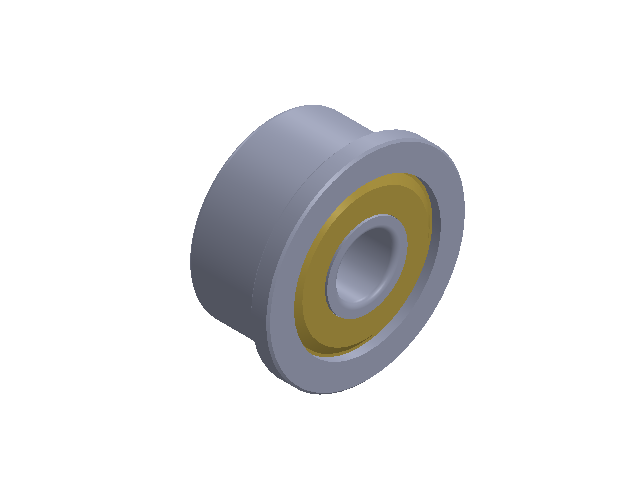
[picture p99: CAD file, 2021-10-29]
Y table support Assembly/Idler Bearing (F603HZZ) Assembly-surface.SLDASM
Idler Bearing (F603HZZ) part 1
Idler Bearing (F603HZZ) part 2
Idler Bearing (F603HZZ) part 3
