lpgn/Carbon-Mini/(list of files, cad)

Other CAD files:
Y table support Assembly/Y motor assembly.SLDASM
Frame Assembly/Prescision tool/bed calibration device-surface.SLDASM
Xbridge/X Track Assembly.SLDASM
Bed Assembly/Track Assembly.SLDASM
TO CNC/Z AND Y FRAME PLUS SMALL ONES3.SLDASM
Y table support Assembly/Y motor assembly-surface.SLDASM
Frame Assembly/Knurl Adjuster's assembly-surface.sldasm
Bed Assembly/Track Assembly-surface.SLDASM
Y table support Assembly/MAGNETMOUNT.sldasm
TO CNC/X FRAME incomplete 0.6mm increment.SLDASM
Xbridge/Endstop Assembly - small-surface.SLDASM
Y table support Assembly/Hinge Assembly.SLDASM
Panel/Panel 2/New Panel Box-surface.SLDASM
TO CNC/Z AND Y FRAME PLUS SMALL ONES4.SLDASM
Frame Assembly/Z Tracks Assembly-surface.sldasm
Extruder with tracks revised/Extruder Endstop Assembly - small-surface.SLDASM
Xbridge/F603HZZ-surface.SLDASM
Xbridge/F603HZZ.SLDASM
Frame Assembly/Magnet Assembly.SLDASM
Frame Assembly/Hinge 20x20 Assembly.SLDASM
Y table support Assembly/Endstop Assembly (HT-010-1A-250VAC) - small-surface.SLDASM
Y table support Assembly/Rail Assembly-surface.SLDASM
Frame Assembly/Z Tracks Assembly.sldasm
Frame Assembly/Base Assembly-surface.SLDASM
Extruder with tracks revised/BBBBBB Mini CFMini CFMini CFMini Endstop Assembly - small.SLDASM
Y table support Assembly/Endstop assembly-surface.sldasm
Frame Assembly/Knurl Adjuster's assembly.sldasm
Xbridge/SUB X.SLDASM
Y table support Assembly/Endstop Assembly (HT-010-1A-250VAC) - small.SLDASM
Y table support Assembly/Endstop Assembly - small.SLDASM
Frame Assembly/Frame assembly1.SLDASM
Xbridge/Assem1.sldasm
Extruder with tracks revised/EXTRUDER.SLDASM
Y table support Assembly/Idler Bearing (F603HZZ) Assembly.SLDASM
Extruder with tracks revised/Hotend (E3D)-surface.SLDASM
Extruder with tracks revised/Extruder Endstop Assembly - small.SLDASM
Extruder with tracks revised/Extruder with tracks3b.SLDASM
Y table support Assembly/Idler Bearing (F603HZZ) part 1-surface.sldprt
BELT HOLDER.SLDPRT
Laser/Part4.sldprt
Panel/Panel/Panel2.SLDPRT
Laser/Lens.sldprt
officialE3DV6fanduct-surface-2.SLDPRT
Panel/Panel/Panel back.SLDPRT
STP files/X Bridge 4.STEP
TO LASER CUT/Z AND Y FRAME PLUS SMALL ONES3.DWG
Frame Assembly/CF Mini Z Motor mount.SLDPRT
Laser/Part2.sldprt
Panel/Panel 2/panel case printed2.SLDPRT
TO LASER CUT/Printer.DWG
Extruder cold end/Extruder Gear.SLDPRT
Bed Assembly/Acrilyc 5mm washer.sldprt
Bed Assembly/Copy of glassbed.sldprt
Bed Assembly/Mini CF Magnet 12X3.79mm.sldprt
Bed Assembly/Mini CF200x300WP1 TF4 Acrilyc 5mm washer^TF4 x axis-surface.sldprt
Bed Assembly/Mini CF200x300WP1 TF4 Acrilyc 5mm washer^TF4 x axis.sldprt
Bed Assembly/Mini CF200x300WP1 TF4 Y Track.SLDPRT
Bed Assembly/TABLE2.sldprt
Bed Assembly/Y Track (MGN9 190mm)-surface.SLDPRT
Bed Assembly/Y Track (MGN9 190mm).SLDPRT
Bed Assembly/Y Tracks conection.SLDPRT
Bed Assembly/temp glass.SLDPRT
Copy of Part2^Printerboard box.sldprt
Copy of Part2^Printerboard box0-surface.sldprt
Copy of Part2^Printerboard box0.sldprt
Copy of Printrboard Printed case.sldprt
Copy of Printrboard Printed case2.sldprt
Extruder cold end/Bearing for Filament (U694)-surface.SLDPRT
Extruder cold end/Bearing for Filament (U694).SLDPRT
Extruder cold end/Extruder Bracket (mirrored).SLDPRT
Extruder cold end/Extruder Bracket (mirrored).STL
Extruder cold end/Extruder Bracket (mirrored)hacked for no bolden treaded.SLDPRT
Extruder cold end/Extruder Bracket (mirrored)hacked for no bolden.SLDPRT
Extruder cold end/Extruder Lever (mirrored) 2.SLDPRT
Extruder cold end/Extruder Lever (mirrored) 3.SLDPRT
Extruder cold end/Extruder Lever (mirrored) 4.SLDPRT
Extruder cold end/Extruder Lever (mirrored).SLDPRT
Extruder cold end/Extruder Steper Motor (needs reference).SLDPRT
Extruder cold end/Extruder Steper Motor (needs reference)2-surface.SLDPRT
Extruder cold end/Extruder Steper Motor (needs reference)2.SLDPRT
Extruder cold end/Stepper Motor - Extruder.SLDPRT
Extruder cold end/Tube (bushings).SLDPRT
Extruder cold end/bush.SLDPRT
Extruder cold end/clip.SLDPRT
Extruder cold end/mirror.SLDPRT
Extruder cold end/motor_bracket.SLDPRT
Extruder cold end/screw.SLDPRT
Extruder cold end/special_bearing.SLDPRT
Extruder cold end/washer m4 .75mm.SLDPRT
Extruder cold end/washer.SLDPRT
Extruder with tracks revised/BBE3D Hotend block.sldprt
Extruder with tracks revised/BBE3D Hotend heatsink.sldprt
Extruder with tracks revised/BBE3D Hotend nozzle.sldprt
Extruder with tracks revised/EXTRUDER ADAPTER mirror.SLDPRT
Extruder with tracks revised/EXTRUDER ADAPTER.SLDPRT
Extruder with tracks revised/Endstop Actuator-surface.SLDPRT
Extruder with tracks revised/Endstop Actuator.SLDPRT
Extruder with tracks revised/Extruder stopper2.SLDPRT
Extruder with tracks revised/FAN - Heat Sink.SLDPRT
Extruder with tracks revised/FAN for Heat Sink (Hotend)-surface-2.SLDPRT
Extruder with tracks revised/FAN for Heat Sink (Hotend)-surface.SLDPRT
Extruder with tracks revised/FAN for Heat Sink (Hotend).SLDPRT
Extruder with tracks revised/Fan duct hacked (Hotend)1.SLDPRT
Extruder with tracks revised/Fan duct hacked (Hotend)2.SLDPRT
Extruder with tracks revised/Fan duct hacked (Hotend)3.SLDPRT
Extruder with tracks revised/Heat Block (hotend)-surface.sldprt
Extruder with tracks revised/Heat Block (hotend).sldprt
Extruder with tracks revised/Heat Breaker (Hotend)-surface.SLDPRT
Extruder with tracks revised/Heat Breaker (Hotend).SLDPRT
Extruder with tracks revised/Heatsink (Hotend)-surface.sldprt
Extruder with tracks revised/Heatsink (Hotend).sldprt
Extruder with tracks revised/Hotend bracket-surface.SLDPRT
Extruder with tracks revised/Hotend bracket.SLDPRT
Extruder with tracks revised/Mini CF rail mgnr_9_r_600_c__patin_mgn_9_h_zf_c_02.SLDPRT
Extruder with tracks revised/Mini Enstop Base-surface.SLDPRT
Extruder with tracks revised/Mini Enstop Base.SLDPRT
Extruder with tracks revised/Nozzle (0.4) (Hotend)-surface.sldprt
Extruder with tracks revised/Nozzle (0.4) (Hotend).sldprt
Extruder with tracks revised/Part2.sldprt
Extruder with tracks revised/Part4.sldprt
Extruder with tracks revised/Rail (MGN-9) (for extruder)-surface.SLDPRT
Extruder with tracks revised/Rail (MGN-9) (for extruder).SLDPRT
Extruder with tracks revised/Rail (MGN9) (for extruder with tracks)-surface.SLDPRT
Extruder with tracks revised/Rail (MGN9) (for extruder with tracks).SLDPRT
Extruder with tracks revised/Rail (MGN9) (for extruder).SLDPRT
Extruder with tracks revised/Rail to tracks Extruder's adapter.SLDPRT
Extruder with tracks revised/Rail to tracks Extruder's adapter2.SLDPRT
Extruder with tracks revised/Rail to tracks Extruder's adapter3.SLDPRT
Extruder with tracks revised/Rail to tracks Extruder's adapter4.SLDPRT
Extruder with tracks revised/Rail to tracks Extruder's adapter5-surface.SLDPRT
Extruder with tracks revised/Rail to tracks Extruder's adapter5.SLDPRT
Extruder with tracks revised/Small Fan Mockup (hotend)-surface.SLDPRT
Extruder with tracks revised/Small Fan Mockup (hotend).SLDPRT
Extruder with tracks revised/Small Fan Mockup.SLDPRT
Extruder with tracks revised/TF4 rail_mgnr_9_r_600_c__patin_mgn_9_c_zf_c_02.SLDPRT
Extruder with tracks revised/Track Autocalibration-surface.SLDPRT
Extruder with tracks revised/Track Autocalibration.SLDPRT
Extruder with tracks revised/e3d fan duct hacked 3.SLDPRT
Frame Assembly/Adjustable table mount2-MBP.SLDPRT
Frame Assembly/Adjustable table mount3SLDPRT.SLDPRT
Frame Assembly/FOOT.SLDPRT
Frame Assembly/Hinge 20x20l.SLDPRT
Frame Assembly/Hinge 30x30.SLDPRT
Frame Assembly/Knurl Adjuster.SLDPRT
Frame Assembly/L shaped conector-surface.sldprt
Frame Assembly/L shaped conector.sldprt
Frame Assembly/Magnet (12x3.79mm)-surface.sldprt
Frame Assembly/Magnet (12x3.79mm).sldprt
Frame Assembly/Mini CF Magnet 12X3.79mm.sldprt
Frame Assembly/Mini CF200x300CF3DWP1 Steper Motor 34mm.SLDPRT
Frame Assembly/Mini CF200x300CF3DWP1 Z TRACK.SLDPRT
Frame Assembly/Mini CFMini CF200x300CF3DWP1TF4 Hinge.SLDPRT
Frame Assembly/Mini CFMini CF200x300CF3DWP1TF4 Hingesmall.SLDPRT
Frame Assembly/Part3.SLDPRT
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
