lpgn/Carbon-Mini/BOM/CALCULATION steps per mm.ods

Steps per mm = (((360/Motor step angle) * (1/Driver microstepping))/Leadscrew pitch)*(Leadscrew pulley teeth count / Motor pulley teeth count)
Motor step angle | Driver microstepping | Leadscrew pitch | Leadscrew pulley teeth count | Motor pulley teeth count
1.8 | 0.0625 | 5.014 | 1 | 1
638.2130035899
M92 X63.0542
M92 Y63.0542
M92 Z638.21
M92 E638.21
http://prusaprinters.org/calculator/
